z2labs/Bassberry/enclosure/README.md

# Enclosure

3D-printable enclosure (STEP + STL) - coming. Dimensions and chamber volumes: [../docs/acoustics.md](../docs/acoustics.md).
