z2labs/Bassberry/docs/img/pcb_bottom.png

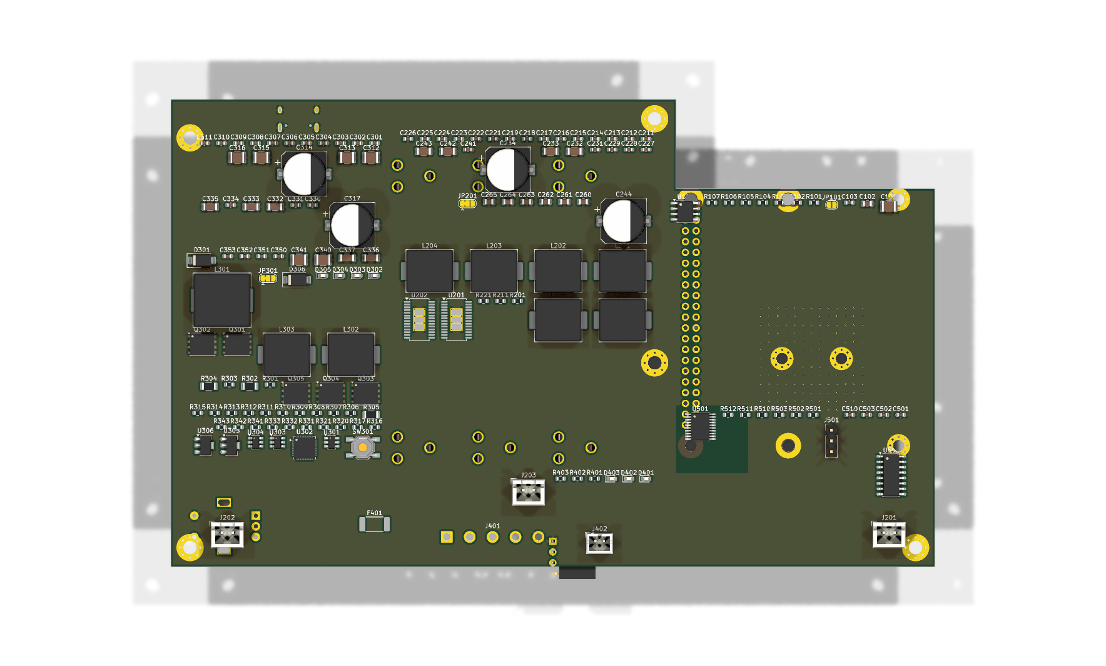
docs/img/pcb_bottom.png
