z2labs/Bassberry/docs/img/pcb_top.png

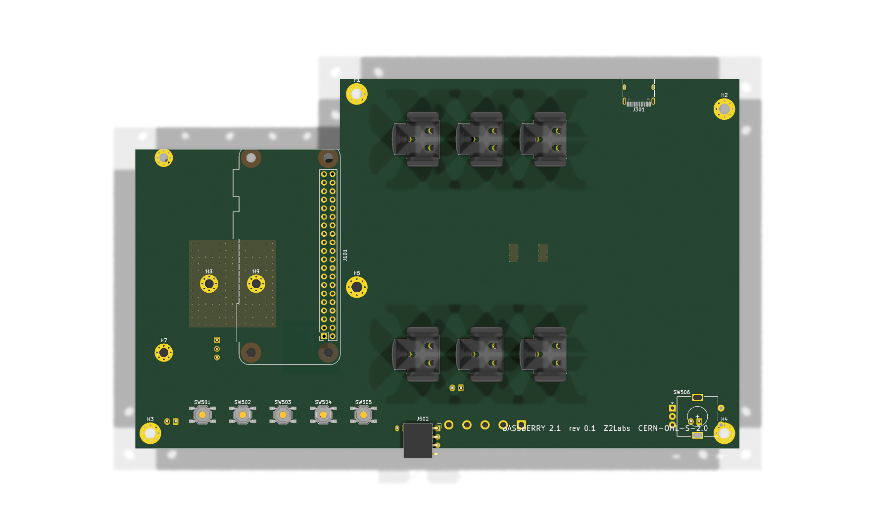
docs/img/pcb_top.png
