z2labs/Bassberry/hardware/bassberry/jlc/gerber_check.png

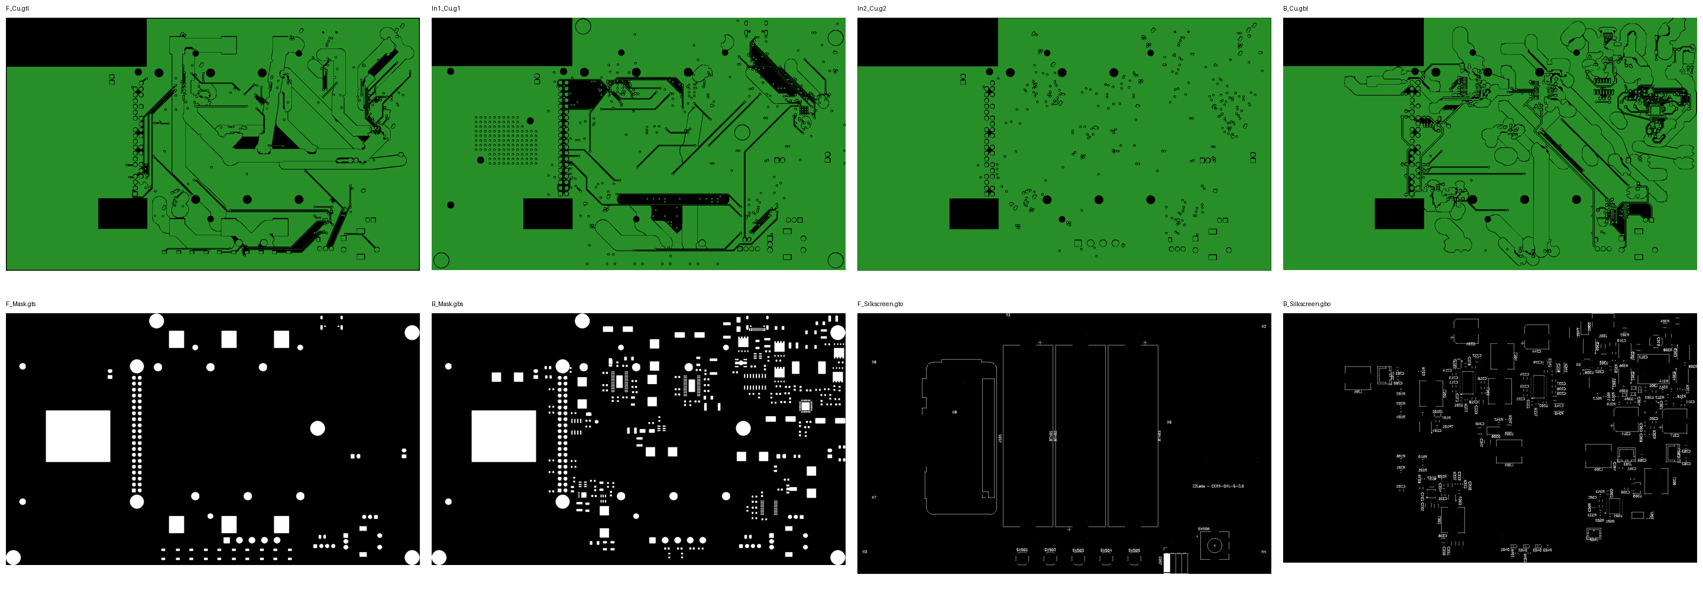
hardware/bassberry/jlc/gerber_check.png
