z2labs/Bassberry/docs/bom.md

# Bill of materials (draft)

Design rule: **cheap and easy to get**. Every electronic part should be stocked at LCSC / common distributors, and the mechanical parts should be printable or generic.
Prices are rough single-unit estimates (October 2026) and will change. *(tbc)* = to be confirmed in the schematic phase.

## Electronics

| Block | Part (proposal) | Qty | Why |
|---|---|---|---|
| Satellite amp | TI TAS5805M | 1 | I2S DAC + class-D + DSP in one chip, cheap, existing open Linux driver |
| Sub amp | TI TAS5805M (PBTL) | 1 | same part, so one footprint and one driver |
| PD sink + 3S charger | Injoinic IP2366 (QFN40) + 4× 30–40 V N-MOSFET (TDSON-8) + 22 µH | 1 | one chip for PD input and 2–6S buck-boost charging, mass-market part |
| Pack protection | off-the-shelf 3S BMS module (B-, B1, B2, B+, P-), 10 A fuse | 1 set | cheap, standard power-bank parts |
| 5.1 V / 5 A buck | TI TPS565208 (SOT-23-6) + 4.7 µH | 1 | enough for a Pi 5 |
| 17 V boost (optional) | MT3608 + SS34 | 1 | footprint present, can stay unfitted (PVDD_SUB jumper) |
| Supervisor MCU | WCH CH32V003 | 1 | costs a few cents, handles buttons, encoder and power latch |
| USB-UART | WCH CH340C + Torex XC6216B332PR (28 V LDO from VBUS) | 1 + 1 | serial console over the same USB-C port |
| Display | 1.3" I2C OLED module, 4-pin | 1 | everywhere, ≈ 2–3 |
| Encoder | EC11 with push switch | 1 | |
| Buttons | 6 × 6 mm tact switches | 5 | |
| 2×20 socket | standard 8.5 mm female header | 1 | |
| HAT ID EEPROM | onsemi CAT24C32 (SOIC-8) | 1 | the Pi detects the board as a HAT+ and loads its overlay |
| Back-power ideal diode | Diodes DMP3013SFV + DMMT5401 | 1 + 1 | HAT design guide safety diode, rated for the Pi 5's 5 A |
| Battery holders | Keystone 1042 (or any pin-compatible 18650 SMT holder) | 3 | snap-in, spring metal contacts, SMD |
| Thermal | aluminium block 24 × 24 × 6.7 mm + 1.5–2 mm gap pad | 1 | cut from bar stock, or a generic Pi heatsink |

## Acoustics

| Role | Reference (simulated) | Approx. price | Budget option |
|---|---|---|---|
| Satellites | 2× Dayton CE54N-4 | ≈ 12 each | generic 2" 4 Ω full-range, 52–54 mm frame |
| Sub | 1× Dayton ND91-4 | ≈ 28 | generic 3–3.5" long-throw BT-speaker woofer |
| Passive radiators | 2× Dayton DMA70-PR | ≈ 12 each | generic 2.5" rubber passive radiators (tune with added mass) |

The sub is where cheap parts hurt most. See the comparison in [acoustics.md](acoustics.md).
With generic drivers, measure their T/S parameters and re-run `acoustics/sim.py`.

## Mechanical

* Printed enclosure (PETG recommended), 2.5 mm walls, 100 % infill around the driver baffles, gasket on the acoustic divider
* Polyester fill in the satellite chambers
* 4 rubber feet, 18 mm (sub clearance)
* M2.5 hardware for the Pi, M3 for the enclosure
* Perforated metal or printed front grille
