z2labs/Bassberry/hardware/bassberry/jlc/lcsc_parts.csv

value | footprint | refs | lcsc | mpn | manufacturer | package | basic_or_extended | smt_or_tht | key_spec | verified_url | notes
10A fast 2512 | Fuse_2512_6332Metric | F401 | C44479 | 0451010.MRL | Littelfuse | 2410 (6.1x2.5mm) | Extended | SMT | 10A 125VDC very fast-acting NANO2, IR 35/50A | https://jlcpcb.com/partdetail/C44479 | Confirmed by Zoltan 2026-10-27 (in stock). No true 2512 (6332) 10A SMD fuse found at JLC/LCSC; nearest is 2410/6125 body - fits on 2512 pads in practice but better to change footprint to a 2410/NANO2 land pattern. LCSC stock ~28k. Note: 50A interrupt rating is low for a 3S 18650 pack short-circuit current
0R (V3=VCC for 3V3 op.) | R_0603_1608Metric | R512 | C21189 | 0603WAF0000T5E | UNI-ROYAL | 0603 | Basic | SMT | 0R jumper 100mW | https://jlcpcb.com/partdetail/C21189 | Confirmed by Zoltan 2026-10-27 (in stock).
10 | R_0603_1608Metric | R303 R306 | C22859 | 0603WAF100JT5E | UNI-ROYAL | 0603 | Basic | SMT | 10R 1% 100mW | https://jlcpcb.com/partdetail/C22859 | Confirmed by Zoltan 2026-10-27 (in stock).
100 | R_0603_1608Metric | R316 R317 | C22775 | 0603WAF1000T5E | UNI-ROYAL | 0603 | Basic | SMT | 100R 1% 100mW | https://jlcpcb.com/partdetail/C22775 | Confirmed by Zoltan 2026-10-27 (in stock).
100k | R_0603_1608Metric | R333 R343 | C25803 | 0603WAF1003T5E | UNI-ROYAL | 0603 | Basic | SMT | 100k 1% 100mW | https://jlcpcb.com/partdetail/C25803 | Confirmed by Zoltan 2026-10-27 (in stock).
100k 1% | R_0603_1608Metric | R502 | C25803 | 0603WAF1003T5E | UNI-ROYAL | 0603 | Basic | SMT | 100k 1% 100mW | https://jlcpcb.com/partdetail/C25803 | Confirmed by Zoltan 2026-10-27 (in stock).
10k | R_0603_1608Metric | R106 R201 R202 R315 R501 | C25804 | 0603WAF1002T5E | UNI-ROYAL | 0603 | Basic | SMT | 10k 1% 100mW | https://jlcpcb.com/partdetail/C25804 | Confirmed by Zoltan 2026-10-27 (in stock). LCSC page showed out of stock at check time; JLC basic stock is normally huge - check at order
10k 1% | R_0603_1608Metric | R108 R332 | C25804 | 0603WAF1002T5E | UNI-ROYAL | 0603 | Basic | SMT | 10k 1% 100mW | https://jlcpcb.com/partdetail/C25804 | Confirmed by Zoltan 2026-10-27 (in stock). see 10k row
15k | R_0603_1608Metric | R211 | C22809 | 0603WAF1502T5E | UNI-ROYAL | 0603 | Basic | SMT | 15k 1% 100mW | https://jlcpcb.com/partdetail/C22809 | Confirmed by Zoltan 2026-10-27 (in stock).
1k | R_0603_1608Metric | R107 R510 R511 | C21190 | 0603WAF1001T5E | UNI-ROYAL | 0603 | Basic | SMT | 1k 1% 100mW | https://jlcpcb.com/partdetail/C21190 | Confirmed by Zoltan 2026-10-27 (in stock).
2 | R_0603_1608Metric | R307 R308 R309 R320 R321 | C22977 | 0603WAF200KT5E | UNI-ROYAL | 0603 | Basic | SMT | 2R 1% 100mW | https://jlcpcb.com/partdetail/C22977 | Confirmed by Zoltan 2026-10-27 (in stock).
22k 1% | R_0603_1608Metric | R503 | C31850 | 0603WAF2202T5E | UNI-ROYAL | 0603 | Basic | SMT | 22k 1% 100mW | https://jlcpcb.com/partdetail/C31850 | Confirmed by Zoltan 2026-10-27 (in stock).
2k2 | R_0603_1608Metric | R401 R402 R403 | C4190 | 0603WAF2201T5E | UNI-ROYAL | 0603 | Basic | SMT | 2.2k 1% 100mW | https://jlcpcb.com/partdetail/C4190 | Confirmed by Zoltan 2026-10-27 (in stock).
2k2 1% | R_0603_1608Metric | R342 | C4190 | 0603WAF2201T5E | UNI-ROYAL | 0603 | Basic | SMT | 2.2k 1% 100mW | https://jlcpcb.com/partdetail/C4190 | Confirmed by Zoltan 2026-10-27 (in stock).
33 | R_0603_1608Metric | R101 R102 R103 | C23140 | 0603WAF330JT5E | UNI-ROYAL | 0603 | Basic | SMT | 33R 1% 100mW | https://jlcpcb.com/partdetail/C23140 | Confirmed by Zoltan 2026-10-27 (in stock).
3k6 1% | R_0603_1608Metric | R312 | C22980 | 0603WAF3601T5E | UNI-ROYAL | 0603 | Basic | SMT | 3.6k 1% 100mW | https://jlcpcb.com/partdetail/C22980 | Confirmed by Zoltan 2026-10-27 (in stock).
3k9 | R_0603_1608Metric | R104 R105 | C23018 | 0603WAF3901T5E | UNI-ROYAL | 0603 | Basic | SMT | 3.9k 1% 100mW | https://jlcpcb.com/partdetail/C23018 | Confirmed by Zoltan 2026-10-27 (in stock).
43k | R_0603_1608Metric | R314 | C23172 | 0603WAF4302T5E | UNI-ROYAL | 0603 | Extended | SMT | 43k 1% 100mW | https://jlcpcb.com/partdetail/C23172 | Confirmed by Zoltan 2026-10-27 (in stock). No Basic 43k; LCSC stock ~113k
47k | R_0603_1608Metric | R221 | C25819 | 0603WAF4702T5E | UNI-ROYAL | 0603 | Basic | SMT | 47k 1% 100mW | https://jlcpcb.com/partdetail/C25819 | Confirmed by Zoltan 2026-10-27 (in stock).
47k 1% | R_0603_1608Metric | R109 | C25819 | 0603WAF4702T5E | UNI-ROYAL | 0603 | Basic | SMT | 47k 1% 100mW | https://jlcpcb.com/partdetail/C25819 | Confirmed by Zoltan 2026-10-27 (in stock).
51 | R_0603_1608Metric | R301 | C23197 | 0603WAF510JT5E | UNI-ROYAL | 0603 | Basic | SMT | 51R 1% 100mW | https://jlcpcb.com/partdetail/C23197 | Confirmed by Zoltan 2026-10-27 (in stock).
57k6 1% | R_0603_1608Metric | R331 | C245983 | RC0603FR-0757K6L | YAGEO | 0603 | Extended | SMT | 57.6k 1% 100mW | https://jlcpcb.com/partdetail/C245983 | Confirmed by Zoltan 2026-10-27 (in stock). LCSC stock only ~400 at check time - OK for small runs; Uniroyal 0603WAF5762T5E not found at LCSC
60k4 1% | R_0603_1608Metric | R341 | C165742 | RC0603FR-0760K4L | YAGEO | 0603 | Extended | SMT | 60.4k 1% 100mW | https://jlcpcb.com/partdetail/C165742 | Confirmed by Zoltan 2026-10-27 (in stock). LCSC stock ~66k
6k2 1% | R_0603_1608Metric | R311 | C4260 | 0603WAF6201T5E | UNI-ROYAL | 0603 | Basic | SMT | 6.2k 1% 100mW | https://jlcpcb.com/partdetail/C4260 | Confirmed by Zoltan 2026-10-27 (in stock). Part/value verified (LCSC stock ~742k); fetched JLC page did not show the Basic label explicitly - Basic per JLC basic list
9k1 1% | R_0603_1608Metric | R313 | C286595 | RS-03K9101FT | FH (Fenghua) | 0603 | Extended | SMT | 9.1k 1% 100mW | https://jlcpcb.com/partdetail/C286595 | Confirmed by Zoltan 2026-10-27 (in stock). No Basic 9.1k found; LCSC stock ~162k
NC | R_0603_1608Metric | R310 | DNP |  |  |  |  | SMT |  |  | DNP
0R (bypass Q5) | R_1206_3216Metric | R305 | C346502 | HCJ1206ZT0R00 | Stackpole (SEI) | 1206 | Extended | SMT | 0R <=0.5mOhm, rated 38.7A (datasheet) | https://jlcpcb.com/partdetail/C346502 | Confirmed by Zoltan 2026-10-27 (in stock). Standard thick-film 1206 0R (e.g. C17888 1206W4F0000T5E) is typ. 2A only - not enough for 3A. LCSC stock ~3150
5m 1% 1206 | R_1206_3216Metric | R302 R304 | C601096 | HoLR1206-1W-5mR-1%-75ppm | Milliohm | 1206 | Extended | SMT | 5mOhm 1% 1W alloy, 75ppm/K | https://jlcpcb.com/partdetail/C601096 | Confirmed by Zoltan 2026-10-27 (in stock). LCSC stock ~10.6k. Alternatives: Yageo PA1206FRE470R005L C723548 (50ppm; out of stock) / Bourns CRF1206-FZ-R005ELF C4215834 (stock 47)
0R 2512 (PVDD_SUB = battery) | R_2512_6332Metric | R344 | C346503 | HCJ2512ZT0R00 | Stackpole (SEI) | 2512 | Extended | SMT | 0R <=0.5mOhm, 2W, rated 63.2A (datasheet) | https://jlcpcb.com/partdetail/C346503 | Confirmed by Zoltan 2026-10-27 (in stock). LCSC stock ~3980
DNP 0R 2512 (PVDD_SUB = boost) | R_2512_6332Metric | R345 | DNP |  |  |  |  | SMT |  |  | DNP (if fitted use C346503)
220u 35V polymer | CP_Elec_10x10.5 | C314 C317 | C278516 | EEHZK1V331P | Panasonic | SMD D10xL10.2mm | Extended | SMT | 330uF 35V hybrid polymer Al; ESR 20mOhm | https://jlcpcb.com/partdetail/C278516 | Confirmed by Zoltan 2026-10-27 (in stock). Nearest STOCKED fit: 330uF instead of 220uF (LCSC 4869 pcs on 2026-10-27). Exact 220uF/35V EEHZA1V221P C454349 (D10xL10.2, ESR 20mOhm, 2.5A@100kHz) exists but LCSC shows Out of Stock; alt Rubycon 35PJV330M10X10.5 C3274921 (330uF 35V hybrid, 1000 pcs)
470u 25V low-ESR | CP_Elec_10x10.5 | C234 C244 | C248607 | EEEFK1E471P | Panasonic | SMD D10xL10.2mm | Extended | SMT | 470uF 25V Al electrolytic FK low-impedance series; 105C 2000h | https://jlcpcb.com/partdetail/C248607 | Confirmed by Zoltan 2026-10-27 (in stock). LCSC stock 7217. ESR not listed on page (FK series is Panasonic's low-Z line, check datasheet if ripple critical). Hybrid-polymer alt: Rubycon 25PJV470MSPA10X10.5 C239327 (2315 pcs)
100n | C_0603_1608Metric | C103 C104 C212 C222 C307 C330 C501 C503 C510 | C14663 | CC0603KRX7R9BB104 | YAGEO | 0603 | Basic | SMT | 100nF 50V X7R 10% | https://jlcpcb.com/partdetail/C14663 | Confirmed by Zoltan 2026-10-27 (in stock).
100n 50V | C_0603_1608Metric | C219 C229 C231 C241 C308 C309 C334 | C14663 | CC0603KRX7R9BB104 | YAGEO | 0603 | Basic | SMT | 100nF 50V X7R 10% | https://jlcpcb.com/partdetail/C14663 | Confirmed by Zoltan 2026-10-27 (in stock). Same part as plain 100n line
1u | C_0603_1608Metric | C213 C214 C223 C224 C303 C351 C353 C502 | C15849 | CL10A105KB8NNNC | Samsung Electro-Mechanics | 0603 | Basic | SMT | 1uF 50V X5R 10% | https://jlcpcb.com/partdetail/C15849 | Confirmed by Zoltan 2026-10-27 (in stock).
1u 25V | C_0603_1608Metric | C350 | C15849 | CL10A105KB8NNNC | Samsung Electro-Mechanics | 0603 | Basic | SMT | 1uF 50V X5R 10% | https://jlcpcb.com/partdetail/C15849 | Confirmed by Zoltan 2026-10-27 (in stock). 50V rating covers 25V
1u 35V | C_0603_1608Metric | C352 | C15849 | CL10A105KB8NNNC | Samsung Electro-Mechanics | 0603 | Basic | SMT | 1uF 50V X5R 10% | https://jlcpcb.com/partdetail/C15849 | Confirmed by Zoltan 2026-10-27 (in stock). 50V rating covers 35V
220n | C_0603_1608Metric | C215 C216 C217 C218 C225 C226 C227 C228 | C21120 | CL10B224KA8NNNC | Samsung Electro-Mechanics | 0603 | Basic | SMT | 220nF 25V X7R 10% | https://jlcpcb.com/partdetail/C21120 | Confirmed by Zoltan 2026-10-27 (in stock).
2u2 | C_0603_1608Metric | C305 C306 | C23630 | CL10A225KO8NNNC | Samsung Electro-Mechanics | 0603 | Basic | SMT | 2.2uF 16V X5R 10% | https://jlcpcb.com/partdetail/C23630 | Confirmed by Zoltan 2026-10-27 (in stock).
2u2 35V | C_0603_1608Metric | C302 C304 | C307463 | CL10A225KL8NNNC | Samsung Electro-Mechanics | 0603 | Extended | SMT | 2.2uF 35V X5R 10% | https://jlcpcb.com/partdetail/C307463 | Confirmed by Zoltan 2026-10-27 (in stock). LCSC stock 8750; no Basic 0603 2.2uF >=35V
3n3 50V | C_0603_1608Metric | C310 C311 | C152910 | 0603N332J500CT | Walsin | 0603 | Extended | SMT | 3.3nF 50V NP0/C0G 5% | https://jlcpcb.com/partdetail/C152910 | Confirmed by Zoltan 2026-10-27 (in stock). LCSC stock 62000. Basic C1613 is X7R (not C0G); Samsung CL10C332JB8NNNC C55395 is C0G but LCSC out of stock
470n | C_0603_1608Metric | C301 | C1623 | CL10B474KA8NNNC | Samsung Electro-Mechanics | 0603 | Basic | SMT | 470nF 25V X7R 10% | https://jlcpcb.com/partdetail/C1623 | Confirmed by Zoltan 2026-10-27 (in stock).
47p | C_0603_1608Metric | C331 | C1671 | CL10C470JB8NNNC | Samsung Electro-Mechanics | 0603 | Basic | SMT | 47pF 50V C0G 5% | https://jlcpcb.com/partdetail/C1671 | Confirmed by Zoltan 2026-10-27 (in stock).
4u7 | C_0603_1608Metric | C211 C221 | C19666 | CL10A475KO8NNNC | Samsung Electro-Mechanics | 0603 | Basic | SMT | 4.7uF 16V X5R 10% | https://jlcpcb.com/partdetail/C19666 | Confirmed by Zoltan 2026-10-27 (in stock).
10u | C_0805_2012Metric | C102 | C15850 | CL21A106KAYNNNE | Samsung Electro-Mechanics | 0805 | Basic | SMT | 10uF 25V X5R 10% | https://jlcpcb.com/partdetail/C15850 | Confirmed by Zoltan 2026-10-27 (in stock).
680n 50V | C_0805_2012Metric | C260 C261 C262 C263 C264 C265 | C472832 | CL21B684KBFVPNE | Samsung Electro-Mechanics | 0805 | Extended | SMT | 680nF 50V X7R 10% | https://jlcpcb.com/partdetail/C472832 | Confirmed by Zoltan 2026-10-27 (in stock). LCSC stock 5075 (enough for 6/board but modest for volume runs)
10u 25V | C_1206_3216Metric | C332 C333 | C13585 | CL31A106KBHNNNE | Samsung Electro-Mechanics | 1206 | Basic | SMT | 10uF 50V X5R 10% | https://jlcpcb.com/partdetail/C13585 | Confirmed by Zoltan 2026-10-27 (in stock). 50V rating covers 25V
22u 10V | C_1206_3216Metric | C335 C336 C337 | C12891 | CL31A226KAHNNNE | Samsung Electro-Mechanics | 1206 | Basic | SMT | 22uF 25V X5R 10% | https://jlcpcb.com/partdetail/C12891 | Confirmed by Zoltan 2026-10-27 (in stock). 25V rating covers 10V
22u 25V | C_1206_3216Metric | C232 C233 C242 C243 | C12891 | CL31A226KAHNNNE | Samsung Electro-Mechanics | 1206 | Basic | SMT | 22uF 25V X5R 10% | https://jlcpcb.com/partdetail/C12891 | Confirmed by Zoltan 2026-10-27 (in stock). Rated exactly 25V; heavy DC-bias derating (1206 X5R, expect well under half of 22uF at 12-20V)
100u 6.3V | C_1210_3225Metric | C101 | C49066 | CL32A107MQVNNNE | Samsung Electro-Mechanics | 1210 | Extended | SMT | 100uF 6.3V X5R 20% | https://jlcpcb.com/partdetail/C49066 | Confirmed by Zoltan 2026-10-27 (in stock). LCSC stock 126002. Basic C15008 is 1206 (does not match 1210 footprint)
22u 25V | C_1210_3225Metric | C340 C341 | C52306 | CL32A226KAJNNNE | Samsung Electro-Mechanics | 1210 | Extended | SMT | 22uF 25V X5R 10% | https://jlcpcb.com/partdetail/C52306 | Confirmed by Zoltan 2026-10-27 (in stock). LCSC stock 153148; no Basic 1210 22uF
22u 35V | C_1210_3225Metric | C312 C313 C315 C316 | C778721 | GMK325BJ226MM-P | Taiyo Yuden | 1210 | Extended | SMT | 22uF 35V X5R 20% | https://jlcpcb.com/partdetail/C778721 | Confirmed by Zoltan 2026-10-27 (in stock). LCSC stock 163870
18650 cell 1 (BH-18650-B1BA002) | BatteryHolder_MYOUNG_BH-18650-B1BA002 | BT401 | C2988620 | BH-18650-B1BA002 | MYOUNG | SMD tabs (18650 holder), BATTERY-SMD_18650-1S-L77.1-W20.7 | Extended | SMT holder (JLC lists it as an assembly part) | 1x18650 holder, gold-plated phosphor bronze, -25..85 C | https://jlcpcb.com/partdetail/C2988620 | Confirmed by Zoltan 2026-10-27 (in stock, replaces Keystone 1042 C5249310). Own footprint from drawing WD-CP-0088: contacts 79.26 mm apart, D2.40 peg hole; pad 1 = '-', pad 2 = '+' as JLC's model.
18650 cell 2 (BH-18650-B1BA002) | BatteryHolder_MYOUNG_BH-18650-B1BA002 | BT402 | C2988620 | BH-18650-B1BA002 | MYOUNG | SMD tabs (18650 holder), BATTERY-SMD_18650-1S-L77.1-W20.7 | Extended | SMT holder (JLC lists it as an assembly part) | 1x18650 holder, gold-plated phosphor bronze, -25..85 C | https://jlcpcb.com/partdetail/C2988620 | Confirmed by Zoltan 2026-10-27 (in stock, replaces Keystone 1042 C5249310). Own footprint from drawing WD-CP-0088: contacts 79.26 mm apart, D2.40 peg hole; pad 1 = '-', pad 2 = '+' as JLC's model.
18650 cell 3 (BH-18650-B1BA002) | BatteryHolder_MYOUNG_BH-18650-B1BA002 | BT403 | C2988620 | BH-18650-B1BA002 | MYOUNG | SMD tabs (18650 holder), BATTERY-SMD_18650-1S-L77.1-W20.7 | Extended | SMT holder (JLC lists it as an assembly part) | 1x18650 holder, gold-plated phosphor bronze, -25..85 C | https://jlcpcb.com/partdetail/C2988620 | Confirmed by Zoltan 2026-10-27 (in stock, replaces Keystone 1042 C5249310). Own footprint from drawing WD-CP-0088: contacts 79.26 mm apart, D2.40 peg hole; pad 1 = '-', pad 2 = '+' as JLC's model.
SMAJ24A | D_SMA | D301 | C113962 | SMAJ24A | MDD (Microdiode) | DO-214AC (SMA) | Extended | SMT | TVS uni, Vrwm 24V | https://jlcpcb.com/partdetail/C113962 | Confirmed by Zoltan 2026-10-27 (in stock). No Basic SMAJ24A found. Alternates (verified, Extended): C10769 RUILON, C3001960 UMW. Cathode band = pad 1 on D_SMA.
SS34 | D_SMA | D306 | C8678 | SS34 | MDD (Microdiode) | DO-214AC (SMA) | Basic | SMT | Schottky 40V 3A | https://jlcpcb.com/partdetail/C8678 | Confirmed by Zoltan 2026-10-27 (in stock).
DMP3013SFV | Diodes_PowerDI3333-8 | Q101 | C264098 | DMP3013SFV-7 | Diodes Inc | PowerDI3333-8 | Extended | SMT | P-MOS -30V, 17mR@4.5V (JLC), Id 12A | https://jlcpcb.com/partdetail/C461071 | Same part as DMP3013SFV-13 (C461071, JLC shortfall), other reel; land pattern fit checked (jlc_rotfix).
TAS5805M | HTSSOP-28-1EP_4.4x9.7mm_P0.65mm_EP2.85x5.4mm_ThermalVias | U201 U202 | C478472 | TAS5805MPWPR | Texas Instruments | HTSSOP-28-EP (PWP) | Extended | SMT | 23W stereo class-D, I2S/I2C | https://jlcpcb.com/partdetail/C478472 | Confirmed by Zoltan 2026-10-27 (in stock). Exact part. Cross-check footprint EP size (2.85x5.4) against TI PWP land pattern in datasheet.
NTC 10k B3380 on cell | JST_PH_B2B-PH-K_1x02_P2.00mm_Vertical | J402 | C131337 | B2B-PH-K-S(LF)(SN) | JST | PH 2.0mm 1x2 vertical | Extended | THT | 2P 2.0mm vertical header | https://jlcpcb.com/partdetail/C131337 | Confirmed by Zoltan 2026-10-27 (in stock). Genuine JST; THT -> JLC THT/hand-solder service.
SAT LEFT | JST_XH_B2B-XH-A_1x02_P2.50mm_Vertical | J201 | C158012 | B2B-XH-A(LF)(SN) | JST | XH 2.5mm 1x2 vertical | Extended | THT | 2P 2.5mm vertical header, 3A | https://jlcpcb.com/partdetail/C158012 | Confirmed by Zoltan 2026-10-27 (in stock). Genuine JST. Alt verified: C2683608 (B2B-XH-A-MB2P-VH, JST).
SAT RIGHT | JST_XH_B2B-XH-A_1x02_P2.50mm_Vertical | J202 | C158012 | B2B-XH-A(LF)(SN) | JST | XH 2.5mm 1x2 vertical | Extended | THT | 2P 2.5mm vertical header | https://jlcpcb.com/partdetail/C158012 | Confirmed by Zoltan 2026-10-27 (in stock).
SUB | JST_XH_B2B-XH-A_1x02_P2.50mm_Vertical | J203 | C158012 | B2B-XH-A(LF)(SN) | JST | XH 2.5mm 1x2 vertical | Extended | THT | 2P 2.5mm vertical header | https://jlcpcb.com/partdetail/C158012 | Confirmed by Zoltan 2026-10-27 (in stock).
LED red 0603 (reverse cell) | LED_0603_1608Metric | D401 D402 D403 | C2286 | KT-0603R | Hubei KENTO | 0603 | Basic | SMT | Red, water-clear lens | https://jlcpcb.com/partdetail/C2286 | Confirmed by Zoltan 2026-10-27 (in stock). Check polarity mark vs footprint pad 1 (cathode).
LED white 0603 | LED_0603_1608Metric | D302 D303 D304 D305 | C2290 | KT-0603W | Hubei KENTO | 0603 | Basic | SMT | White | https://jlcpcb.com/partdetail/C2290 | Confirmed by Zoltan 2026-10-27 (in stock).
10u 3A shielded | L_Changjiang_FXL1040 | L201 L202 L203 L204 | C475915 | FXL1040-100-M | Changjiang (cjiang) | SMD 11.5x10x3.8 (FXL1040) | Extended | SMT | 10uH, DCR 30mR max, Isat 6.8A min/8.5A typ, Irms 6.9/7.8A | https://jlcpcb.com/partdetail/C475915 | Confirmed by Zoltan 2026-10-27 (in stock). Exact series/footprint. Molded alloy (shielded). Meets 3A with margin.
10u 4A | L_Changjiang_FXL1040 | L303 | C475915 | FXL1040-100-M | Changjiang (cjiang) | SMD 11.5x10x3.8 (FXL1040) | Extended | SMT | 10uH, DCR 30mR, Isat 6.8A min, Irms 6.9A | https://jlcpcb.com/partdetail/C475915 | Confirmed by Zoltan 2026-10-27 (in stock). Meets 4A.
4u7 7A | L_Changjiang_FXL1040 | L302 | C167230 | FXL1040-4R7-M | Changjiang (cjiang) | SMD 11.5x10x3.8 (FXL1040) | Extended | SMT | 4.7uH, DCR 20mR max, Isat 10.4A min/15A typ, Irms 7.5A (20C rise)/9A (40C rise) | https://jlcpcb.com/partdetail/C167230 | Confirmed by Zoltan 2026-10-27 (in stock). Meets 7A.
10u 5A shielded | L_Changjiang_FXL1050 | L205 L206 | C5359264 | FXL1050-100-M | Changjiang (cjiang) | SMD 11.5x10x4.8 (FXL1050) | Extended | SMT | 10uH, DCR 28mR max, Isat 8.8A min/10A typ, Irms 7/8A | https://jlcpcb.com/partdetail/C5359264 | Confirmed by Zoltan 2026-10-27 (in stock). Meets 5A.
22u >=10A Rdc<10m | L_Sunlord_MWSA1265S | L301 | C526028 | FXL1360-220-M | Changjiang (cjiang) | SMD 13.5x12.6x6.0 | Extended | SMT | 22uH, DCR 39.5mR max, Isat 7.5A, Irms 5A | https://jlcpcb.com/partdetail/C526028 | 22 uH, Isat 7.5 A, 39.5 mOhm: below the original >=10 A wish but above the 3-4 A of the 30 W charger; terminals at +-6.0 mm land on the MWSA1265S pads (+-5.6 mm, 3.25 mm wide) - fit checked.
SWIO (WCH-LinkE) | PinHeader_1x03_P2.54mm_Vertical | J501 | C49257 | 2.54-1*3PPin | BOOMELE | 1x3P 2.54mm THT | Extended | THT | 1x3 male pin header | https://jlcpcb.com/partdetail/C49257 | Confirmed by Zoltan 2026-10-27 (in stock). Page does not state straight explicitly (standard BOOMELE straight header). Alt PZ254V-11-03P C2937625 (not checked).
OLED 1.3in I2C (GND VCC SCL SDA) | PinSocket_1x04_P2.54mm_Horizontal | J502 | C2897386 | PM254-1-04-W-8.5 | HCTL |  | Extended | THT | 1x4 female, 2.54 mm, right-angle | https://jlcpcb.com/partdetail/C2897386 | Right-angle 1x4 female (LCSC stock ~9250); pins fit the PinSocket_1x04 Horizontal pads (jlc_rotfix). Fallback C88278 BOOMELE.
IP2366 | QFN-40-1EP_5x5mm_P0.4mm_EP3.6x3.6mm_ThermalVias | U302 | C20415848 | IP2366 (I2C version) | Injoinic | QFN-40 (5x5) | Extended | SMT | Bidirectional 2-6S buck-boost charger, USB-C PD3.1 140W | https://jlcpcb.com/partdetail/C20415848 | Confirmed by Zoltan 2026-10-27 (in stock). Only the I2C version found at LCSC; confirm schematic is for I2C variant (pin functions may differ from standard IP2366). JLC global-sourcing listing C9900211520 shows EP 3.4 mm - check footprint EP 3.6 vs datasheet.
RPi 40-pin (face-down socket) | Raspberry_Pi_Zero_Socketed_THT_FaceDown_MountingHoles | J101 | C2977589 | 2.54-2*20 | ZHOURI | 2x20P 2.54mm female, 8.5mm insulator | Extended | THT | 2x20 female, 8.5 mm high | https://jlcpcb.com/partdetail/C2977589 | Confirmed by Zoltan 2026-10-27 (in stock). Matches 8.5mm stacking height spec.
EC11 encoder + push | RotaryEncoder_Alps_EC11E-Switch_Vertical_H20mm | SW506 | C470754 | EC11E15244B2 | Alps Alpine | EC11E vertical THT | Extended | THT | 15 ppr / 30 detents, push switch, 20 mm shaft (RS) | https://jlcpcb.com/partdetail/C370970 | Sister of EC11E15244G1 (C370970, JLC shortfall): 20 mm D-flat shaft, 30 detents/15 pulses, push switch; land pattern fit checked. JLC offered C361165 EC11E1834403 has no detents - not used.
CH340C | SOIC-16_3.9x9.9mm_P1.27mm | U502 | C84681 | CH340C | WCH | SOP-16 | Extended | SMT | USB-UART, internal osc | https://jlcpcb.com/partdetail/C84681 | WCH CH340C SOP-16 (C7464026 was out of stock); land pattern fit checked.
CAT24C32WI-GT3 | SOIC-8_3.9x4.9mm_P1.27mm | U101 | C81193 | CAT24C32WI-GT3 | onsemi | SOIC-8 | Extended | SMT | 32kbit I2C EEPROM | https://jlcpcb.com/partdetail/C81193 | Confirmed by Zoltan 2026-10-27 (in stock). Exact part.
DMMT5401 | SOT-23-6 | Q102 | C154733 | DMMT5401-7-F | Diodes Inc | SOT-26 (SC-74R) | Extended | SMT | Dual matched PNP, Vceo 150V | https://jlcpcb.com/partdetail/C154733 | Confirmed by Zoltan 2026-10-27 (in stock). Exact part. SOT-26 fits SOT-23-6 footprint; verify symbol pin map vs DMMT5401 datasheet pinout.
MT3608 | SOT-23-6 | U304 | C84817 | MT3608 | XI'AN Aerosemi | SOT-23-6 | Extended | SMT | Boost, Vin 2-24V, 4A switch | https://jlcpcb.com/partdetail/C84817 | Confirmed by Zoltan 2026-10-27 (in stock). No longer Basic. Vin max 24V.
TPS565208 | SOT-23-6 | U303 | C2650336 | TPS565208DDCR | Texas Instruments | TSOT-23-6 (DDC) | Extended | SMT | Sync buck 4.5-17V in, 5A | https://jlcpcb.com/partdetail/C2650336 | Confirmed by Zoltan 2026-10-27 (in stock). Exact part. Note Vin max 17V (abs 19V).
USBLC6-2SC6 | SOT-23-6 | U301 | C7519 | USBLC6-2SC6 | STMicroelectronics | SOT-23-6L | Extended | SMT | USB ESD, 2 lines | https://jlcpcb.com/partdetail/C7519 | Confirmed by Zoltan 2026-10-27 (in stock). Exact ST part.
HT7533-1 | SOT-89-3 | U305 | C14289 | HT7533-1 | Holtek | SOT-89-3 | Basic | SMT | LDO 3.3V 100mA, Vin max 30V | https://jlcpcb.com/partdetail/C14289 | Confirmed by Zoltan 2026-10-27 (in stock). SOT-89 pinout 1=GND 2=VIN 3=VOUT: check symbol.
XC6216B332PR | SOT-89-5 | U306 | NOPART | XC6216B332PR-G | Torex | SOT-89-5 |  | SMT | LDO 3.3V 150mA, Vin 28V |  | NOT AT LCSC: no 3.3 V XC6216 in SOT-89-5 (only XC6216B802PR-G 8 V, C725707). Order XC6216B332PR-G through JLC Global Sourcing (Mouser/Digikey) or consign. Alternative needs a footprint change: HT7533-1 C14289 (Basic, SOT-89-3: 1 GND 2 VIN 3 VOUT, 30 V) - at a 20 V PD contract it dissipates ~0.25 W, its whole SOT-89 rating.
BT | SW_SPST_TL3342 | SW502 | C2886898 | TL3342F160QG | E-Switch | SMD-4P 5.2x5.2x1.54 | Extended | SMT | Tact 1.6N | https://jlcpcb.com/partdetail/C2886898 | Confirmed by Zoltan 2026-10-27 (in stock). Exact E-Switch part; body is 5.2x5.2 mm (not 4.2x3.2) = native TL3342 footprint.
PLAY/PAUSE | SW_SPST_TL3342 | SW503 | C2886898 | TL3342F160QG | E-Switch | SMD-4P 5.2x5.2 | Extended | SMT | Tact 1.6N | https://jlcpcb.com/partdetail/C2886898 | Confirmed by Zoltan 2026-10-27 (in stock).
POWER | SW_SPST_TL3342 | SW501 | C2886898 | TL3342F160QG | E-Switch | SMD-4P 5.2x5.2 | Extended | SMT | Tact 1.6N | https://jlcpcb.com/partdetail/C2886898 | Confirmed by Zoltan 2026-10-27 (in stock).
PWRBANK (optional) | SW_SPST_TL3342 | SW301 | NOPART |  |  |  |  |  |  |  | DNP
VOL+ | SW_SPST_TL3342 | SW505 | C2886898 | TL3342F160QG | E-Switch | SMD-4P 5.2x5.2 | Extended | SMT | Tact 1.6N | https://jlcpcb.com/partdetail/C2886898 | Confirmed by Zoltan 2026-10-27 (in stock).
VOL- | SW_SPST_TL3342 | SW504 | C2886898 | TL3342F160QG | E-Switch | SMD-4P 5.2x5.2 | Extended | SMT | Tact 1.6N | https://jlcpcb.com/partdetail/C2886898 | Confirmed by Zoltan 2026-10-27 (in stock).
EEPROM write enable | SolderJumper-2_P1.3mm_Open_RoundedPad1.0x1.5mm | JP101 | NOPART |  |  |  |  |  |  |  | Solder jumper
U2 SDIN: Pi / U1 SDOUT | SolderJumper-3_P1.3mm_Bridged12_RoundedPad1.0x1.5mm | JP201 | NOPART |  |  |  |  |  |  |  | Solder jumper
3S BMS module (B-,B1,B2,B+,P-) | SolderWire-1sqmm_1x05_P5.4mm_D1.4mm_OD2.7mm | J401 | NOPART |  |  |  |  |  |  |  | Wire pads
30V N-MOS (RU3030M2) opt. | TDSON-8-1 | Q305 | NOPART |  |  |  |  |  |  |  | DNP
40V N-MOS 5mR (AER4061BE equiv) | TDSON-8-1 | Q301 Q302 Q303 Q304 | C151526 | BSC059N04LS G | Infineon | TDSON-8 (5x6) | Extended | SMT | N-MOS 40V 85A, 5.0mR@10V (MPN rating; Rds not shown on JLC page), Vth 2V, Qg 47nC@10V | https://jlcpcb.com/partdetail/C534347 | 40 V, 5.9 mOhm @10 V, same TDSON-8 family as BSC050N04LS G (C534347, JLC shortfall); land pattern fit checked. 30 V alternative with more stock: AON6354 C404363 (5.2 mOhm @4.5 V).
CH32V003F4P6 | TSSOP-20_4.4x6.5mm_P0.65mm | U501 | C5187096 | CH32V003F4P6 | WCH | TSSOP-20 | Extended | SMT | RISC-V MCU 16K flash | https://jlcpcb.com/partdetail/C5187096 | Confirmed by Zoltan 2026-10-27 (in stock). Note: C5299908 is the QFN-20 CH32V003F4U6 - do not use.
ID_WP | TestPoint_Pad_D1.5mm | TP101 | NOPART |  |  |  |  |  |  |  | Test point
USB-C (charge + console) | USB_C_Receptacle_HRO_TYPE-C-31-M-12 | J301 | C165948 | TYPE-C-31-M-12 | Korean Hroparts (HRO) | SMD 16P USB-C, with THT shell pegs | Extended | SMT (shell legs THT, JLC handles as SMT part) | USB-C receptacle 16-pin | https://jlcpcb.com/partdetail/C165948 | Confirmed by Zoltan 2026-10-27 (in stock). Exact part.
