z2labs/Bassberry/hardware/bassberry/bassberry_sch.pdf

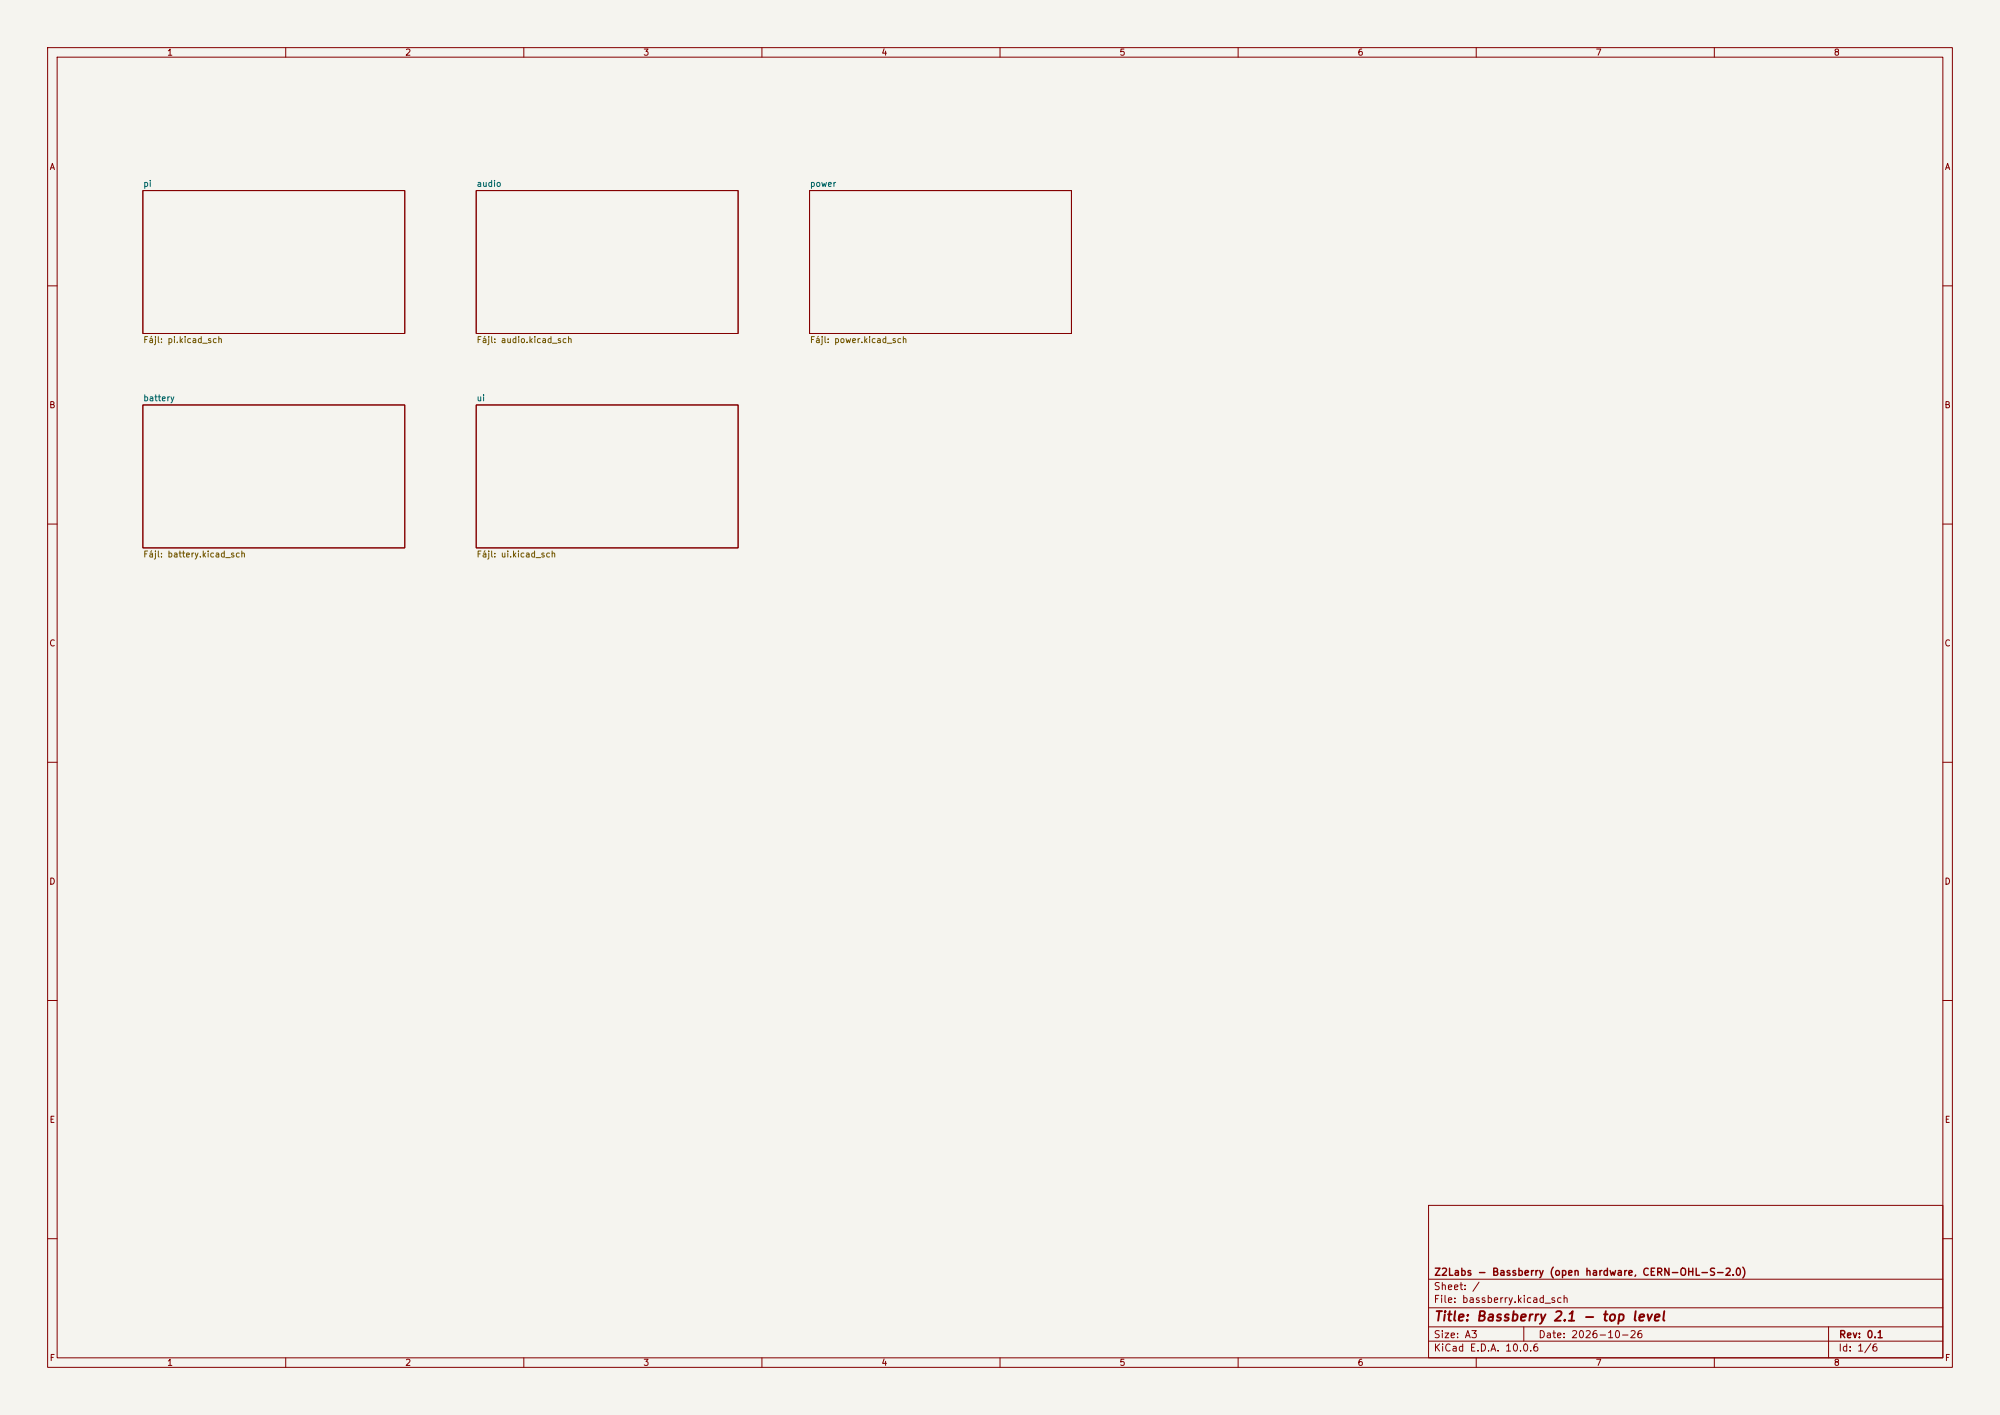
[picture p19: page 1]

Z2Labs - Bassberry (open hardware, CERN-OHL-S-2.0)
Sheet: /
File: bassberry.kicad_sch
Title: Bassberry 2.1 - top level

Size: A3 | Rev: 0.1 | F Date: 2026-10-26
KiCad E.D.A. 10.0.6 | Id: 1/6

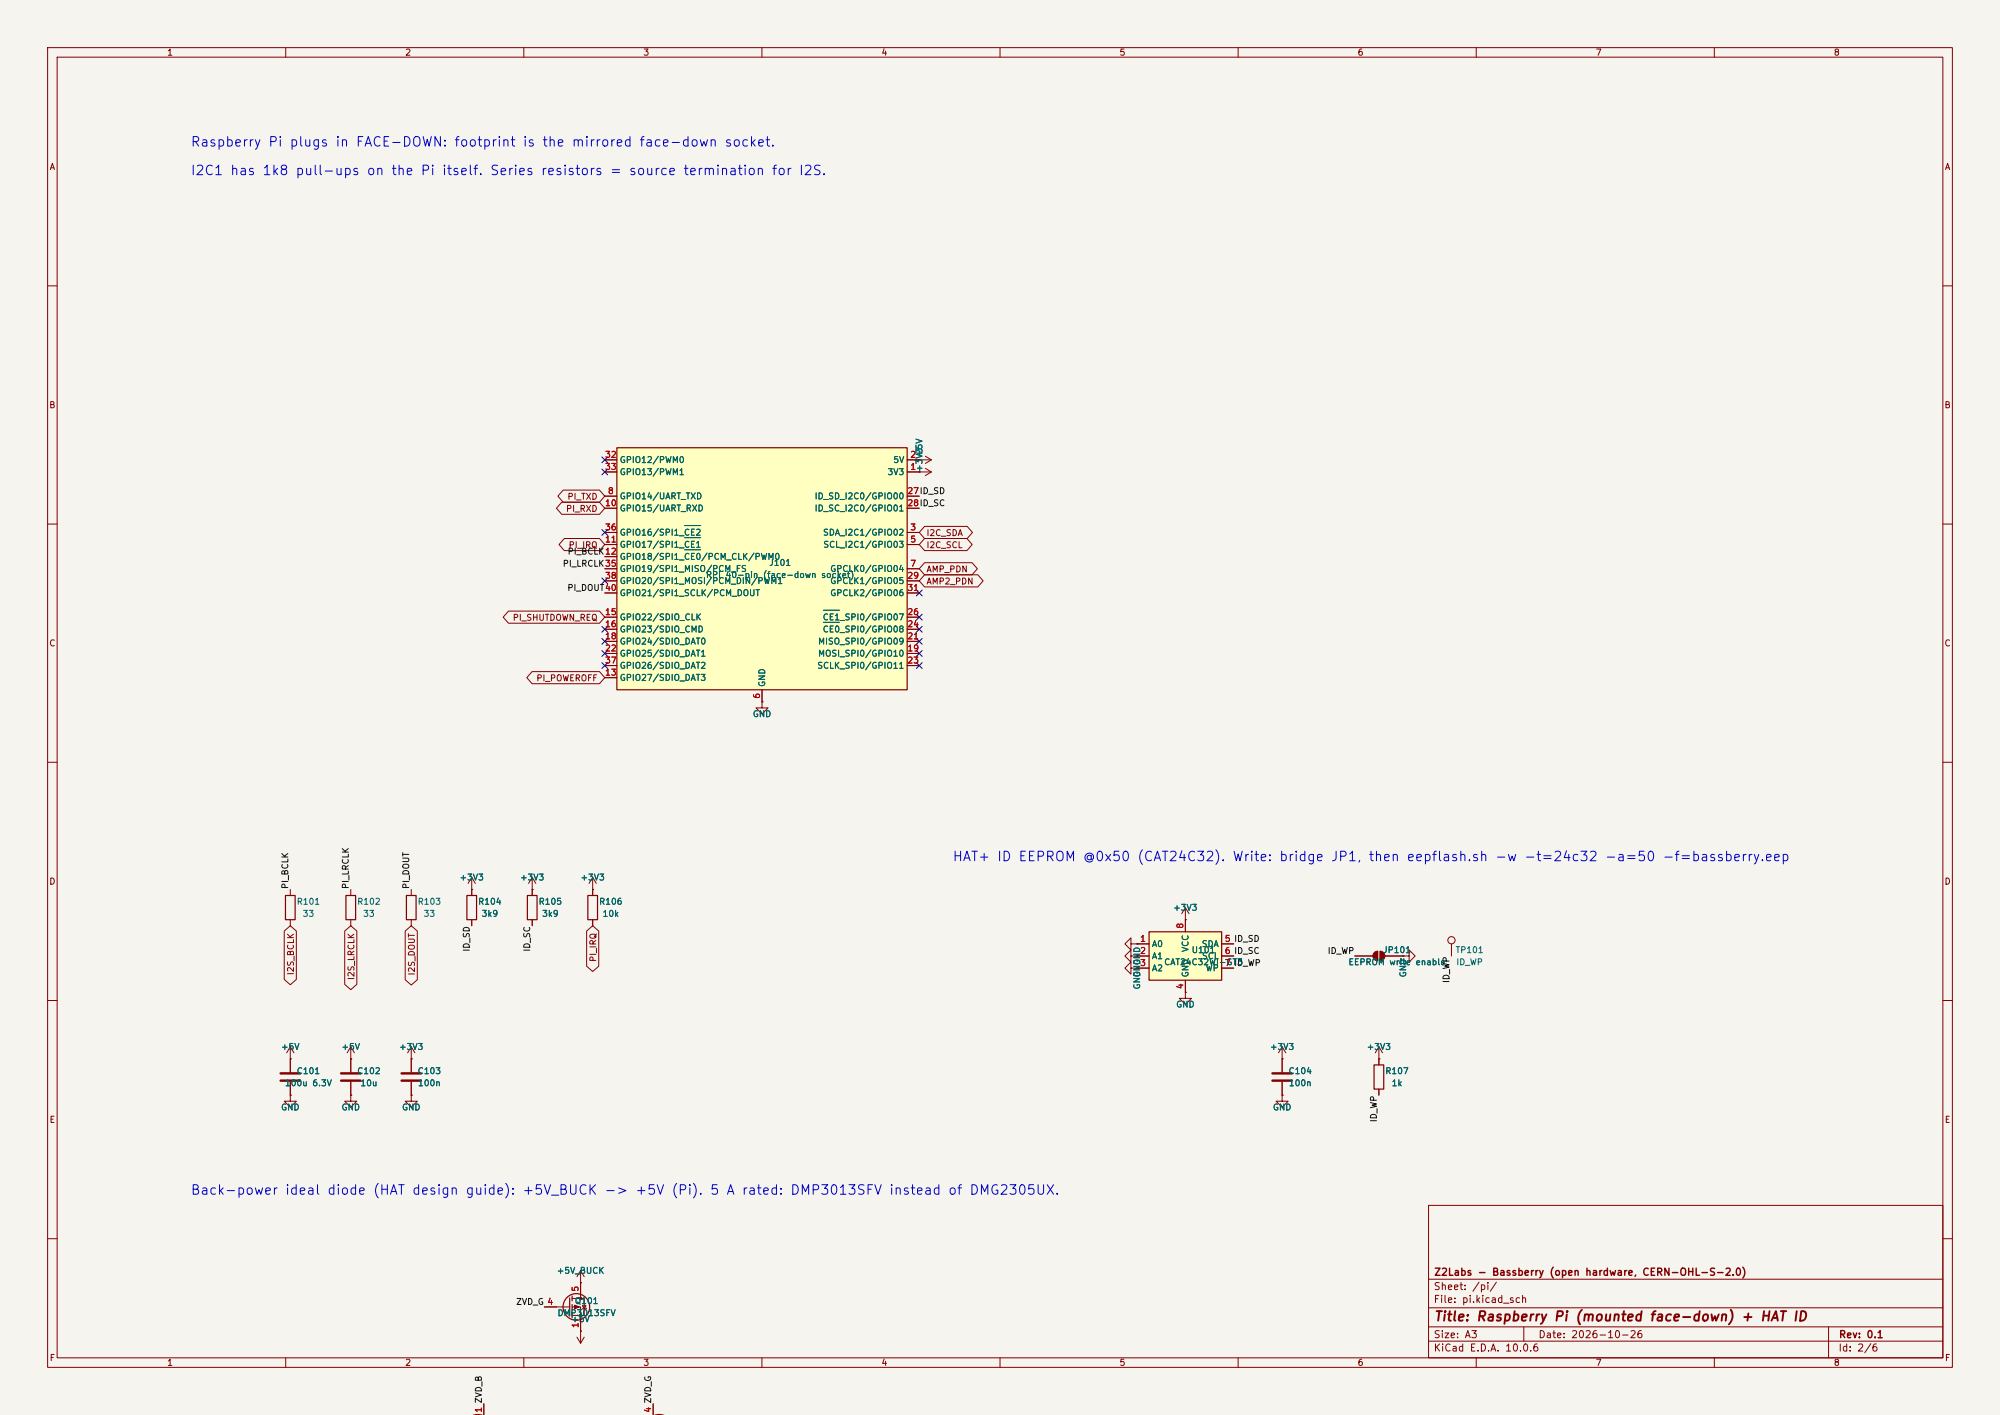
[picture p20: page 2]

Raspberry Pi plugs in FACE-DOWN: footprint is the mirrored face-down socket.

Z2Labs - Bassberry (open hardware, CERN-OHL-S-2.0) +3V3

HAT+ ID EEPROM @0x50 (CAT24C32). Write: bridge JP1, then eepflash.sh -w -t=24c32 -a=50 -f=bassberry.eep

EEPROM write enable GND

Back-power ideal diode (HAT design guide): +5V_BUCK -> +5V (Pi). 5 A rated: DMP3013SFV instead of DMG2305UX.

Sheet: /pi/
File: pi.kicad_sch
Title: Raspberry Pi (mounted face-down) + HAT ID

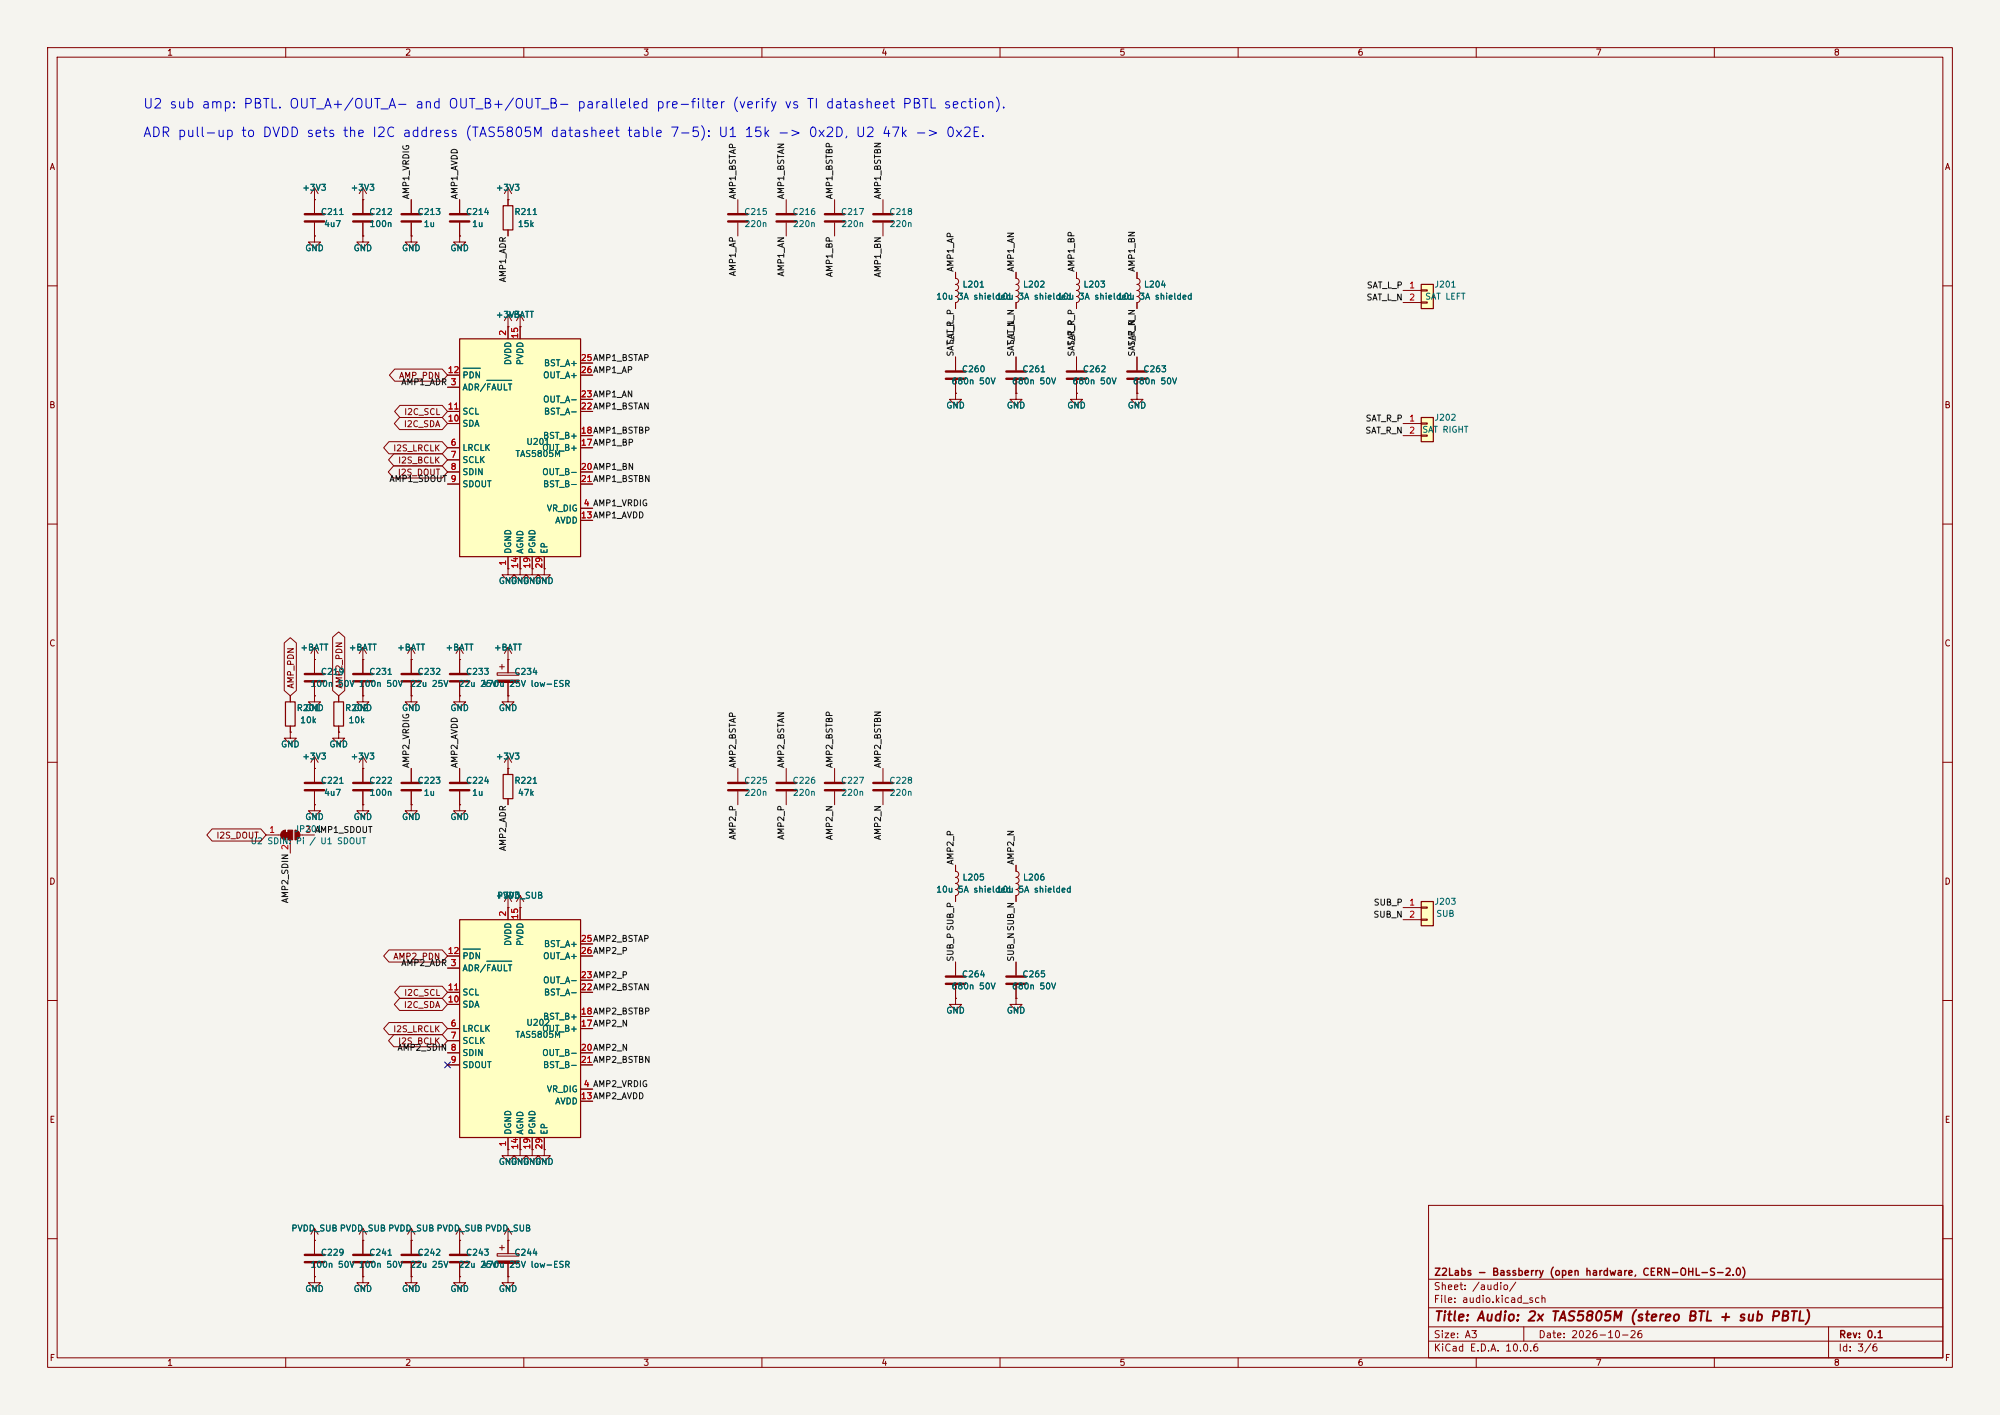
[picture p21: page 3]

U2 sub amp: PBTL. OUT_A+/OUT_A- and OUT_B+/OUT_B- paralleled pre-filter (verify vs TI datasheet PBTL section).

2 JP201 3 U2 SDIN: Pi / U1 SDOUT +3V3 GNDGND

Z2Labs - Bassberry (open hardware, CERN-OHL-S-2.0)
Sheet: /audio/
File: audio.kicad_sch
Title: Audio: 2x TAS5805M (stereo BTL + sub PBTL)

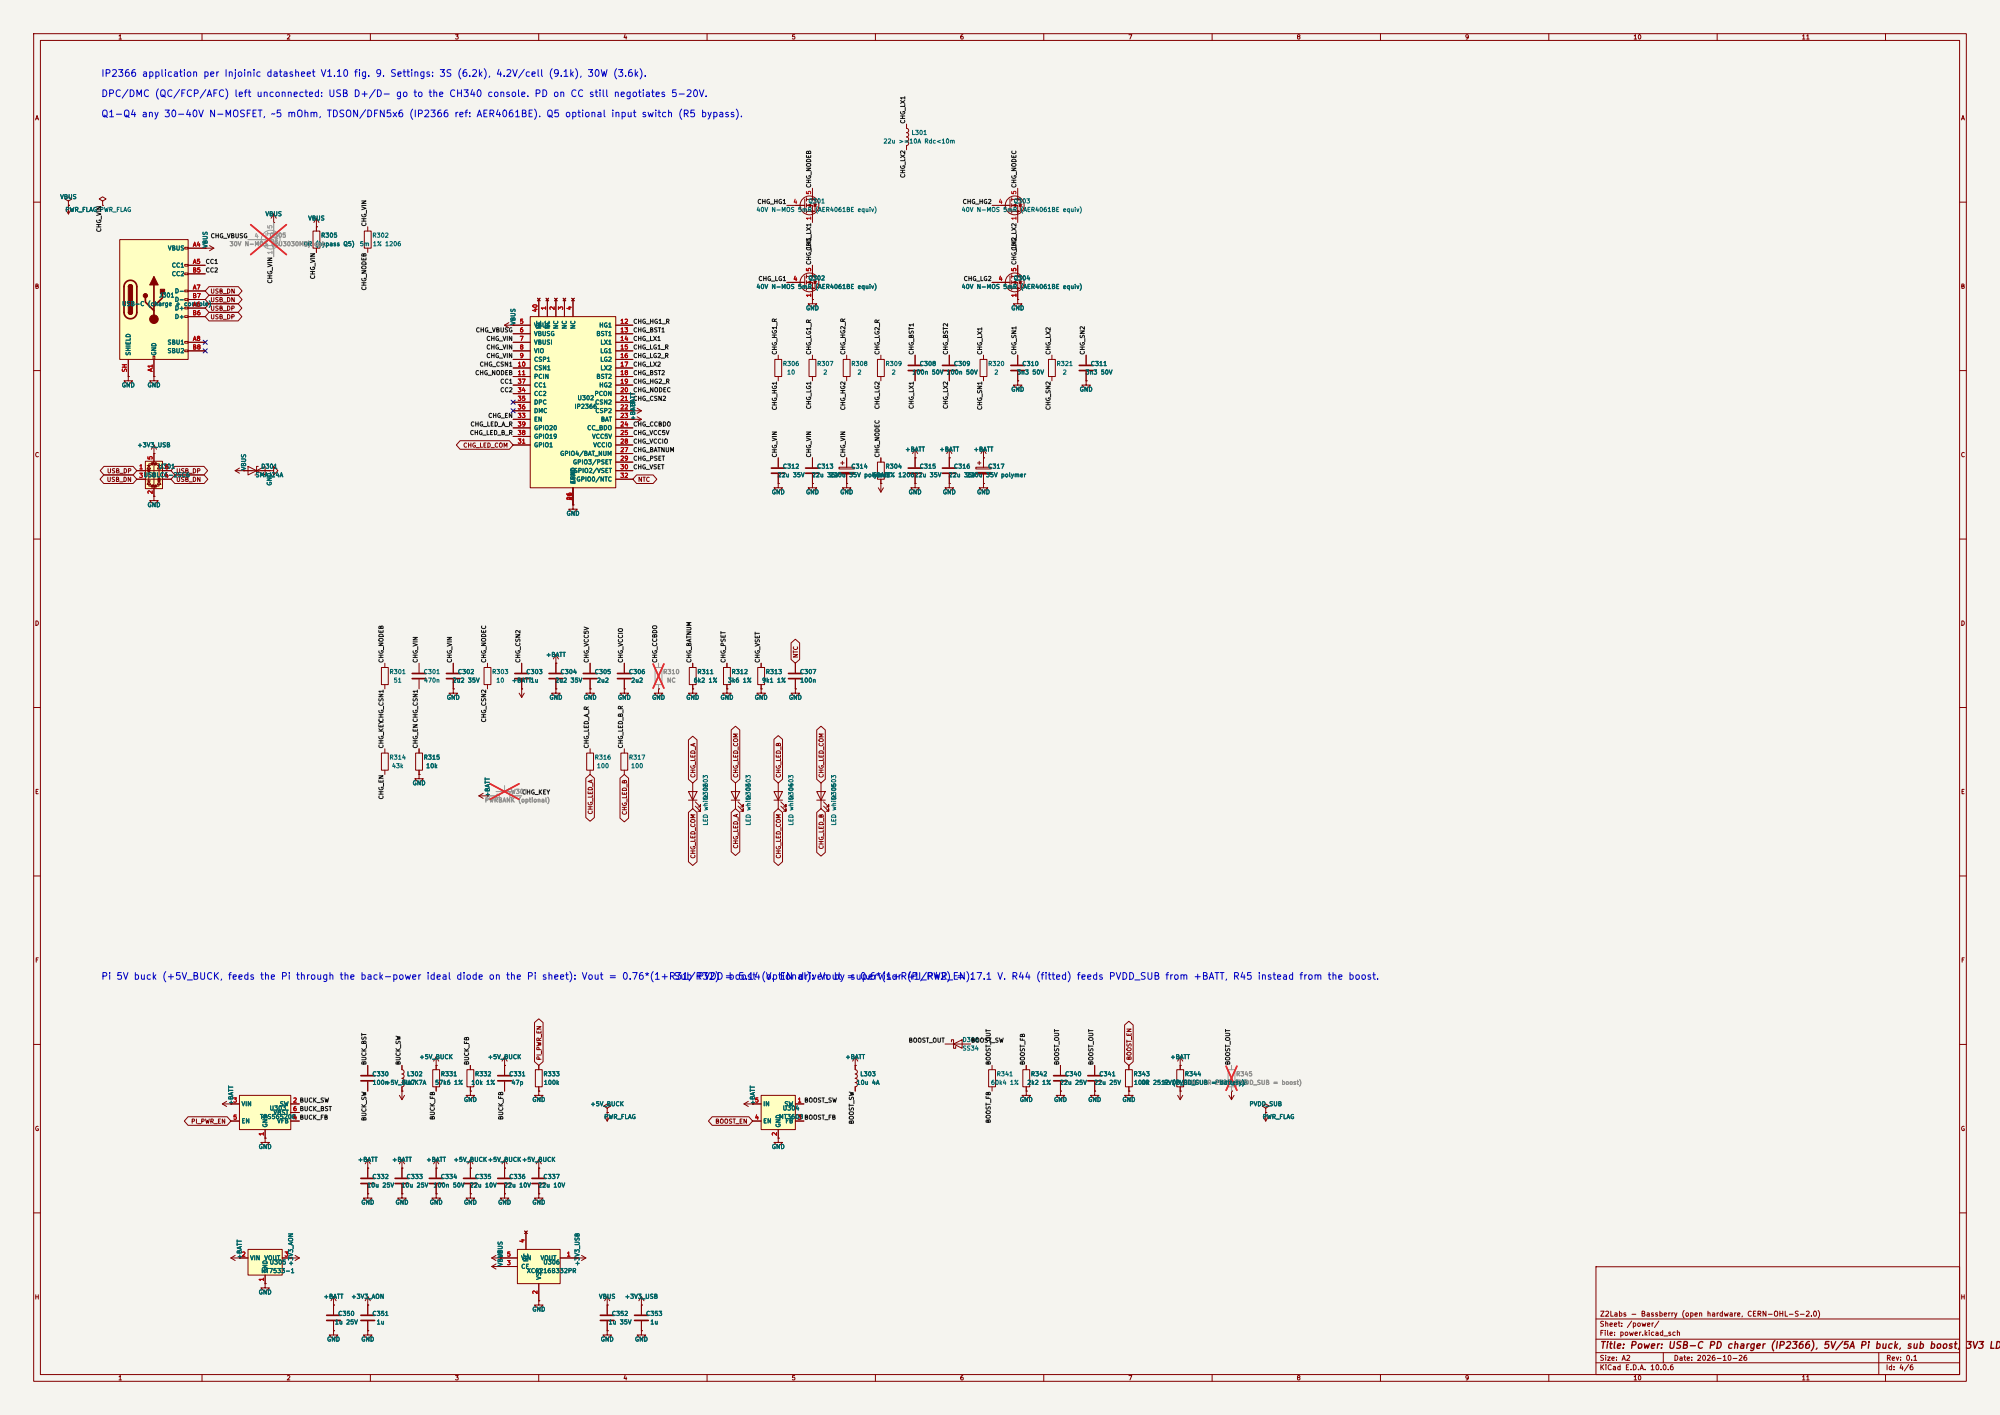
[picture p22: page 4]

IP2366 application per Injoinic datasheet V1.10 fig. 9. Settings: 3S (6.2k), 4.2V/cell (9.1k), 30W (3.6k). PWR_FLAG

DPC/DMC (QC/FCP/AFC) left unconnected: USB D+/D- go to the CH340 console. PD on CC still negotiates 5-20V.

Q1-Q4 any 30-40V N-MOSFET, ~5 mOhm, TDSON/DFN5x6 (IP2366 ref: AER4061BE). Q5 optional input switch (R5 bypass).

J301 USB-C (charge + console) GND A1

5 U301 6 USBLC6-2SC6 GND D303 LED white 0603 D304 LED white 0603 D305 LED white 0603 PVDD_SUB PVDD_SUB

Pi 5V buck (+5V_BUCK, feeds the Pi through the back-power ideal diode on the Pi sheet): Vout = 0.76*(1+R31/R32) Sub PVDD = boost 5.14 (optional): V. EN driven Vout by = supervisor 0.6*(1+R41/R42) (PI_PWR_EN). = 17.1 V. R44 (fitted) feeds PVDD_SUB from +BATT, R45 instead from the boost.

Z2Labs - Bassberry (open hardware, CERN-OHL-S-2.0)
Sheet: /power/
File: power.kicad_sch
Title: Power: USB-C PD charger (IP2366), 5V/5A Pi buck, sub boost, 3V3 LDOs

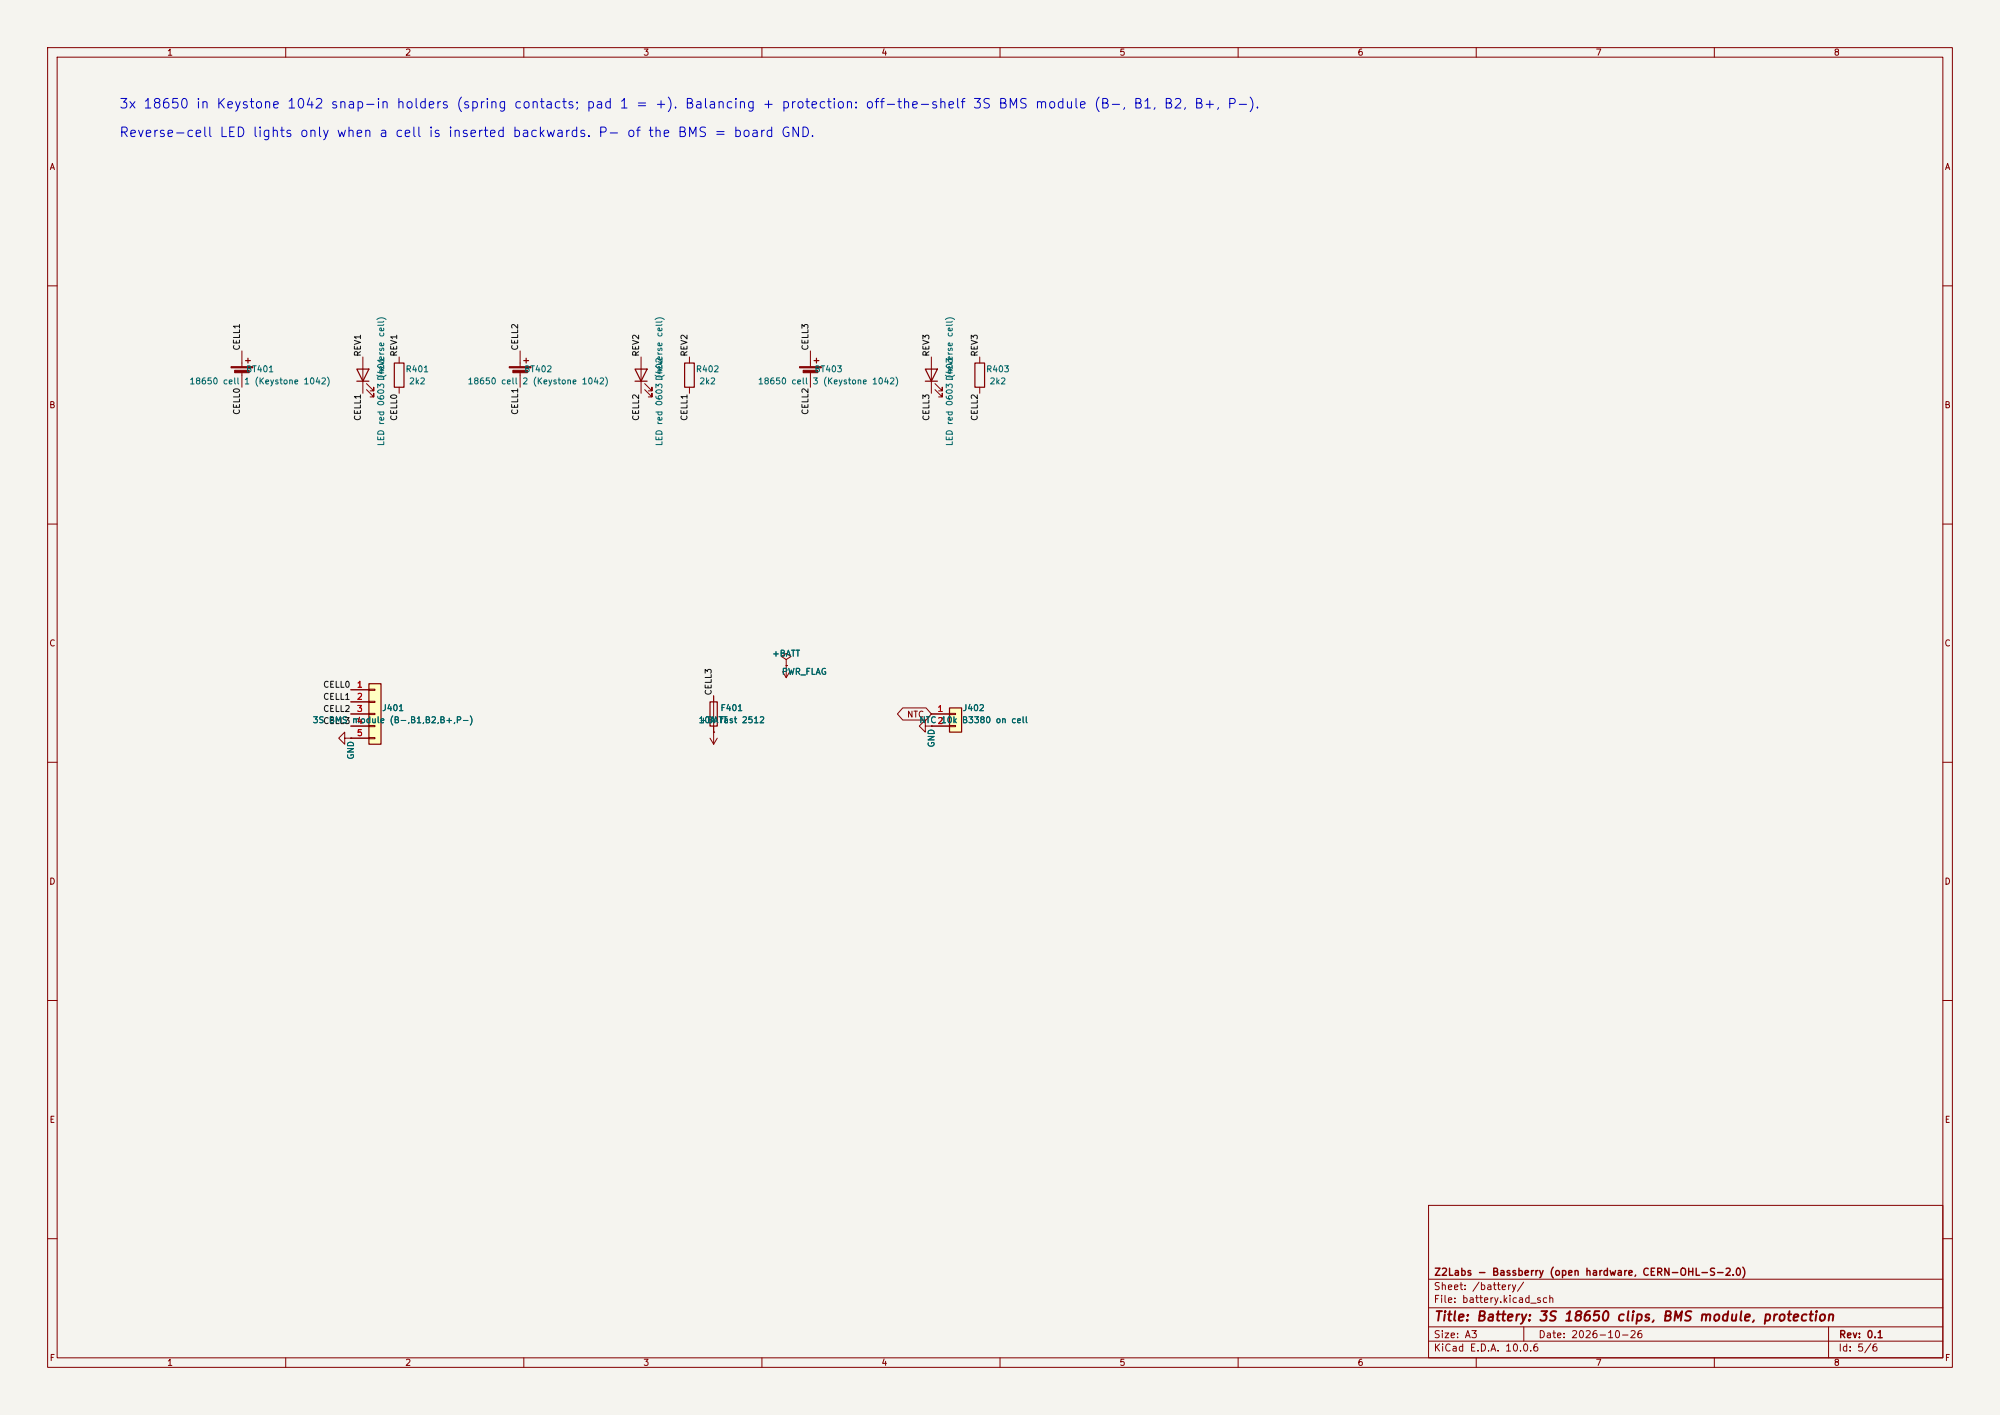
[picture p23: page 5]

2k2 D401 LED red 0603 (reverse cell) BT401

Z2Labs - Bassberry (open hardware, CERN-OHL-S-2.0)
Sheet: /battery/
File: battery.kicad_sch
Title: Battery: 3S 18650 clips, BMS module, protection

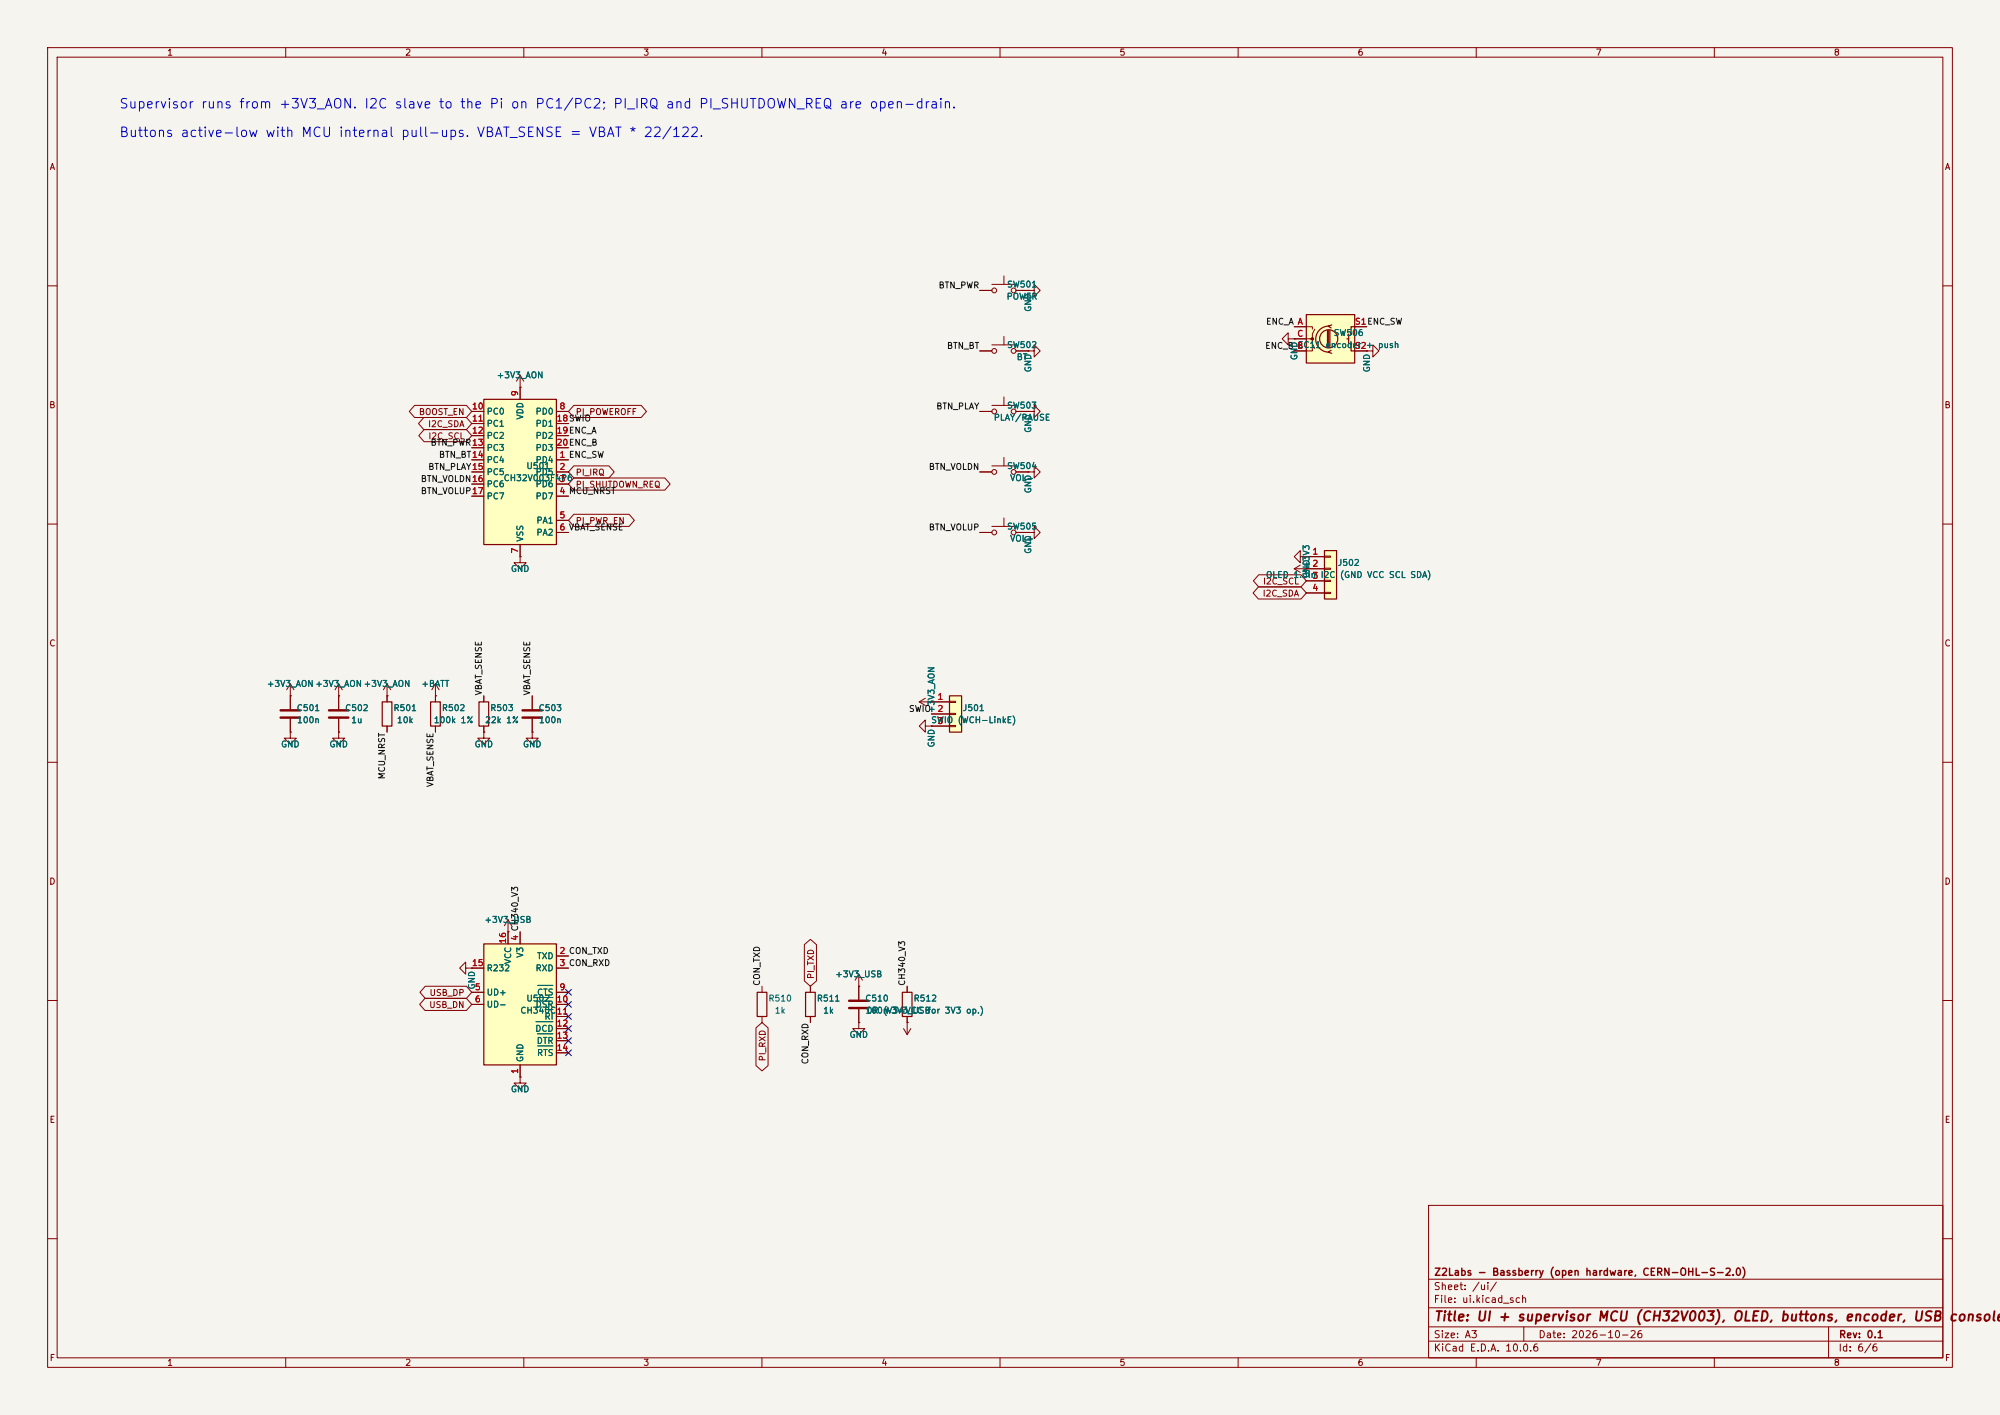
[picture p24: page 6]

VBAT_SENSE Supervisor runs from +3V3_AON. I2C slave to the Pi on PC1/PC2; PI_IRQ and PI_SHUTDOWN_REQ are open-drain.

SW502 BT SW503 PLAY/PAUSE GND GND

4 UD+ 5 UD- 6 CTS 9 DSR 10 RI 11 DCD 12 DTR 13 RTS 14 R232 15 VCC 16 GND

4 UD+ 5 UD- 6 CTS 9 DSR 10 RI 11 DCD 12 DTR 13 RTS 14 R232 15 VCC 16 U502 CH340C

Z2Labs - Bassberry (open hardware, CERN-OHL-S-2.0)
Sheet: /ui/
File: ui.kicad_sch
Title: UI + supervisor MCU (CH32V003), OLED, buttons, encoder, USB console
