z2labs/Bassberry/hardware/bassberry/bassberry.kicad_pcb

## KiCad design hardware/bassberry/bassberry.kicad_pcb (2026-10-27)

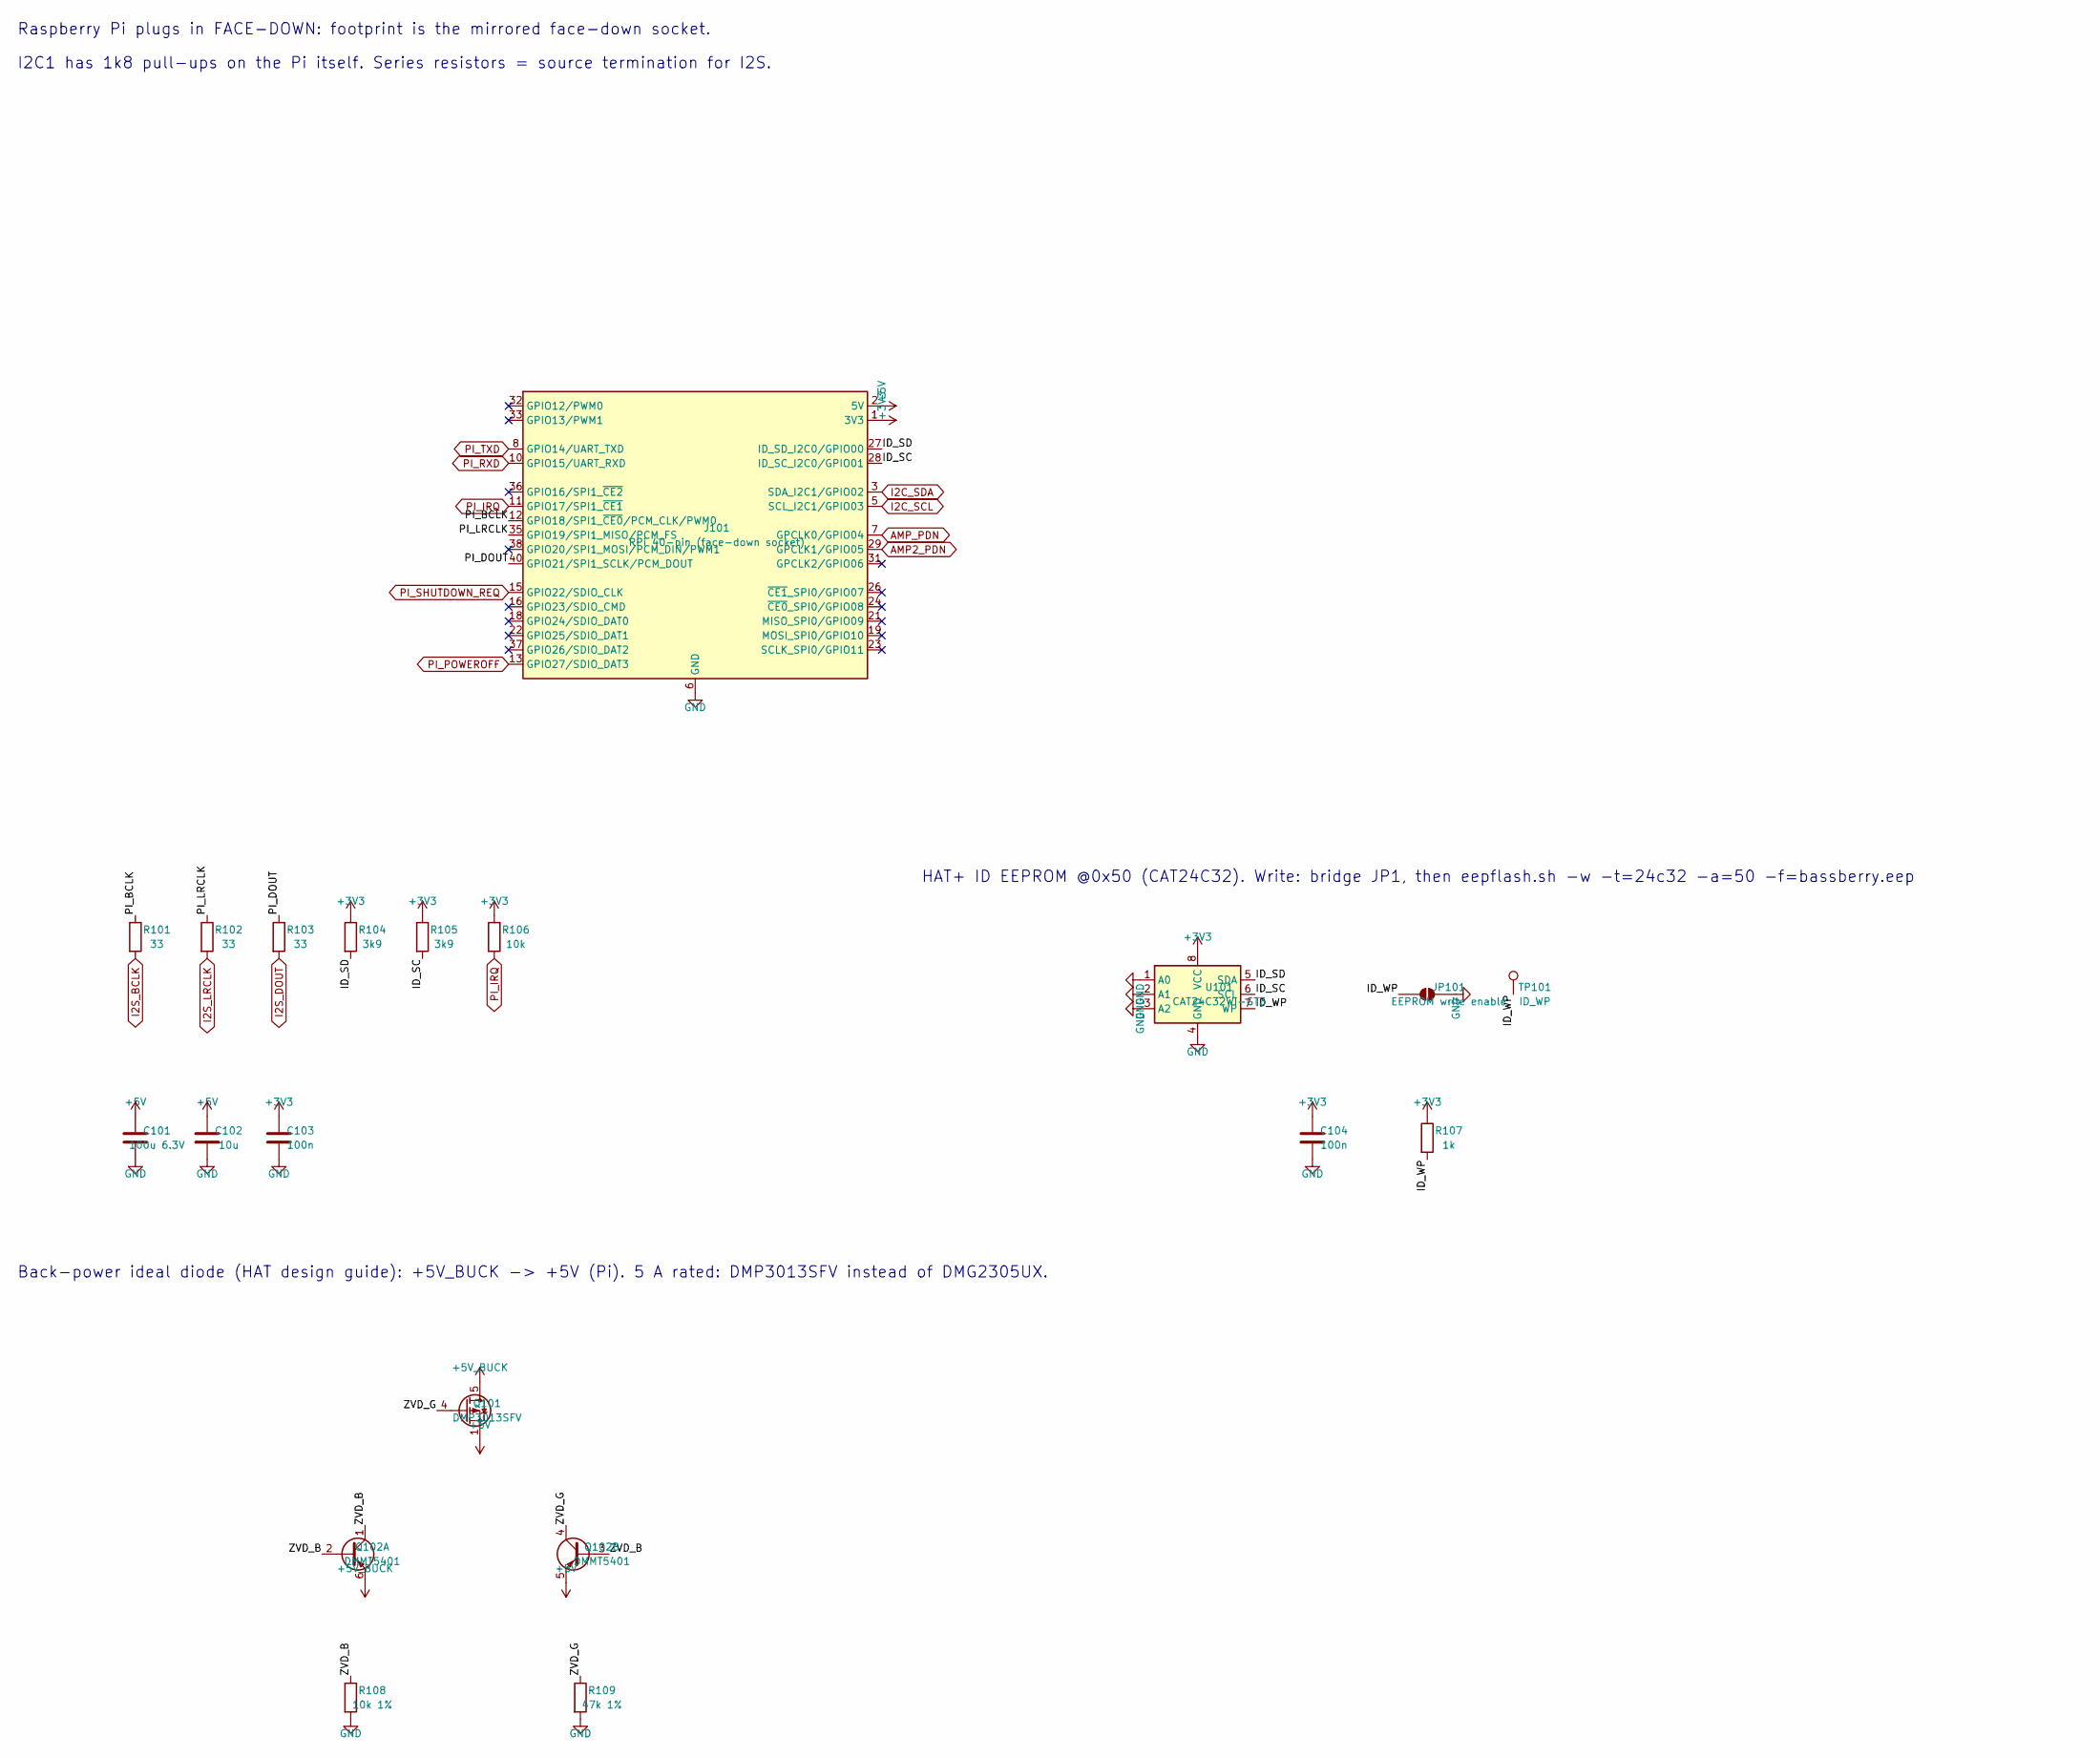
[picture p25: schematic pi.kicad_sch, Raspberry Pi (mounted face-down) + HAT ID]

Parts:
C101: 100u 6.3V; C_1210_3225Metric
C102: 10u; C_0805_2012Metric
C103, C104: 100n; C_0603_1608Metric
J101: RPi 40-pin (face-down socket); Raspberry_Pi_Zero_Socketed_THT_FaceDown_MountingHoles
JP101: EEPROM write enable; SolderJumper-2_P1.3mm_Open_RoundedPad1.0x1.5mm
Q101: DMP3013SFV; Diodes_PowerDI3333-8
Q102: DMMT5401; SOT-23-6
R101, R102, R103: 33; R_0603_1608Metric
R104, R105: 3k9; R_0603_1608Metric
R106: 10k; R_0603_1608Metric
R107: 1k; R_0603_1608Metric
R108: 10k 1%; R_0603_1608Metric
R109: 47k 1%; R_0603_1608Metric
TP101: ID_WP; TestPoint_Pad_D1.5mm
U101: CAT24C32WI-GT3; SOIC-8_3.9x4.9mm_P1.27mm

Connections:
+3V3: C103.1, C104.1, J101.1 (3V3), J101.17 (3V3), R104.1, R105.1, R106.1, R107.1, U101.8 (VCC); also elsewhere on the board
+5V: C101.1, C102.1, J101.2 (5V), J101.4 (5V), Q101.1 (S), Q101.2 (S), Q101.3 (S), Q102.5 (E2)
+5V_BUCK: Q101.5 (D), Q102.6 (E1); also elsewhere on the board
/pi/ID_SC: J101.28 (ID_SC_I2C0/GPIO01), R105.2, U101.6 (SCL)
/pi/ID_SD: J101.27 (ID_SD_I2C0/GPIO00), R104.2, U101.5 (SDA)
/pi/ID_WP: JP101.1 (A), R107.2, TP101.1, U101.7 (WP)
/pi/PI_BCLK: J101.12 (GPIO18/SPI1_~CE0/PCM_CLK/PWM0), R101.1
/pi/PI_DOUT: J101.40 (GPIO21/SPI1_SCLK/PCM_DOUT), R103.1
/pi/PI_LRCLK: J101.35 (GPIO19/SPI1_MISO/PCM_FS), R102.1
/pi/ZVD_B: Q102.1 (C1), Q102.2 (B1), Q102.3 (B2), R108.1
/pi/ZVD_G: Q101.4 (G), Q102.4 (C2), R109.1
AMP2_PDN: J101.29 (GPCLK1/GPIO05); also elsewhere on the board
AMP_PDN: J101.7 (GPCLK0/GPIO04); also elsewhere on the board
GND: C101.2, C102.2, C103.2, C104.2, J101.6 (GND), J101.9 (GND), J101.14 (GND), J101.20 (GND), J101.25 (GND), J101.30 (GND), J101.34 (GND), J101.39 (GND), JP101.2 (B), R108.2, R109.2, U101.1 (A0), U101.2 (A1), U101.3 (A2), U101.4 (GND); also elsewhere on the board
I2C_SCL: J101.5 (SCL_I2C1/GPIO03); also elsewhere on the board
I2C_SDA: J101.3 (SDA_I2C1/GPIO02); also elsewhere on the board
I2S_BCLK: R101.2; also elsewhere on the board
I2S_DOUT: R103.2; also elsewhere on the board
I2S_LRCLK: R102.2; also elsewhere on the board
PI_IRQ: J101.11 (GPIO17/SPI1_~CE1), R106.2; also elsewhere on the board
PI_POWEROFF: J101.13 (GPIO27/SDIO_DAT3); also elsewhere on the board
PI_RXD: J101.10 (GPIO15/UART_RXD); also elsewhere on the board
PI_SHUTDOWN_REQ: J101.15 (GPIO22/SDIO_CLK); also elsewhere on the board
PI_TXD: J101.8 (GPIO14/UART_TXD); also elsewhere on the board

Notes on the sheet:
Raspberry Pi plugs in FACE-DOWN: footprint is the mirrored face-down socket.
I2C1 has 1k8 pull-ups on the Pi itself. Series resistors = source termination for I2S.
HAT+ ID EEPROM @0x50 (CAT24C32). Write: bridge JP1, then eepflash.sh -w -t=24c32 -a=50 -f=bassberry.eep
Back-power ideal diode (HAT design guide): +5V_BUCK -> +5V (Pi). 5 A rated: DMP3013SFV instead of DMG2305UX.

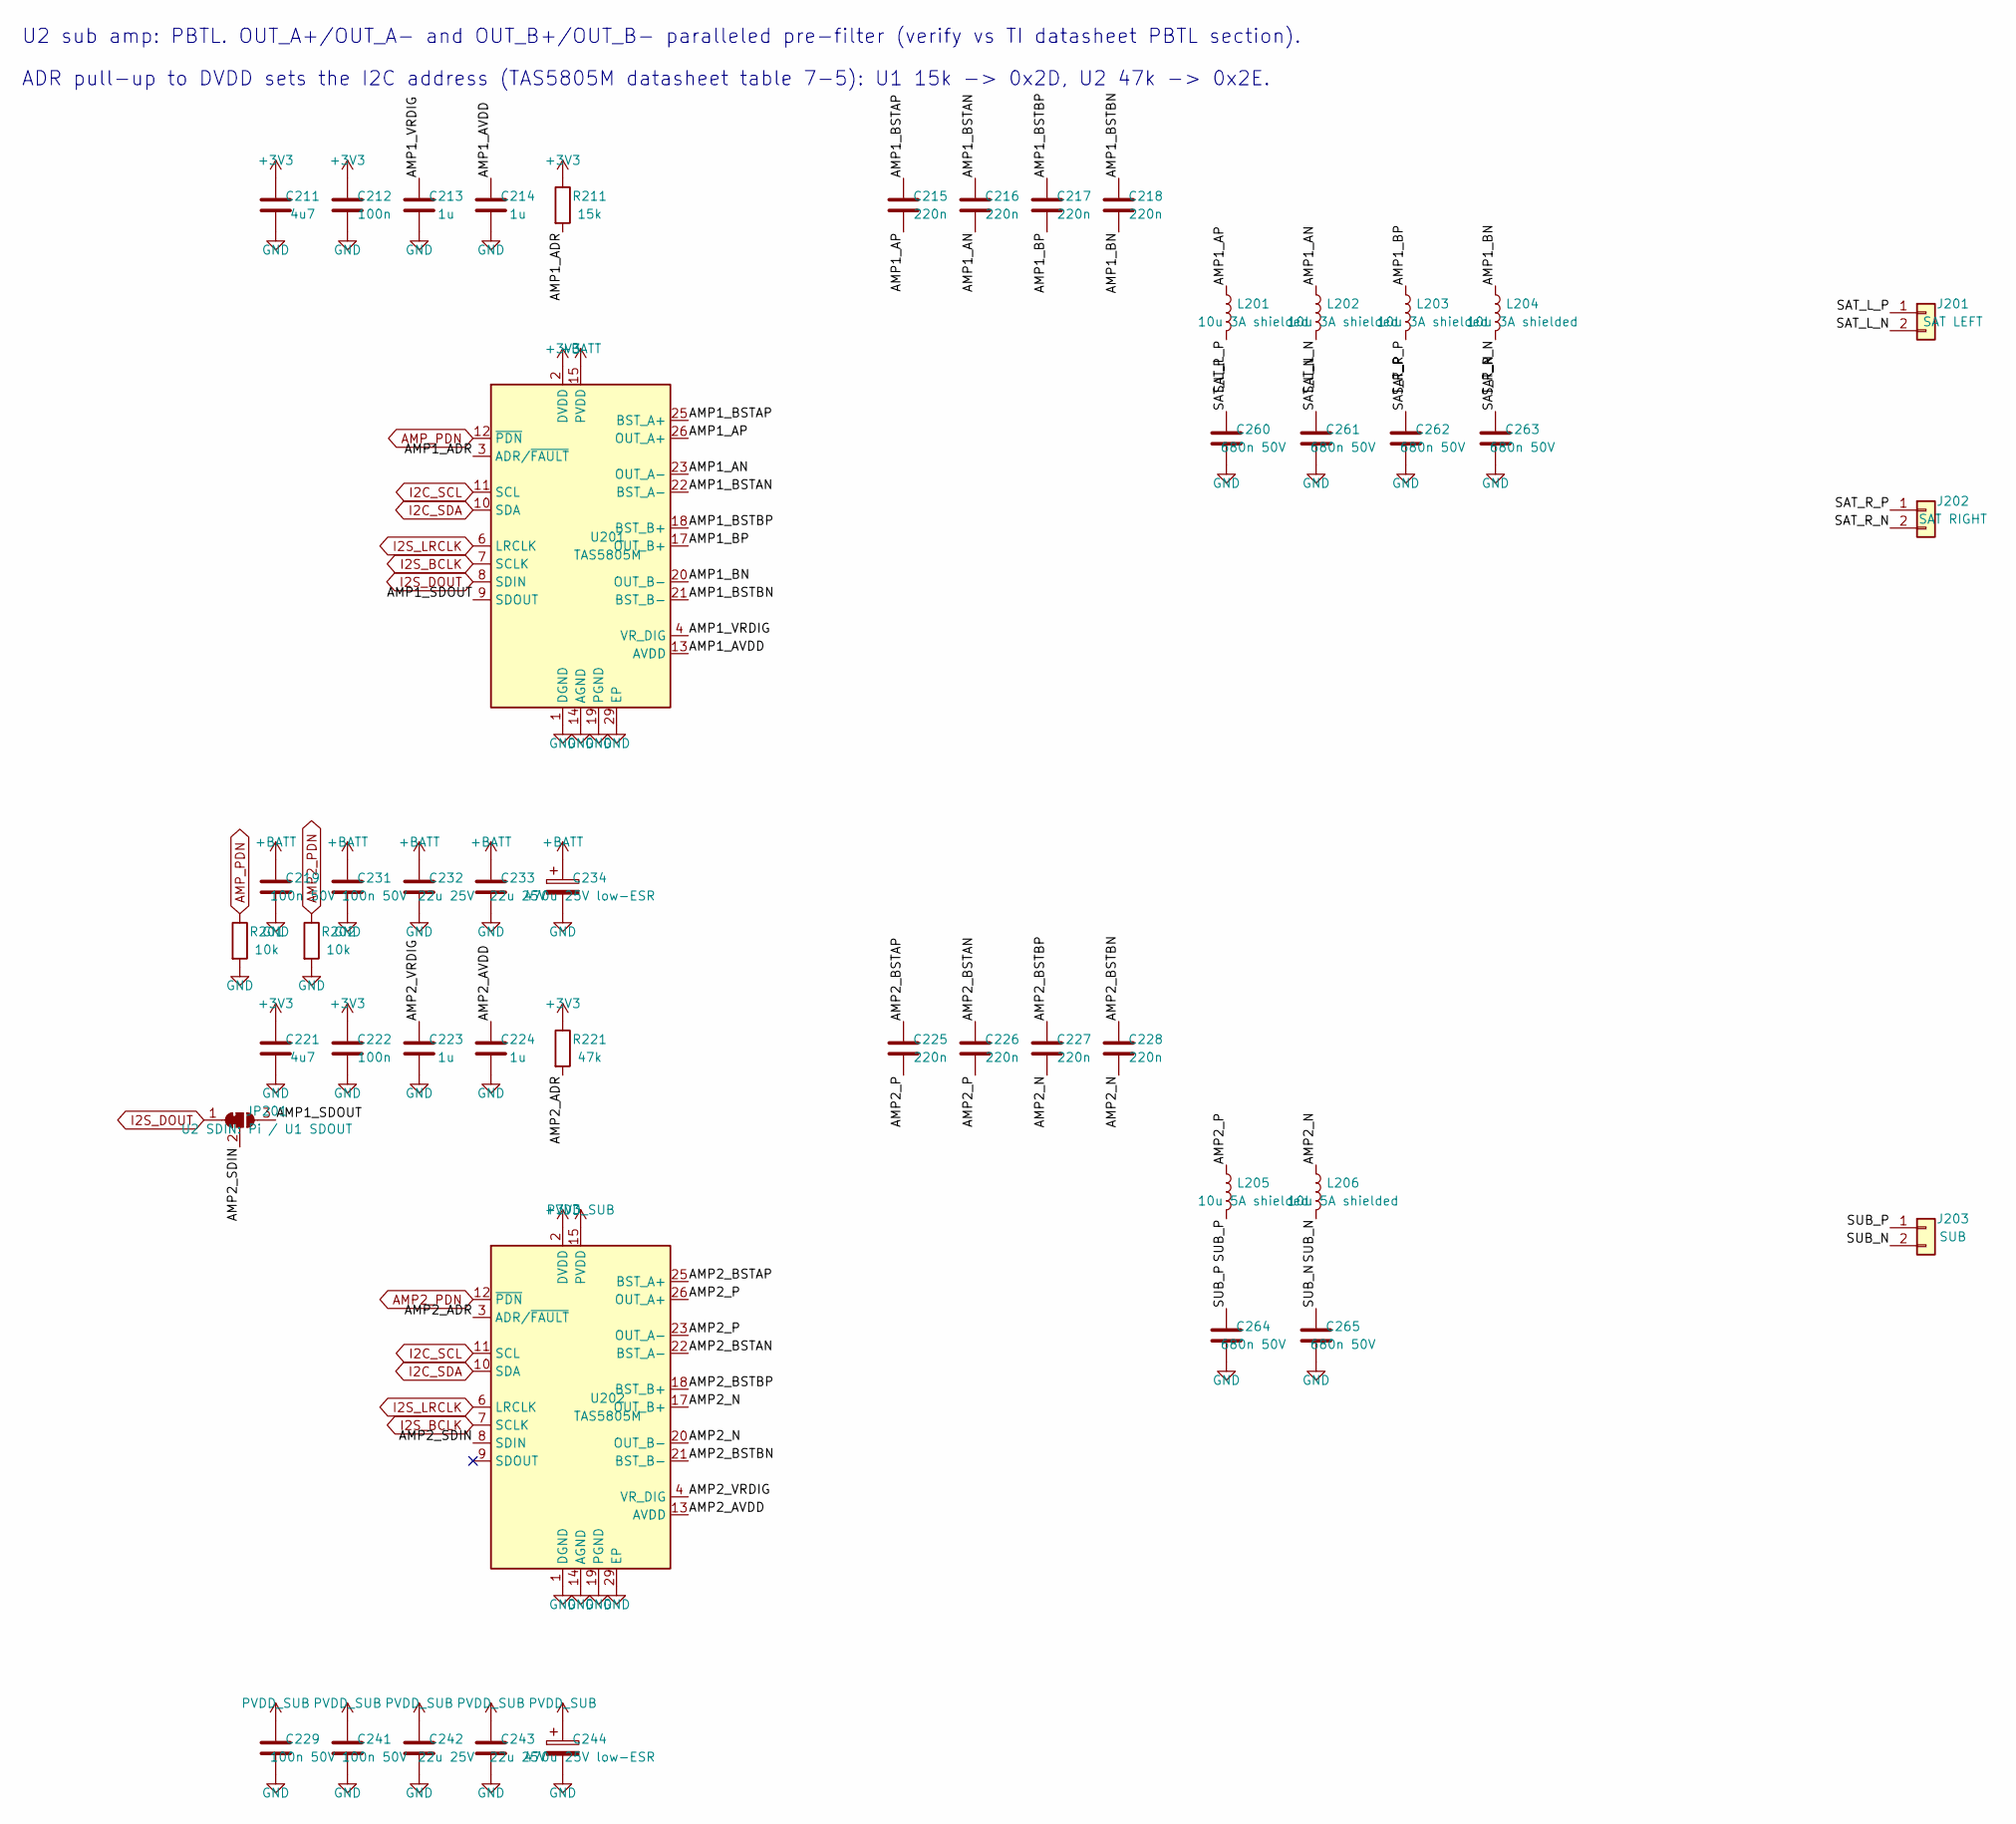
[picture p26: schematic audio.kicad_sch, Audio: 2x TAS5805M (stereo BTL + sub PBTL)]

Parts:
C211, C221: 4u7; C_0603_1608Metric
C212, C222: 100n; C_0603_1608Metric
C213, C214, C223, C224: 1u; C_0603_1608Metric
C215, C216, C217, C218, C225, C226, C227, C228: 220n; C_0603_1608Metric
C219, C229, C231, C241: 100n 50V; C_0603_1608Metric
C232, C233, C242, C243: 22u 25V; C_1206_3216Metric
C234, C244: 470u 25V low-ESR; CP_Elec_10x10.5
C260, C261, C262, C263, C264, C265: 680n 50V; C_0805_2012Metric
J201: SAT LEFT; JST_XH_B2B-XH-A_1x02_P2.50mm_Vertical
J202: SAT RIGHT; JST_XH_B2B-XH-A_1x02_P2.50mm_Vertical
J203: SUB; JST_XH_B2B-XH-A_1x02_P2.50mm_Vertical
JP201: U2 SDIN: Pi / U1 SDOUT; SolderJumper-3_P1.3mm_Bridged12_RoundedPad1.0x1.5mm
L201, L202, L203, L204: 10u 3A shielded; L_Changjiang_FXL1040
L205, L206: 10u 5A shielded; L_Changjiang_FXL1050
R201, R202: 10k; R_0603_1608Metric
R211: 15k; R_0603_1608Metric
R221: 47k; R_0603_1608Metric
U201, U202: TAS5805M; HTSSOP-28-1EP_4.4x9.7mm_P0.65mm_EP2.85x5.4mm_ThermalVias

Connections:
+3V3: C211.1, C212.1, C221.1, C222.1, R211.1, R221.1, U201.2 (DVDD), U202.2 (DVDD); also elsewhere on the board
+BATT: C219.1, C231.1, C232.1, C233.1, C234.1, U201.15 (PVDD), U201.16 (PVDD), U201.27 (PVDD), U201.28 (PVDD); also elsewhere on the board
/audio/AMP1_ADR: R211.2, U201.3 (ADR/~FAULT)
/audio/AMP1_AN: C216.2, L202.1, U201.23 (OUT_A-)
/audio/AMP1_AP: C215.2, L201.1, U201.26 (OUT_A+)
/audio/AMP1_AVDD: C214.1, U201.13 (AVDD)
/audio/AMP1_BN: C218.2, L204.1, U201.20 (OUT_B-)
/audio/AMP1_BP: C217.2, L203.1, U201.17 (OUT_B+)
/audio/AMP1_BSTAN: C216.1, U201.22 (BST_A-)
/audio/AMP1_BSTAP: C215.1, U201.25 (BST_A+)
/audio/AMP1_BSTBN: C218.1, U201.21 (BST_B-)
/audio/AMP1_BSTBP: C217.1, U201.18 (BST_B+)
/audio/AMP1_SDOUT: JP201.3 (B), U201.9 (SDOUT)
/audio/AMP1_VRDIG: C213.1, U201.4 (VR_DIG)
/audio/AMP2_ADR: R221.2, U202.3 (ADR/~FAULT)
/audio/AMP2_AVDD: C224.1, U202.13 (AVDD)
/audio/AMP2_BSTAN: C226.1, U202.22 (BST_A-)
/audio/AMP2_BSTAP: C225.1, U202.25 (BST_A+)
/audio/AMP2_BSTBN: C228.1, U202.21 (BST_B-)
/audio/AMP2_BSTBP: C227.1, U202.18 (BST_B+)
/audio/AMP2_N: C227.2, C228.2, L206.1, U202.17 (OUT_B+), U202.20 (OUT_B-)
/audio/AMP2_P: C225.2, C226.2, L205.1, U202.23 (OUT_A-), U202.26 (OUT_A+)
/audio/AMP2_SDIN: JP201.2 (C), U202.8 (SDIN)
/audio/AMP2_VRDIG: C223.1, U202.4 (VR_DIG)
/audio/SAT_L_N: C261.1, J201.2, L202.2
/audio/SAT_L_P: C260.1, J201.1, L201.2
/audio/SAT_R_N: C263.1, J202.2, L204.2
/audio/SAT_R_P: C262.1, J202.1, L203.2
/audio/SUB_N: C265.1, J203.2, L206.2
/audio/SUB_P: C264.1, J203.1, L205.2
AMP2_PDN: R202.1, U202.12 (~PDN); also elsewhere on the board
AMP_PDN: R201.1, U201.12 (~PDN); also elsewhere on the board
GND: C211.2, C212.2, C213.2, C214.2, C219.2, C221.2, C222.2, C223.2, C224.2, C229.2, C231.2, C232.2, C233.2, C234.2, C241.2, C242.2, C243.2, C244.2, C260.2, C261.2, C262.2, C263.2, C264.2, C265.2, R201.2, R202.2, U201.1 (DGND), U201.5 (DGND), U201.14 (AGND), U201.19 (PGND), U201.24 (PGND), U201.29 (EP), U202.1 (DGND), U202.5 (DGND), U202.14 (AGND), U202.19 (PGND), U202.24 (PGND), U202.29 (EP); also elsewhere on the board
I2C_SCL: U201.11 (SCL), U202.11 (SCL); also elsewhere on the board
I2C_SDA: U201.10 (SDA), U202.10 (SDA); also elsewhere on the board
I2S_BCLK: U201.7 (SCLK), U202.7 (SCLK); also elsewhere on the board
I2S_DOUT: JP201.1 (A), U201.8 (SDIN); also elsewhere on the board
I2S_LRCLK: U201.6 (LRCLK), U202.6 (LRCLK); also elsewhere on the board
PVDD_SUB: C229.1, C241.1, C242.1, C243.1, C244.1, U202.15 (PVDD), U202.16 (PVDD), U202.27 (PVDD), U202.28 (PVDD); also elsewhere on the board

Notes on the sheet:
U2 sub amp: PBTL. OUT_A+/OUT_A- and OUT_B+/OUT_B- paralleled pre-filter (verify vs TI datasheet PBTL section).
ADR pull-up to DVDD sets the I2C address (TAS5805M datasheet table 7-5): U1 15k -> 0x2D, U2 47k -> 0x2E.

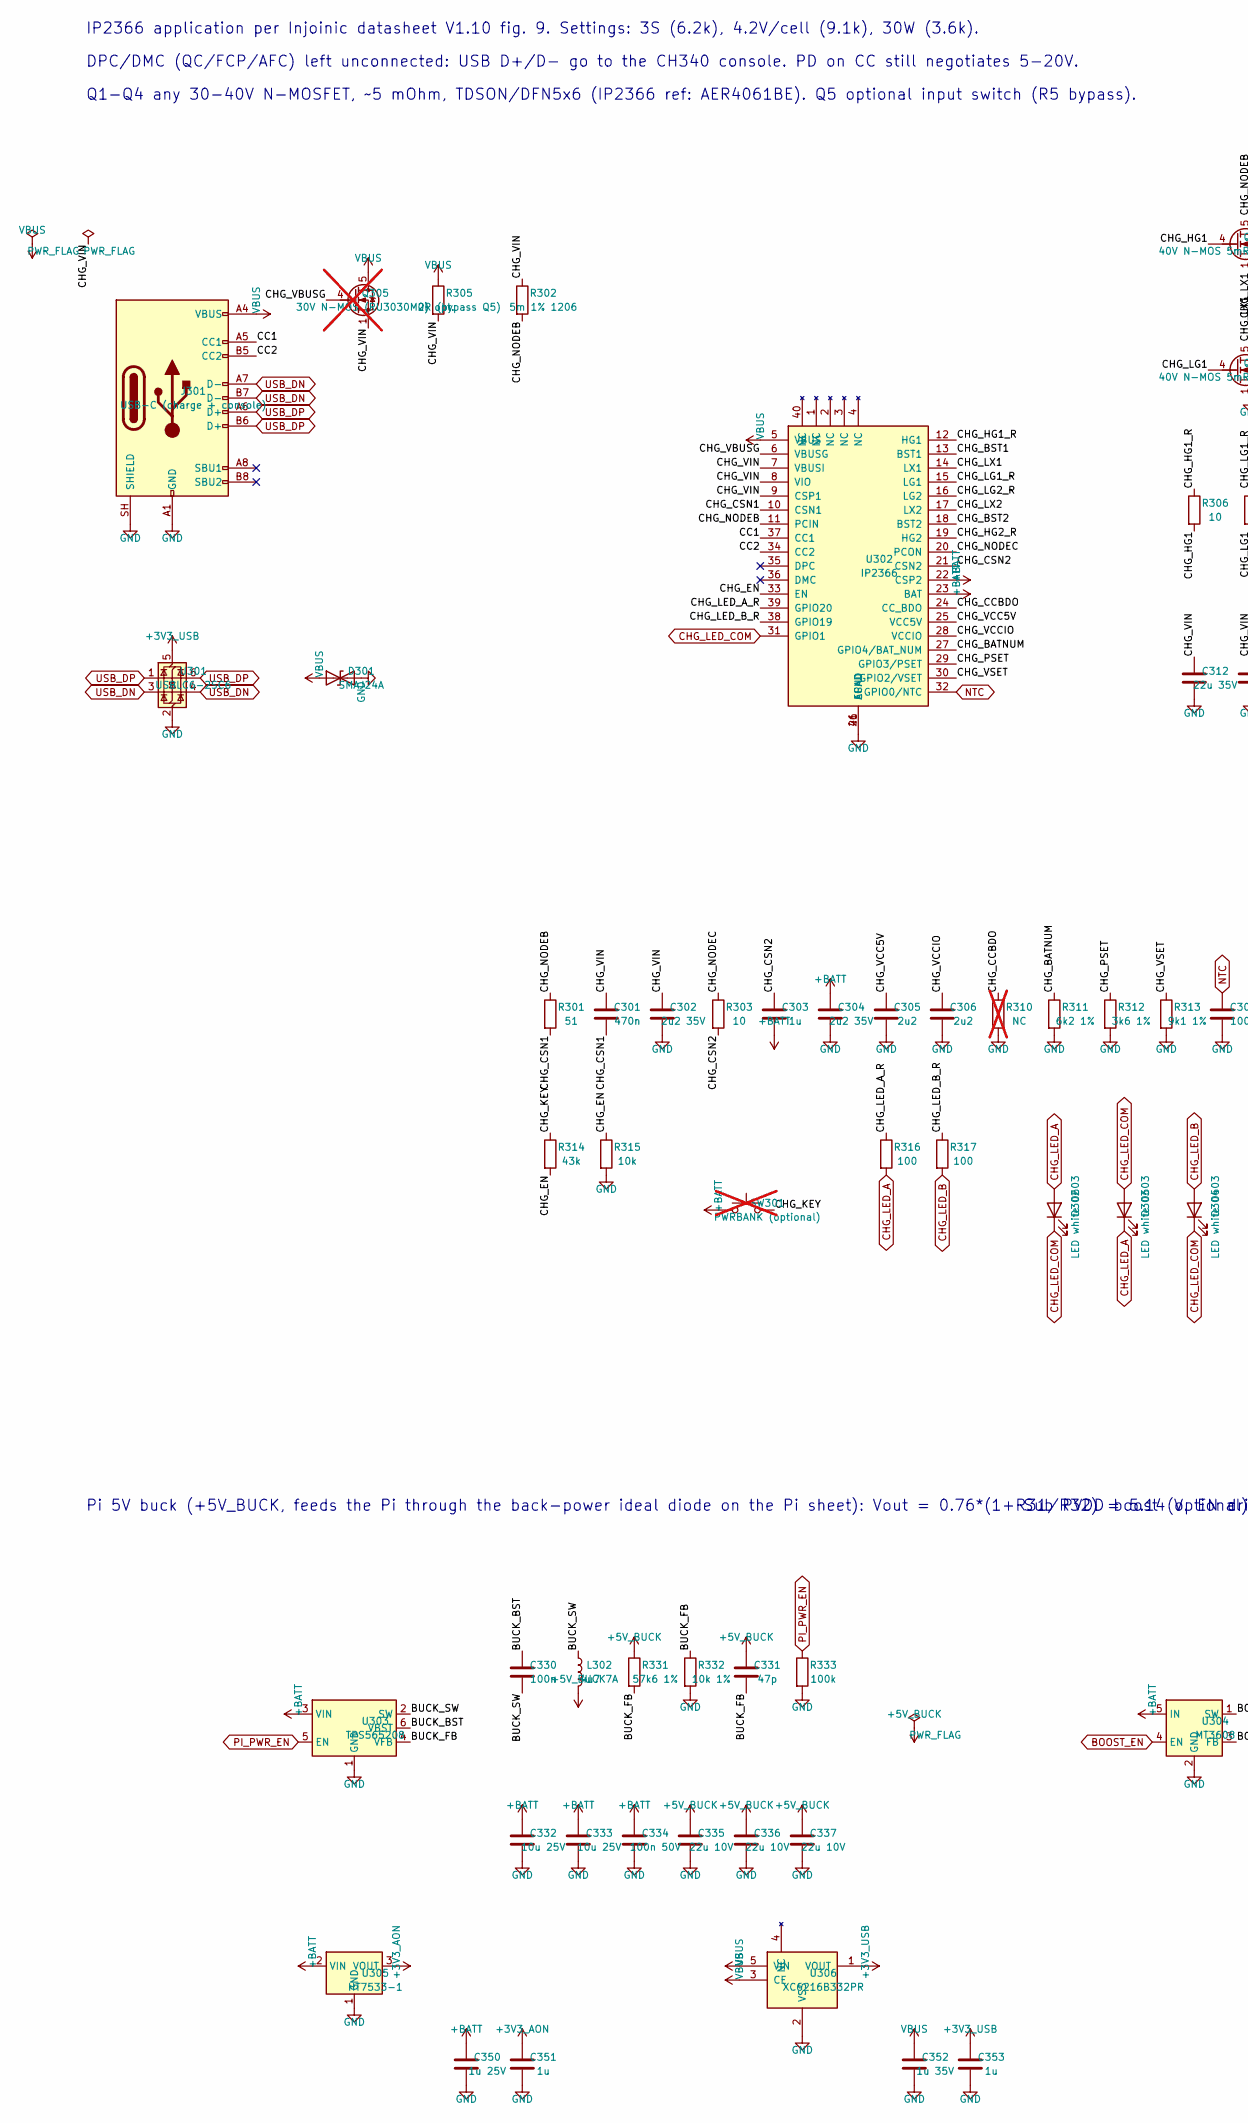
[picture p27: schematic power.kicad_sch, Power: USB-C PD charger (IP2366), 5V/5A Pi buck, sub boost,…, part in row 1, column 1]

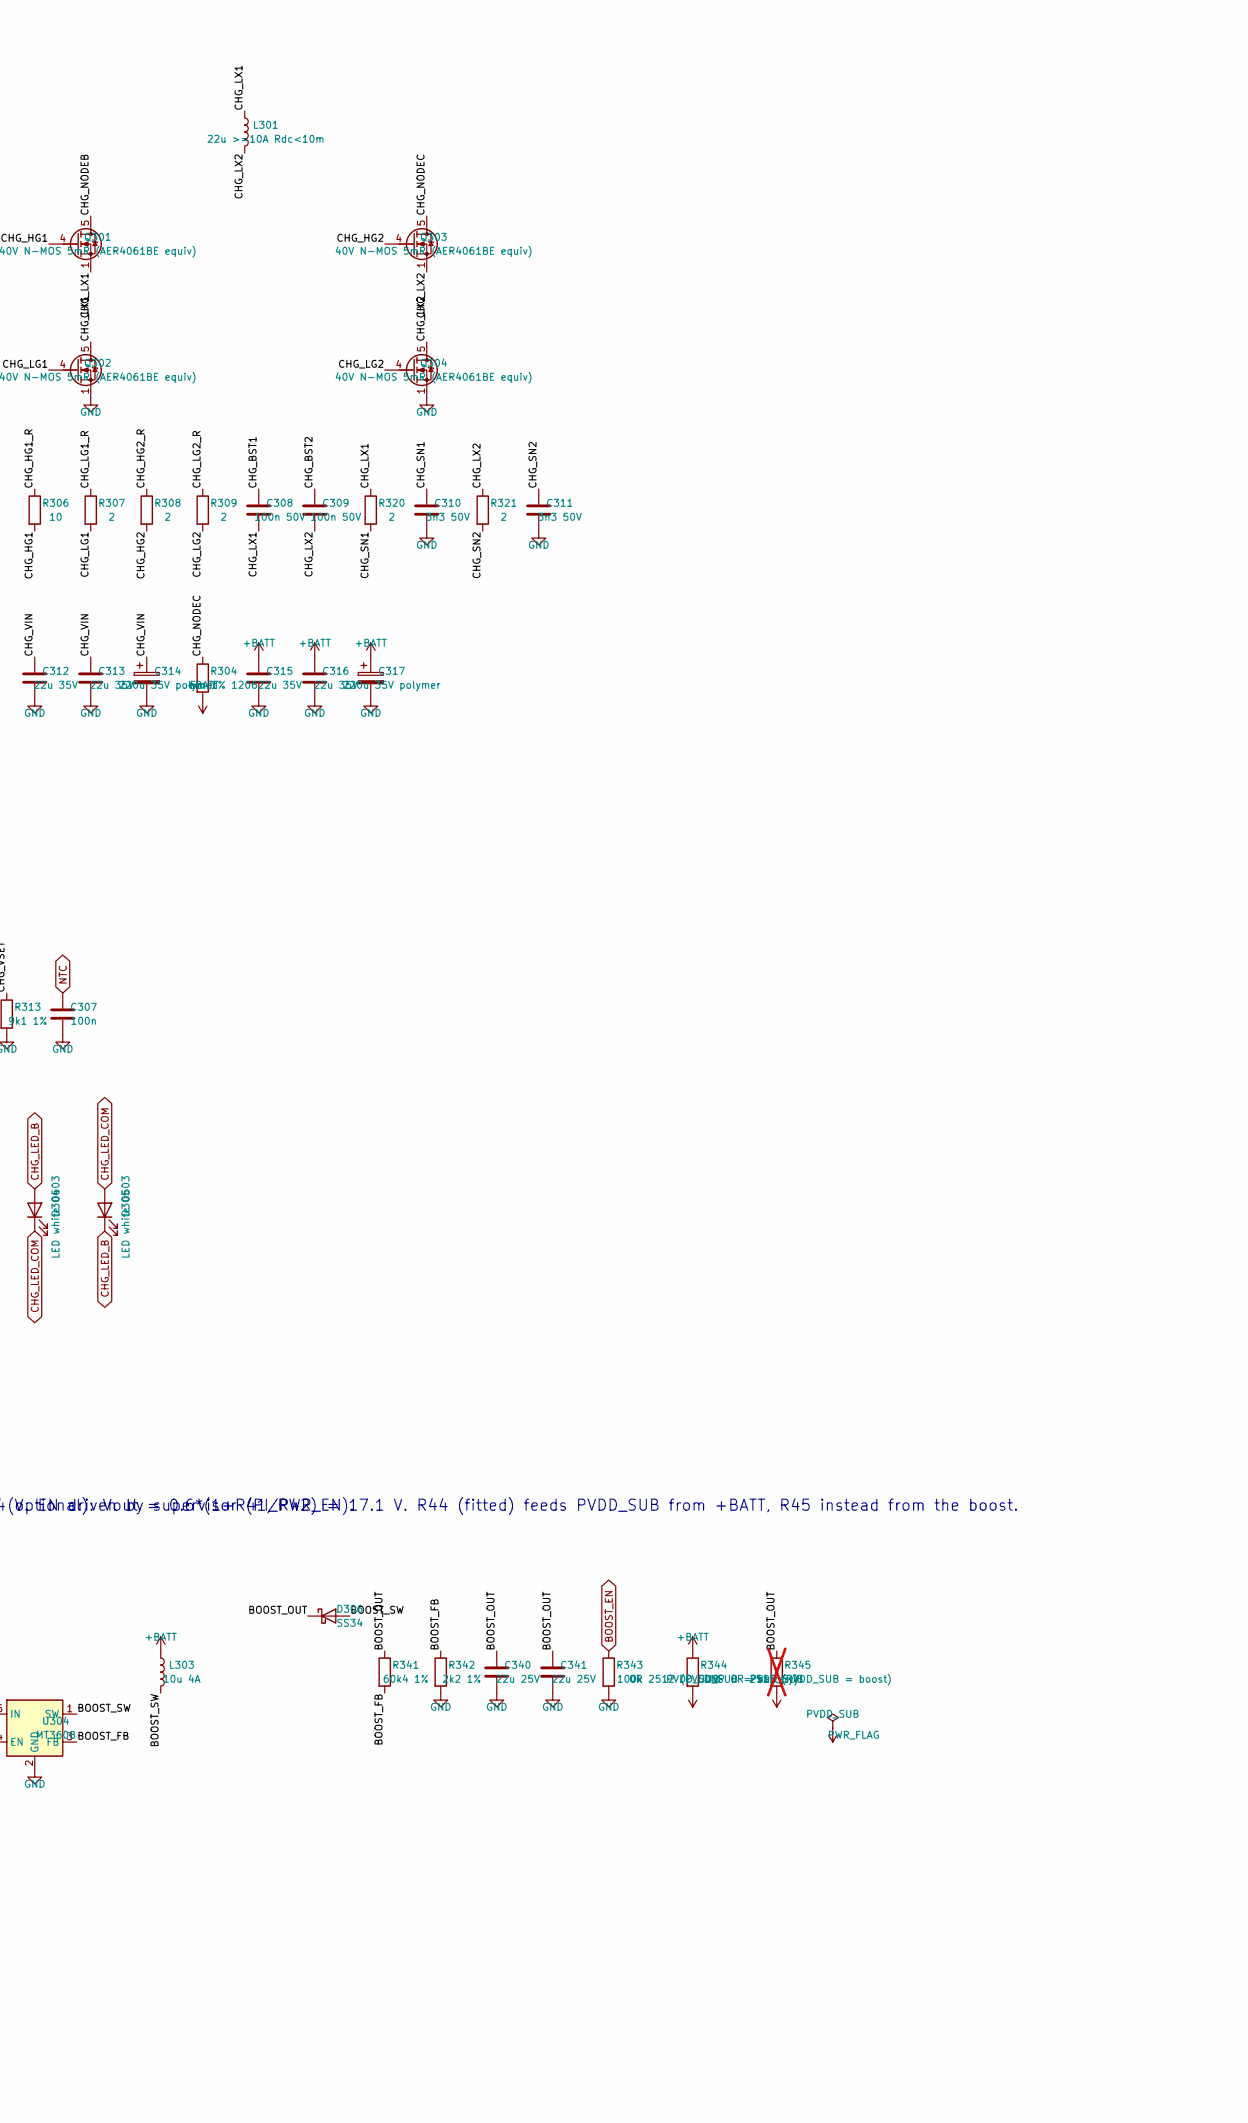
[picture p28: schematic power.kicad_sch, Power: USB-C PD charger (IP2366), 5V/5A Pi buck, sub boost,…, part in row 1, column 2]

Parts:
C301: 470n; C_0603_1608Metric
C302, C304: 2u2 35V; C_0603_1608Metric
C303, C351, C353: 1u; C_0603_1608Metric
C305, C306: 2u2; C_0603_1608Metric
C307, C330: 100n; C_0603_1608Metric
C308, C309, C334: 100n 50V; C_0603_1608Metric
C310, C311: 3n3 50V; C_0603_1608Metric
C312, C313, C315, C316: 22u 35V; C_1210_3225Metric
C314, C317: 220u 35V polymer; CP_Elec_10x10.5
C331: 47p; C_0603_1608Metric
C332, C333: 10u 25V; C_1206_3216Metric
C335, C336, C337: 22u 10V; C_1206_3216Metric
C340, C341: 22u 25V; C_1210_3225Metric
C350: 1u 25V; C_0603_1608Metric
C352: 1u 35V; C_0603_1608Metric
D301: SMAJ24A; D_SMA
D302, D303, D304, D305: LED white 0603; LED_0603_1608Metric
D306: SS34; D_SMA
J301: USB-C (charge + console); USB_C_Receptacle_HRO_TYPE-C-31-M-12
L301: 22u >=10A Rdc<10m; L_Sunlord_MWSA1265S
L302: 4u7 7A; L_Changjiang_FXL1040
L303: 10u 4A; L_Changjiang_FXL1040
Q301, Q302, Q303, Q304: 40V N-MOS 5mR (AER4061BE equiv); TDSON-8-1
Q305: 30V N-MOS (RU3030M2) opt.; TDSON-8-1; not fitted
R301: 51; R_0603_1608Metric
R302, R304: 5m 1% 1206; R_1206_3216Metric
R303, R306: 10; R_0603_1608Metric
R305: 0R (bypass Q5); R_1206_3216Metric
R307, R308, R309, R320, R321: 2; R_0603_1608Metric
R310: NC; R_0603_1608Metric; not fitted
R311: 6k2 1%; R_0603_1608Metric
R312: 3k6 1%; R_0603_1608Metric
R313: 9k1 1%; R_0603_1608Metric
R314: 43k; R_0603_1608Metric
R315: 10k; R_0603_1608Metric
R316, R317: 100; R_0603_1608Metric
R331: 57k6 1%; R_0603_1608Metric
R332: 10k 1%; R_0603_1608Metric
R333, R343: 100k; R_0603_1608Metric
R341: 60k4 1%; R_0603_1608Metric
R342: 2k2 1%; R_0603_1608Metric
R344: 0R 2512 (PVDD_SUB = battery); R_2512_6332Metric
R345: DNP 0R 2512 (PVDD_SUB = boost); R_2512_6332Metric; not fitted
SW301: PWRBANK (optional); SW_SPST_TL3342; not fitted
U301: USBLC6-2SC6; SOT-23-6
U302: IP2366; QFN-40-1EP_5x5mm_P0.4mm_EP3.6x3.6mm_ThermalVias
U303: TPS565208; SOT-23-6
U304: MT3608; SOT-23-6
U305: HT7533-1; SOT-89-3
U306: XC6216B332PR; SOT-89-5

Connections:
+3V3_AON: C351.1, U305.3 (VOUT); also elsewhere on the board
+3V3_USB: C353.1, U301.5 (VBUS), U306.1 (VOUT); also elsewhere on the board
+5V_BUCK: C331.1, C335.1, C336.1, C337.1, L302.2, R331.1; also elsewhere on the board
+BATT: C303.2, C304.1, C315.1, C316.1, C317.1, C332.1, C333.1, C334.1, C350.1, L303.1, R304.2, R344.1, SW301.1, U302.22 (CSP2), U302.23 (BAT), U303.3 (VIN), U304.5 (IN), U305.2 (VIN); also elsewhere on the board
/power/BOOST_FB: R341.2, R342.1, U304.3 (FB)
/power/BOOST_OUT: C340.1, C341.1, D306.1 (K), R341.1, R345.1
/power/BOOST_SW: D306.2 (A), L303.2, U304.1 (SW)
/power/BUCK_BST: C330.1, U303.6 (VBST)
/power/BUCK_FB: C331.2, R331.2, R332.1, U303.4 (VFB)
/power/BUCK_SW: C330.2, L302.1, U303.2 (SW)
/power/CC1: J301.A5 (CC1), U302.37 (CC1)
/power/CC2: J301.B5 (CC2), U302.34 (CC2)
/power/CHG_BATNUM: R311.1, U302.27 (GPIO4/BAT_NUM)
/power/CHG_BST1: C308.1, U302.13 (BST1)
/power/CHG_BST2: C309.1, U302.18 (BST2)
/power/CHG_CCBDO: R310.1, U302.24 (CC_BDO)
/power/CHG_CSN1: C301.2, R301.2, U302.10 (CSN1)
/power/CHG_CSN2: C303.1, R303.2, U302.21 (CSN2)
/power/CHG_EN: R314.2, R315.1, U302.33 (EN)
/power/CHG_HG1: Q301.4 (G), R306.2
/power/CHG_HG1_R: R306.1, U302.12 (HG1)
/power/CHG_HG2: Q303.4 (G), R308.2
/power/CHG_HG2_R: R308.1, U302.19 (HG2)
/power/CHG_KEY: R314.1, SW301.2
/power/CHG_LED_A_R: R316.1, U302.39 (GPIO20)
/power/CHG_LED_B_R: R317.1, U302.38 (GPIO19)
/power/CHG_LG1: Q302.4 (G), R307.2
/power/CHG_LG1_R: R307.1, U302.15 (LG1)
/power/CHG_LG2: Q304.4 (G), R309.2
/power/CHG_LG2_R: R309.1, U302.16 (LG2)
/power/CHG_LX1: C308.2, L301.1, Q301.1 (S), Q301.2 (S), Q301.3 (S), Q302.5 (D), R320.1, U302.14 (LX1)
/power/CHG_LX2: C309.2, L301.2, Q303.1 (S), Q303.2 (S), Q303.3 (S), Q304.5 (D), R321.1, U302.17 (LX2)
/power/CHG_NODEB: Q301.5 (D), R301.1, R302.2, U302.11 (PCIN)
/power/CHG_NODEC: Q303.5 (D), R303.1, R304.1, U302.20 (PCON)
/power/CHG_PSET: R312.1, U302.29 (GPIO3/PSET)
/power/CHG_SN1: C310.1, R320.2
/power/CHG_SN2: C311.1, R321.2
/power/CHG_VBUSG: Q305.4 (G), U302.6 (VBUSG)
/power/CHG_VCC5V: C305.1, U302.25 (VCC5V)
/power/CHG_VCCIO: C306.1, U302.28 (VCCIO)
/power/CHG_VIN: C301.1, C302.1, C312.1, C313.1, C314.1, Q305.1 (S), Q305.2 (S), Q305.3 (S), R302.1, R305.2, U302.7 (VBUSI), U302.8 (VIO), U302.9 (CSP1)
/power/CHG_VSET: R313.1, U302.30 (GPIO2/VSET)
BOOST_EN: R343.1, U304.4 (EN); also elsewhere on the board
CHG_LED_A: D302.2 (A), D303.1 (K), R316.2
CHG_LED_B: D304.2 (A), D305.1 (K), R317.2
CHG_LED_COM: D302.1 (K), D303.2 (A), D304.1 (K), D305.2 (A), U302.31 (GPIO1)
GND: C302.2, C304.2, C305.2, C306.2, C307.2, C310.2, C311.2, C312.2, C313.2, C314.2, C315.2, C316.2, C317.2, C332.2, C333.2, C334.2, C335.2, C336.2, C337.2, C340.2, C341.2, C350.2, C351.2, C352.2, C353.2, D301.2 (A2), J301.A1 (GND), J301.A12 (GND), J301.B1 (GND), J301.B12 (GND), J301.SH (SHIELD), Q302.1 (S), Q302.2 (S), Q302.3 (S), Q304.1 (S), Q304.2 (S), Q304.3 (S), R310.2, R311.2, R312.2, R313.2, R315.2, R332.2, R333.2, R342.2, R343.2, U301.2 (GND), U302.26 (AGND), U302.41 (EPAD), U303.1 (GND), U304.2 (GND), U305.1 (GND), U306.2 (VSS); also elsewhere on the board
NTC: C307.1, U302.32 (GPIO0/NTC); also elsewhere on the board
PI_PWR_EN: R333.1, U303.5 (EN); also elsewhere on the board
PVDD_SUB: R344.2, R345.2; also elsewhere on the board
USB_DN: J301.A7 (D-), J301.B7 (D-), U301.3 (I/O2), U301.4 (I/O2); also elsewhere on the board
USB_DP: J301.A6 (D+), J301.B6 (D+), U301.1 (I/O1), U301.6 (I/O1); also elsewhere on the board
VBUS: C352.1, D301.1 (A1), J301.A4 (VBUS), J301.A9 (VBUS), J301.B4 (VBUS), J301.B9 (VBUS), Q305.5 (D), R305.1, U302.5 (VBUS), U306.3 (CE), U306.5 (VIN)

Notes on the sheet:
IP2366 application per Injoinic datasheet V1.10 fig. 9. Settings: 3S (6.2k), 4.2V/cell (9.1k), 30W (3.6k).
DPC/DMC (QC/FCP/AFC) left unconnected: USB D+/D- go to the CH340 console. PD on CC still negotiates 5-20V.
Q1-Q4 any 30-40V N-MOSFET, ~5 mOhm, TDSON/DFN5x6 (IP2366 ref: AER4061BE). Q5 optional input switch (R5 bypass).
Pi 5V buck (+5V_BUCK, feeds the Pi through the back-power ideal diode on the Pi sheet): Vout = 0.76*(1+R31/R32) = 5.14 V. EN driven by supervisor (PI_PWR_EN).
Sub PVDD boost (optional): Vout = 0.6*(1+R41/R42) = 17.1 V. R44 (fitted) feeds PVDD_SUB from +BATT, R45 instead from the boost.
