z2labs/Bassberry/hardware/bassberry/bassberry.kicad_pcb

## KiCad design hardware/bassberry/bassberry.kicad_pcb (continued)

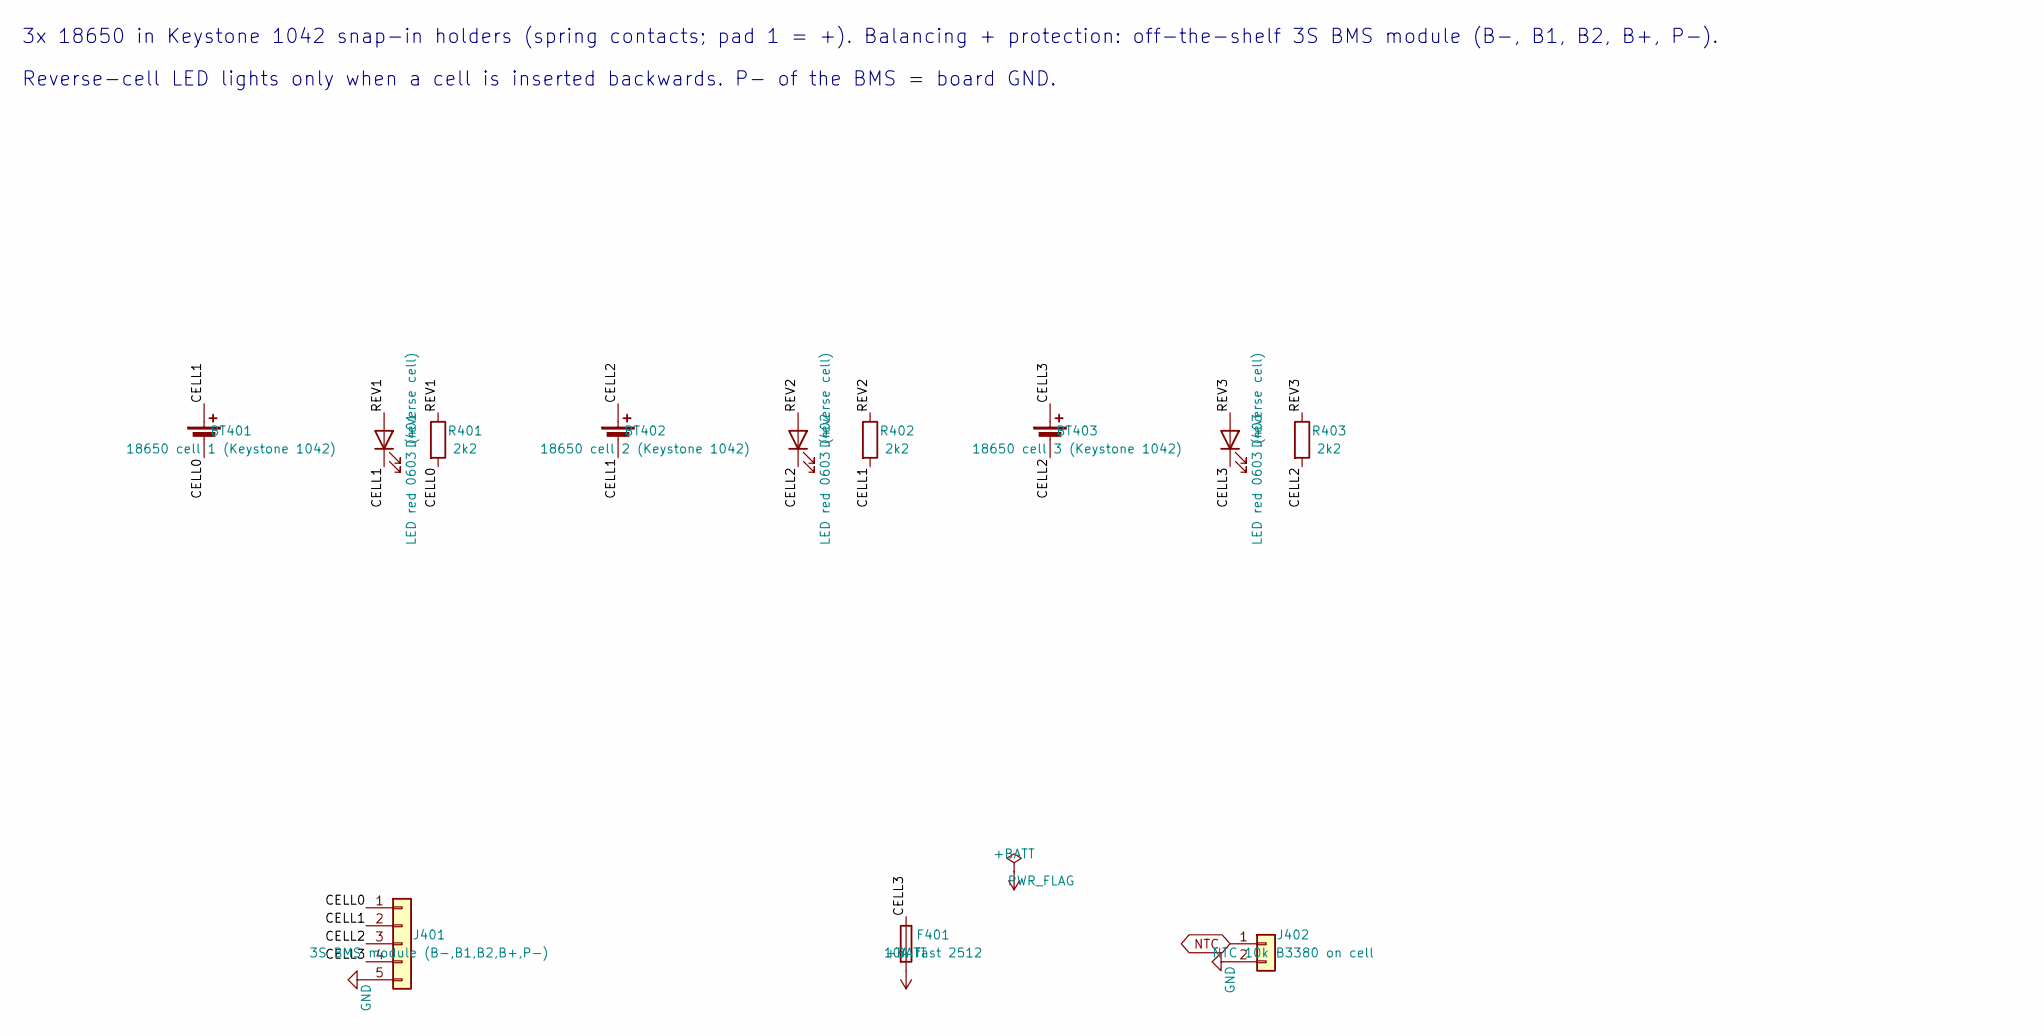
[picture p29: schematic battery.kicad_sch, Battery: 3S 18650 clips, BMS module, protection]

Parts:
BT401: 18650 cell 1 (Keystone 1042); BatteryHolder_Keystone_1042_1x18650
BT402: 18650 cell 2 (Keystone 1042); BatteryHolder_Keystone_1042_1x18650
BT403: 18650 cell 3 (Keystone 1042); BatteryHolder_Keystone_1042_1x18650
D401, D402, D403: LED red 0603 (reverse cell); LED_0603_1608Metric
F401: 10A fast 2512; Fuse_2512_6332Metric
J401: 3S BMS module (B-,B1,B2,B+,P-); SolderWire-1sqmm_1x05_P5.4mm_D1.4mm_OD2.7mm
J402: NTC 10k B3380 on cell; JST_PH_B2B-PH-K_1x02_P2.00mm_Vertical
R401, R402, R403: 2k2; R_0603_1608Metric

Connections:
+BATT: F401.2; also elsewhere on the board
/battery/CELL0: BT401.2 (-), J401.1, R401.2
/battery/CELL1: BT401.1 (+), BT402.2 (-), D401.1 (K), J401.2, R402.2
/battery/CELL2: BT402.1 (+), BT403.2 (-), D402.1 (K), J401.3, R403.2
/battery/CELL3: BT403.1 (+), D403.1 (K), F401.1, J401.4
/battery/REV1: D401.2 (A), R401.1
/battery/REV2: D402.2 (A), R402.1
/battery/REV3: D403.2 (A), R403.1
GND: J401.5, J402.2; also elsewhere on the board
NTC: J402.1; also elsewhere on the board

Notes on the sheet:
3x 18650 in Keystone 1042 snap-in holders (spring contacts; pad 1 = +). Balancing + protection: off-the-shelf 3S BMS module (B-, B1, B2, B+, P-).
Reverse-cell LED lights only when a cell is inserted backwards. P- of the BMS = board GND.

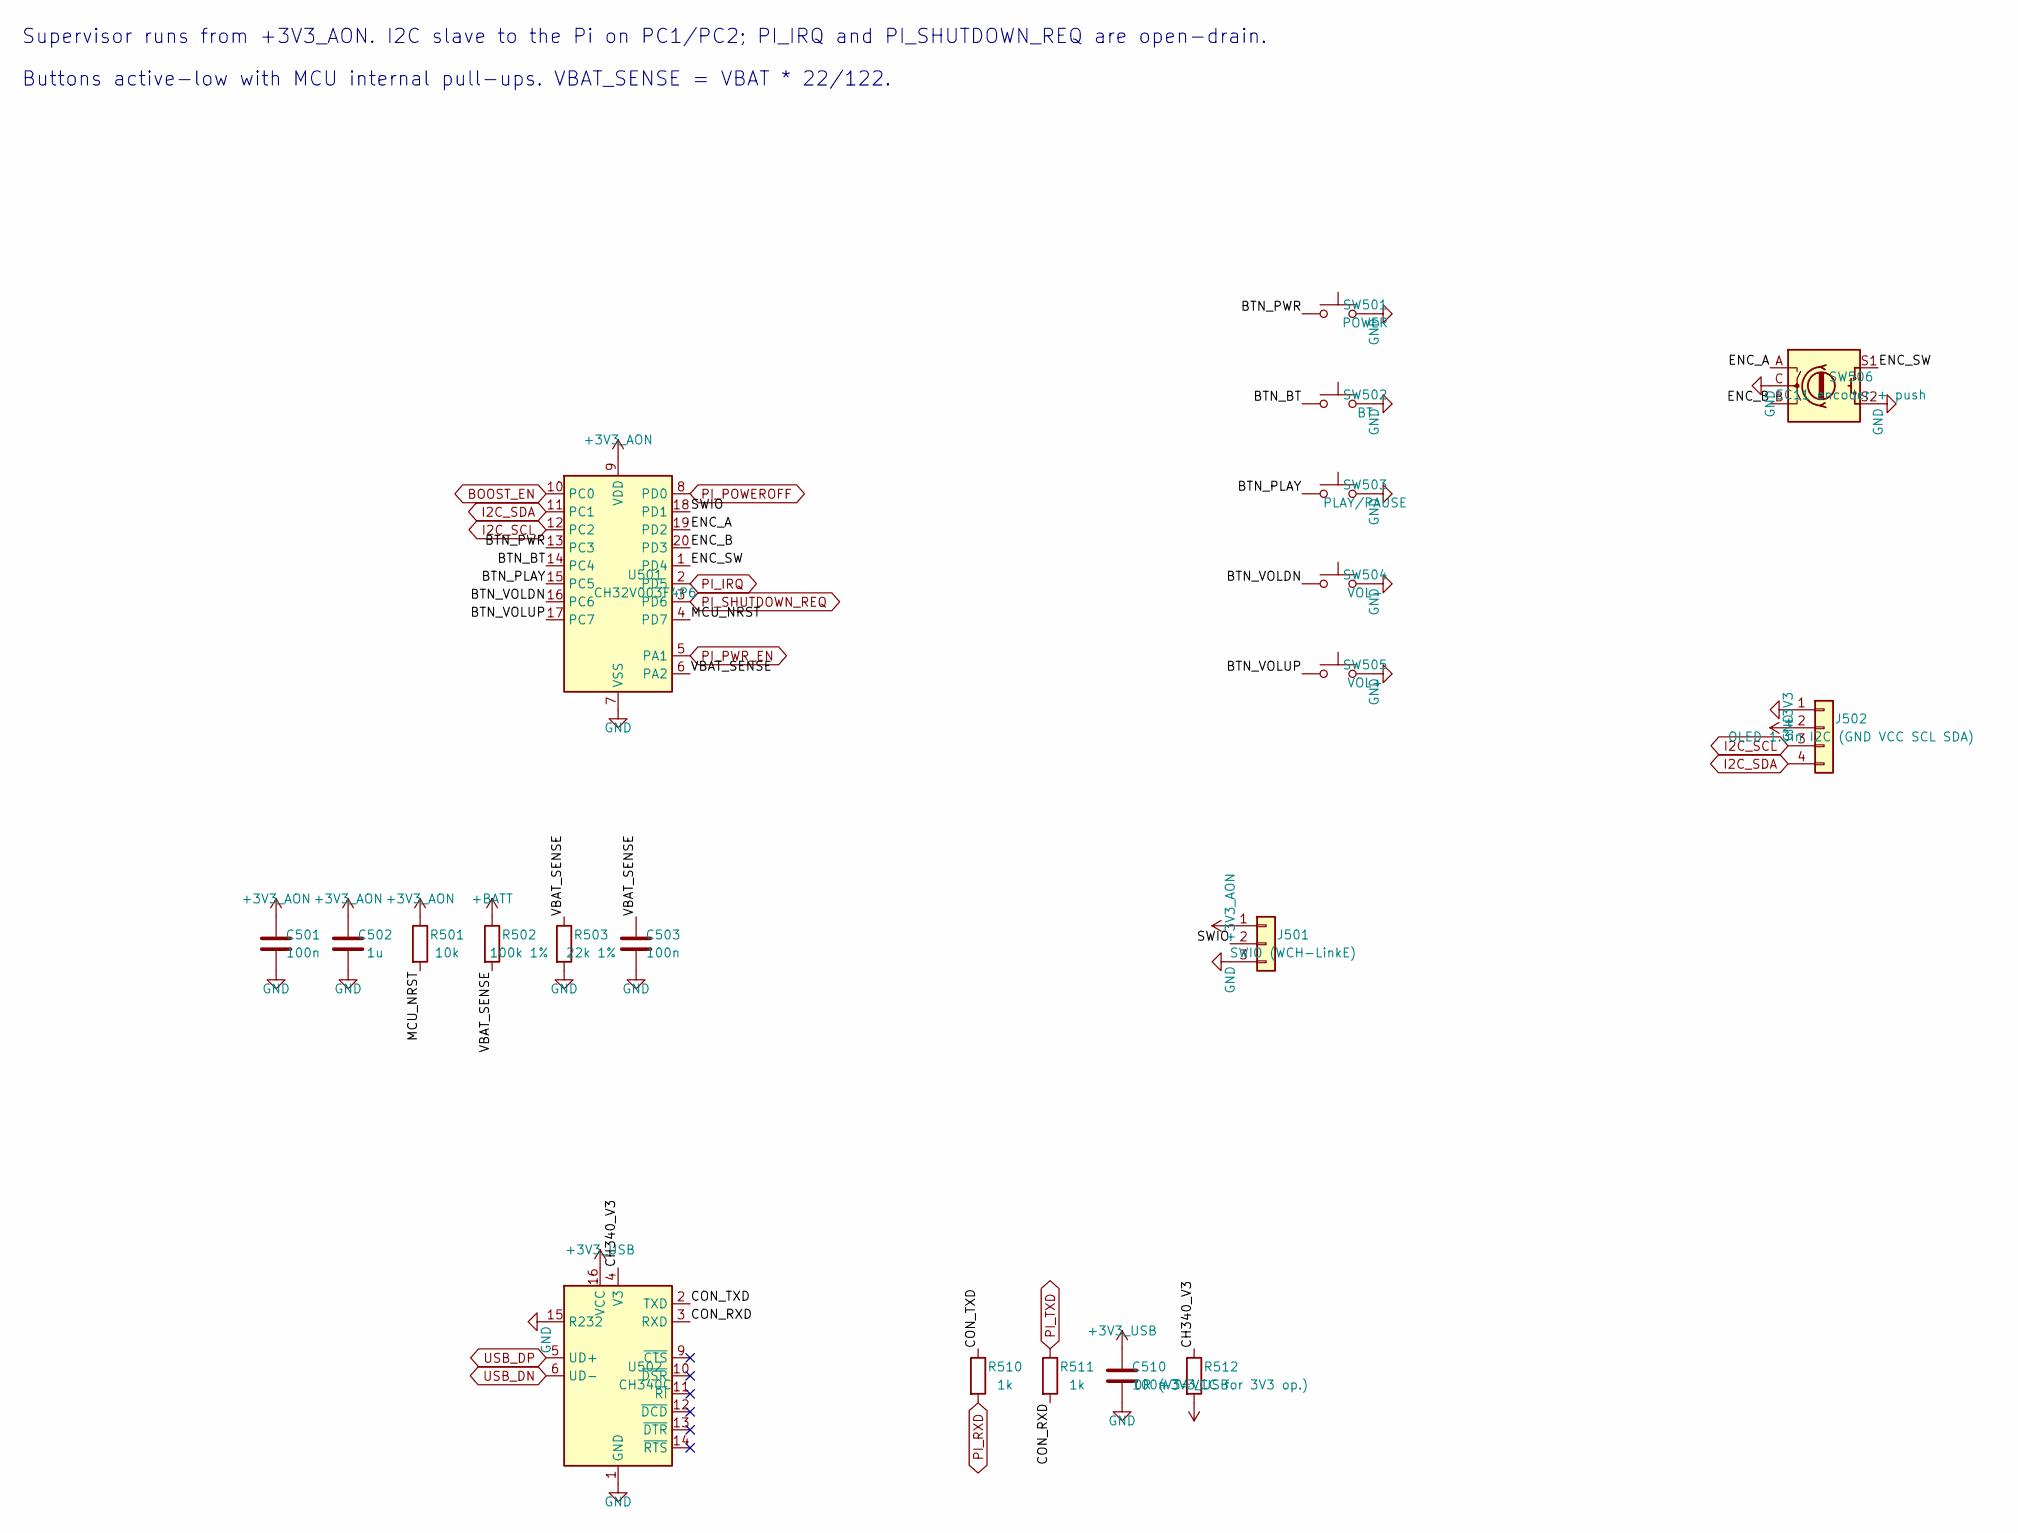
[picture p30: schematic ui.kicad_sch, UI + supervisor MCU (CH32V003), OLED, buttons, encoder, USB…]

Parts:
C501, C503, C510: 100n; C_0603_1608Metric
C502: 1u; C_0603_1608Metric
J501: SWIO (WCH-LinkE); PinHeader_1x03_P2.54mm_Vertical
J502: OLED 1.3in I2C (GND VCC SCL SDA); PinSocket_1x04_P2.54mm_Horizontal
R501: 10k; R_0603_1608Metric
R502: 100k 1%; R_0603_1608Metric
R503: 22k 1%; R_0603_1608Metric
R510, R511: 1k; R_0603_1608Metric
R512: 0R (V3=VCC for 3V3 op.); R_0603_1608Metric
SW501: POWER; SW_SPST_TL3342
SW502: BT; SW_SPST_TL3342
SW503: PLAY/PAUSE; SW_SPST_TL3342
SW504: VOL-; SW_SPST_TL3342
SW505: VOL+; SW_SPST_TL3342
SW506: EC11 encoder + push; RotaryEncoder_Alps_EC11E-Switch_Vertical_H20mm
U501: CH32V003F4P6; TSSOP-20_4.4x6.5mm_P0.65mm
U502: CH340C; SOIC-16_3.9x9.9mm_P1.27mm

Connections:
+3V3: J502.2; also elsewhere on the board
+3V3_AON: C501.1, C502.1, J501.1, R501.1, U501.9 (VDD); also elsewhere on the board
+3V3_USB: C510.1, R512.2, U502.16 (VCC); also elsewhere on the board
+BATT: R502.1; also elsewhere on the board
/ui/BTN_BT: SW502.1, U501.14 (PC4)
/ui/BTN_PLAY: SW503.1, U501.15 (PC5)
/ui/BTN_PWR: SW501.1, U501.13 (PC3)
/ui/BTN_VOLDN: SW504.1, U501.16 (PC6)
/ui/BTN_VOLUP: SW505.1, U501.17 (PC7)
/ui/CH340_V3: R512.1, U502.4 (V3)
/ui/CON_RXD: R511.2, U502.3 (RXD)
/ui/CON_TXD: R510.1, U502.2 (TXD)
/ui/ENC_A: SW506.A, U501.19 (PD2)
/ui/ENC_B: SW506.B, U501.20 (PD3)
/ui/ENC_SW: SW506.S1, U501.1 (PD4)
/ui/MCU_NRST: R501.2, U501.4 (PD7)
/ui/SWIO: J501.2, U501.18 (PD1)
/ui/VBAT_SENSE: C503.1, R502.2, R503.1, U501.6 (PA2)
BOOST_EN: U501.10 (PC0); also elsewhere on the board
GND: C501.2, C502.2, C503.2, C510.2, J501.3, J502.1, R503.2, SW501.2, SW502.2, SW503.2, SW504.2, SW505.2, SW506.C, SW506.S2, U501.7 (VSS), U502.1 (GND), U502.15 (R232); also elsewhere on the board
I2C_SCL: J502.3, U501.12 (PC2); also elsewhere on the board
I2C_SDA: J502.4, U501.11 (PC1); also elsewhere on the board
PI_IRQ: U501.2 (PD5); also elsewhere on the board
PI_POWEROFF: U501.8 (PD0); also elsewhere on the board
PI_PWR_EN: U501.5 (PA1); also elsewhere on the board
PI_RXD: R510.2; also elsewhere on the board
PI_SHUTDOWN_REQ: U501.3 (PD6); also elsewhere on the board
PI_TXD: R511.1; also elsewhere on the board
USB_DN: U502.6 (UD-); also elsewhere on the board
USB_DP: U502.5 (UD+); also elsewhere on the board

Notes on the sheet:
Supervisor runs from +3V3_AON. I2C slave to the Pi on PC1/PC2; PI_IRQ and PI_SHUTDOWN_REQ are open-drain.
Buttons active-low with MCU internal pull-ups. VBAT_SENSE = VBAT * 22/122.

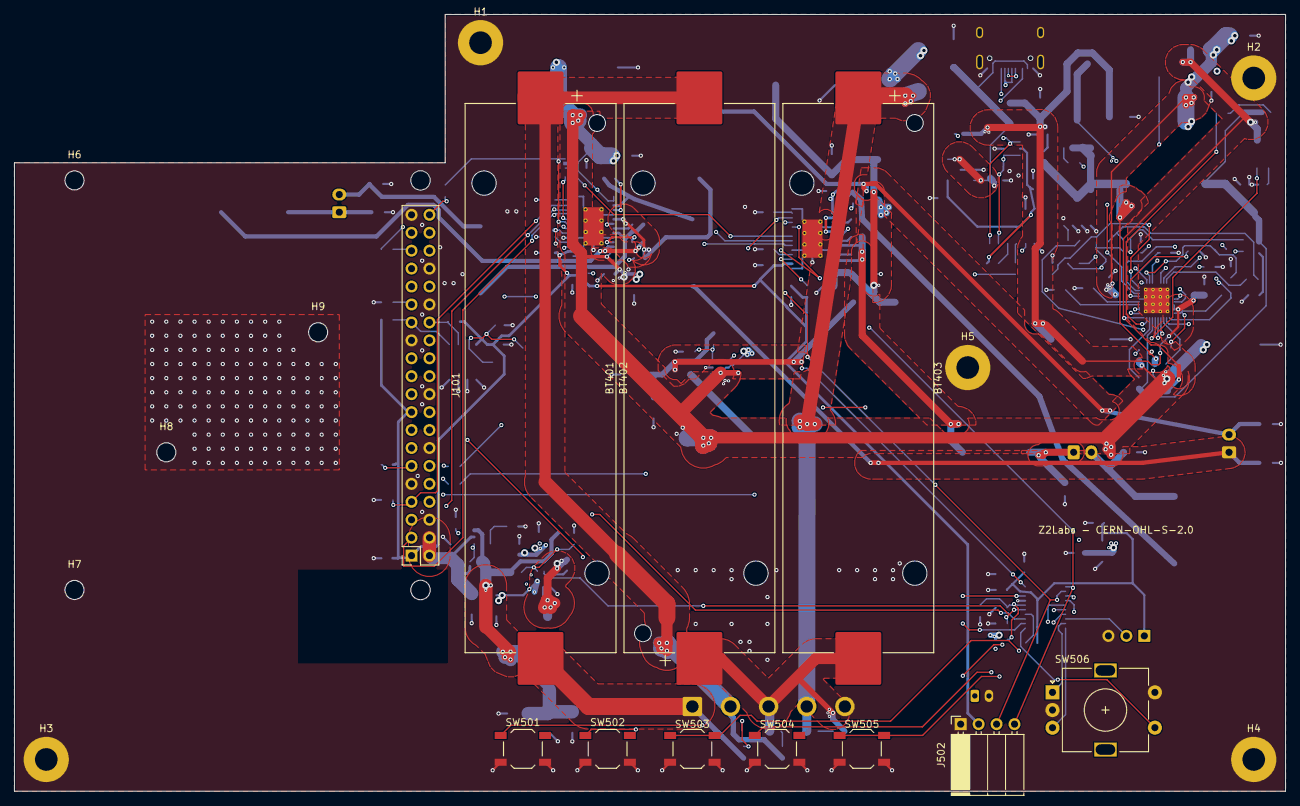
[picture p31: board bassberry.kicad_pcb from above]

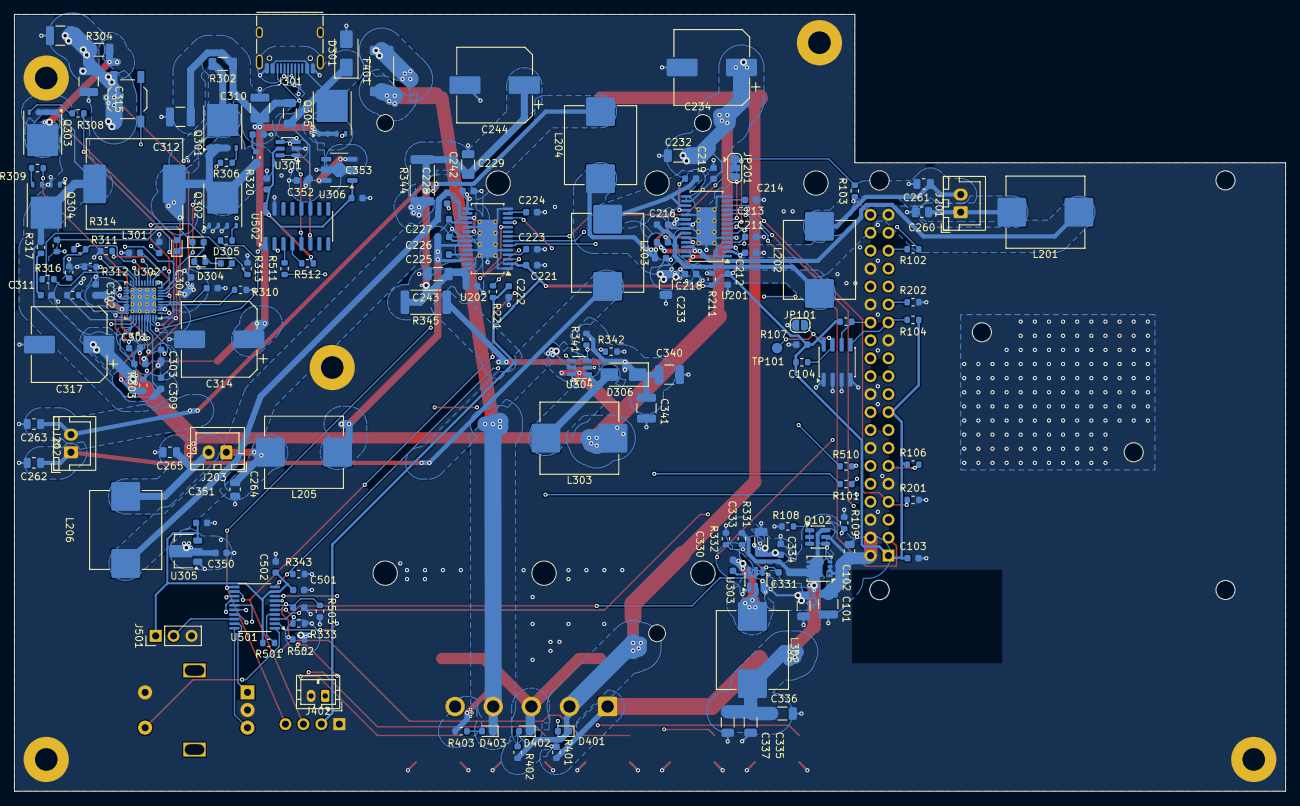
[picture p32: board bassberry.kicad_pcb from below]

Board: 4 copper layers, 180.0 x 110.0 mm, 188 parts (168 on the bottom side), 124 nets.

Other parts of the board:
H1, H2, H3, H4, H5: MountingHole_3.2mm_M3_Pad
H6, H7, H8, H9: MountingHole_2.7mm_M2.5

Their connections:
GND: H1.1, H2.1, H3.1, H4.1, H5.1; also elsewhere on the board
