z2labs/Bassberry/hardware/tools/sexpr.py

"""Tiny s-expression reader/writer for KiCad files (no dependencies)."""
import re

_TOK = re.compile(r'\s*(?:(\()|(\))|("(?:[^"\\]|\\.)*")|([^\s()"]+))')


class Sym(str):
    """Bare atom (unquoted)."""


def parse(text):
    stack, cur = [], []
    pos = 0
    n = len(text)
    while pos < n:
        m = _TOK.match(text, pos)
        if not m:
            if text[pos:].strip() == "":
                break
            raise ValueError(f"parse error at {pos}: {text[pos:pos+40]!r}")
        pos = m.end()
        o, c, s, a = m.groups()
        if o:
            stack.append(cur); cur = []
        elif c:
            done = cur; cur = stack.pop(); cur.append(done)
        elif s is not None:
            cur.append(s[1:-1].replace('\\"', '"').replace("\\\\", "\\"))
        elif a is not None:
            cur.append(Sym(a))
    return cur[0] if len(cur) == 1 else cur


def q(s):
    return '"' + str(s).replace("\\", "\\\\").replace('"', '\\"') + '"'


def dump(node, indent=0):
    if isinstance(node, list):
        if not node:
            return "()"
        simple = all(not isinstance(x, list) for x in node)
        if simple:
            return "(" + " ".join(dump(x) for x in node) + ")"
        out = "(" + dump(node[0])
        for x in node[1:]:
            if isinstance(x, list):
                out += "\n" + "\t" * (indent + 1) + dump(x, indent + 1)
            else:
                out += " " + dump(x)
        return out + "\n" + "\t" * indent + ")"
    if isinstance(node, Sym):
        return str(node)
    if isinstance(node, bool):
        return "yes" if node else "no"
    if isinstance(node, (int, float)):
        s = f"{node:.4f}".rstrip("0").rstrip(".")
        return s if s not in ("-0", "") else "0"
    return q(node)


def find(node, key):
    return [x for x in node if isinstance(x, list) and x and x[0] == key]


def find1(node, key):
    r = find(node, key)
    return r[0] if r else None
