z2labs/Bassberry/(commit log)

2026-10-26 Bassberry: concept, acoustic simulation, docs, banner, render script
    Open-source hi-fi 2.1 Raspberry Pi speaker: architecture, lumped-element
    acoustic model (sats + PR-loaded down-firing sub), driver comparison,
    BOM draft, battery guide for recycled 18650 cells, animated README banner
    and Blender Cycles render script.
    Claude-Session: https://claude.ai/code/session_01And32TPe5c6qaHngZgqamN
    [response.csv]
2026-10-26 Add Blender Cycles renders: exterior, rear, top, interior, exploded, board
    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
2026-10-26 hardware/tools: s-expr reader and KiCad symbol pin helpers
    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
2026-10-26 hardware: label-based schematic generator + Pi and audio sheets (WIP)
    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
2026-10-26 hardware/tools: footprint pad dump helper
    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
2026-10-26 hardware: power (IP2366, buck, boost, LDOs), battery and UI sheets
    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
2026-10-26 hardware: ERC fixes (flags, CH340 V3, inductor footprints, DVDD 4u7)
    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
    [bassberry_sch.py, projlib.py]
2026-10-26 hardware: unique refs per sheet, PCB skeleton builder
    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
2026-10-26 hardware: annotate battery clips BT401-BT406
    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
2026-10-26 hardware: fix duplicate audio cap references
    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
    [bassberry_sch.py]
2026-10-26 hardware: PCB placement regions, Pi auto-orientation, B+ hole pattern
    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
2026-10-26 hardware: fix Pi socket placement offset
    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
    [pcb_build.py]
2026-10-26 hardware: open Pi-port corner, hole fix, gitignore for KiCad outputs
    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
    [pcb_build.py]
2026-10-26 hardware: generated KiCad 10 project (schematic 6 sheets, PCB skeleton)
    Generated by hardware/tools/bassberry_sch.py and pcb_build.py.
    ERC: 2 expected errors (TAS5805M PBTL pre-filter output pairing per TI fig. 8-2).
    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
    [audio.kicad_sch, bassberry.kicad_pcb, bassberry.kicad_sch, battery.kicad_sch, pi.kicad_sch, power.kicad_sch, ui.kicad_sch]
2026-10-26 docs: KiCad 3D renders of the rev 0.1 board, schematic PDF
    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
2026-10-26 hardware: HAT+ ID EEPROM per RPi design guide (CAT24C32, 1k WP + TP), back-power ideal diode, rails as power symbols
2026-10-26 hardware: rev 0.2 functional placement (pcb_build.py)
2026-10-26 hardware: placement fixes, plot helper
    [pcb_build.py]
2026-10-26 hardware: Pi mapping from mechanical drawings (thermal pad covers Pi 4 + Pi 5 SoC, antenna keepout), cell polarity
2026-10-26 schematic: short sheet names (pi/audio/power/battery/ui) so net names are /power/CHG_LX1
    [pcb_build.py, schgen.py]
2026-10-26 hardware: board_geom shared module, route.py (srouter 3-pass), DRC rule file
2026-10-26 twin: layer 2 (face-down Pi: hole fit, pin-by-pin geometric join, ports/SoC/antenna/shadow)
2026-10-26 twin_plug: KiCad 10 outline API
2026-10-26 twin: layer 3 (ampacity, vias per layer change, Pi 5 V IR drop, set-points, LDO dissipation)
2026-10-26 docs: BOM/battery for rev 0.2 (Keystone 1042, IP2366, HAT EEPROM, ZVD)
2026-10-26 twin: layer 4 mechanics (cell holders, edges, lid controls, holes)
2026-10-26 placement: cells 1.5 mm forward, H1/R304/encoder moved clear of screw heads (twin layer 4)
2026-10-26 placement: J401/J502/encoder clearances; twin_plug samples inside the Pi width
    [pcb_build.py, twin_plug.py]
2026-10-26 placement: encoder origin is pad A, body extends +16 mm
2026-10-26 postroute.ps1: USAGE.md order + DRC with schematic parity + all twin layers
2026-10-26 routing: widths clipped to the smallest pad (srouter check), fatten.py widens power copper + parallel vias after pass 1, clearance 0.15
    [fatten.py, pcb_build.py, route.py]
2026-10-26 twin layer 3: max-flow ampacity between real current terminals
2026-10-26 routing: charger/amp local nets in pass 1; fatten keeps a 0.5 mm escape lane around foreign pads
2026-10-26 route.py: 0.2 mm on nets that touch 0.4 mm-pitch pins
2026-10-26 placement: charger QFN faces its power stage, gate resistors/snubbers at the FETs
2026-10-26 placement: 0.6 mm courtyard gap so every pad keeps an escape lane
2026-10-26 placement: every drilled hole (incl. holder NPTH pegs) blocks the other side
2026-10-26 route.py: escape-probe gate before routing
2026-10-26 hardware README: rev 0.2 flow, layer roles, twin
2026-10-26 routing: dog-bone fan-out for the IP2366 QFN; USB-C moved to the bottom with its circuitry
2026-10-26 placement: anchors are collision-checked (spiral from the anchor); hard set only for mechanics
    [pcb_build.py]
2026-10-26 placement: USB-C mouth faces the rear edge (was turned 180 deg, pads off the board)
2026-10-26 twin layer 4: USB-C pads must sit on the board behind the mouth (+ injected fault)
2026-10-26 route.py: all IP2366 pin nets (global LED/NTC too) in pass 1
2026-10-26 placement: 2 mm fan-out ring around the IP2366 QFN
2026-10-26 silk: board title on two lines inside the outline
2026-10-26 USB-side LDO: XC6216B332PR (28 V, 500 mW) instead of HT7533 (fails at a 20 V PD contract); power_pour.py; twin layer 3 rasterised max-flow incl. pours
    [bassberry_sch.py, power_pour.py, projlib.py, spec_bassberry.py]
2026-10-26 postroute: power pours after track_tidy; U306 decoupling partners
2026-10-26 full_flow.ps1 (unattended schematic->placement->gates->route->post->DRC->twin); utf8 logs
2026-10-26 routing: pass 1a high-current nets on the outer layers only (vias avoided), 1b local; twin raster keeps thin diagonal runs connected
    [route.py]
2026-10-26 mounting holes are board-only footprints (schematic parity)
2026-10-26 GND reachability: pours keep a 1.6 mm moat around GND pads, QFN with thermal vias, IC GND pins tied to their exposed pad
2026-10-26 power_pour: keep the moat holes in the zone outline
2026-10-26 postroute: walled-in GND pads rescued (gnd_pad_rescue) before gnd_stitch
2026-10-26 pcb_build: fix usb_crossover def; full_flow stops when placement fails
    [pcb_build.py]
2026-10-26 routing: 1a only for high-current nets clear of fine-pitch pins; QFN/TAS power nets negotiate in 1b (inner layer + vias expensive); fatten after 1b
2026-10-26 GND dog-bone vias for every SMD GND pad before routing (no orphan GND pads after the pours); no gnd_pad_rescue
2026-10-26 dog-bones placed after holes and the SoC via field
2026-10-26 dog-bones: second, relaxed pass for tight GND pins
    [pcb_build.py]
2026-10-26 Placement: library IDs and DNP from the netlist, Pi socket courtyard = header, solid GND pad connection, axis-only GND ties with clearance, plain M2.5 holes, JLC annular/edge rules, refill before DRC
    [board_geom.py, pcb_build.py]
2026-10-26 twin layer 3: report where the min cut (neck) of a failing current path is
2026-10-26 power_pour: In1 pours, GND moat only for pads without their own via, parallel vias per layer change (ceil(I/1.5 A))
2026-10-26 power_pour: read the tracks before the old pours are removed
2026-10-26 route: pass 0 power trunks - high-current nets routed wide between their big pads (net split), taps joined later at pad width
2026-10-26 Flow: rip-up/reroute repair for stuck nets, tidy_guard re-joins pads track_tidy pulled tracks off, L-shaped GND ties for row-end pins, BOM/DNP attributes follow the schematic, duplicate via removal
    [pcb_build.py, power_pour.py, route.py, tidy_guard.py]
2026-10-26 Power copper: pours split the gap between high-current nets (priority by current), vias grow to 1.0/0.5 mm or get parallel vias by current (twin: via capacity scales with drill), passives go on the o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
2026-10-26 fatten: via capacity by drill, grow the via to 1.0/0.5 mm first, denser search for parallel vias
2026-10-26 tidy_guard: also re-join track pieces the tidy separated
2026-10-26 GND ties: stub slightly narrower than the pin (QFN 0.25 mm pins hit the clearance exactly)
    [pcb_build.py]
2026-10-26 power_pour: drop pour pieces that touch nothing of their own net
2026-10-26 Power: In1 +BATT plane with taps from every +BATT pad; buck inductor straight off the SW pin (inductors placed before caps), Q101 moved left
2026-10-26 power_pour: dead-piece test samples the whole track
2026-10-26 Placement: buck IC turned so its SW pin faces the inductor, inductor pad 1 faces the IC
2026-10-26 twin layer 3: max-flow in a growing window around the pads (conservative, fast enough for a board-wide plane)
2026-10-26 route repair: reload the board after ripping up
2026-10-26 route repair: each rip-up / reroute step in its own pcbnew process
2026-10-26 Routing congestion: no 1.0/0.5 mm vias between router passes (post-route only), placement order back to plain
2026-10-26 GND links for pins with no room for a via, near-duplicate via merge, tidy_guard removes dangling stubs
2026-10-26 GND links: reach 6 mm
2026-10-26 GND links keep the 0.5 mm escape lane (one walled in U201.2-4: caught by the escape gate); full_flow stops when routing fails
    [pcb_build.py]
2026-10-26 power_pour: parallel via joined by stubs where the pour does not reach it
2026-10-26 Placement: ZVD PFET source pins face the Pi 5V pins
2026-10-26 GND dog-bones third pass with 0.45/0.2 vias (between the pin rows); near-duplicate via merge bridges instead of moving tracks (moved ends broke clearance and connectivity)
    [pcb_build.py, power_pour.py]
2026-10-26 route: speaker paths in their own one-layer pass (no vias in 2-3 A audio paths), battery-link trunks at their 2.4 mm target
2026-10-27 route: drop the one-layer amp pass (it walled the amp pin rows in); post-route parallel vias at netclass clearance incl. 0.45/0.2
    [power_pour.py, route.py]
2026-10-27 route: 2.4 mm trunks only for the battery links (+BATT at 2.4 crowded the amp pin rows)
2026-10-27 GND third pass only for parts without a GND exposed pad (vias at the amp row ends congested the amp escapes)
2026-10-27 Battery links: In1 copy of their corridor pours (joined by the holder through-hole contacts); trunks back to 1.6 mm
2026-10-27 rev 0.2 board: routed with srouter, DRC 0 errors / 0 unconnected / 0 parity, digital twin 1-4 PASS; KiCad files, reports, renders
    [audio.kicad_sch, bassberry.kicad_pcb, bassberry.kicad_sch, bassberry_placed.kicad_pcb, battery.kicad_sch, pi.kicad_sch, power.kicad_sch, ui.kicad_sch]
2026-10-27 tools: jlc_fab.ps1 (Gerber, Excellon, placement for JLCPCB)
2026-10-27 jlc_fab: same (absolute) origin for Gerber and drill
2026-10-27 Pi socket: no Pi Zero outline on the silkscreen (pcb_build + one-off pi_silk_fix.py)
2026-10-27 JLC: Gerber/drill zip and placement from the final board (Pi Zero silk outline removed, DRC still 0/0/0), BOM/CPL generator
    [bassberry.kicad_pcb, bassberry_pos_kicad.csv]
2026-10-27 JLC: BOM + CPL (86 lines, 168 placed, LCSC codes checked on jlcpcb.com/lcsc.com), not-assembled list, Gerber check, ordering notes
    [bassberry_bom_full.csv, bassberry_bom_jlc.csv, lcsc_parts.csv, not_assembled.csv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]
2026-10-27 JLC: per-side BOM/CPL (bottom = 158 parts), maker part number in the comment (JLC left 'BT' unmatched), README: choose the PCBA side
    [bassberry_bom_jlc.csv, bassberry_bom_jlc_bottom.csv, bassberry_bom_jlc_top.csv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]
2026-10-27 JLC: jlc_rotfix.py fits JLC's own (EasyEDA) footprints onto the pads for rotation + centre; JLC in-stock substitutes for holders, switches, encoder
    [bassberry_bom_full.csv, bassberry_bom_jlc.csv, bassberry_bom_jlc_top.csv, lcsc_parts.csv]
2026-10-27 jlc_rotfix: retry throttled EasyEDA requests
2026-10-27 jlc_rotfix: debug print
2026-10-27 jlc_rotfix: pin-consensus fit (exposed pads / tabs numbered differently do not drag it), rotation = KiCad pos + JLC-vs-KiCad footprint angle
2026-10-27 jlc_rotfix: verdict = every JLC pad lands on this footprint's copper; number matching when most pins share numbers
2026-10-27 JLC: holders back to Keystone 1042 (the substitute does not fit), encoder substitute noted
    [bassberry_bom_full.csv, bassberry_bom_jlc.csv, bassberry_bom_jlc_top.csv, lcsc_parts.csv]
2026-10-27 jlc_rotfix: pin agreement scales with part size (18650 holder)
2026-10-27 jlc_rotfix: 2-3 pin parts fitted on all pins
2026-10-27 jlc_rotfix: median pin translation for the position
2026-10-27 JLC CPL: rotations and centres fitted from JLC's own footprints (jlc_rotfix.py), report, README
    [rotfix_report.csv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]
2026-10-27 JLC: part numbers confirmed in stock by Zoltan (holders C5249310, TL3342F160QG C2886898, EC11E15244G1 C370970) are the source of truth
    [bassberry_bom_full.csv, bassberry_bom_jlc.csv, bassberry_bom_jlc_top.csv, lcsc_parts.csv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]
2026-10-27 JLC: CPL refitted for the confirmed parts; README
    [rotfix_report.csv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]
2026-10-27 JLC BOM: one line per LCSC code (no 'multiple lines matched to the same part' questions)
    [bassberry_bom_jlc.csv, bassberry_bom_jlc_bottom.csv, bassberry_bom_jlc_top.csv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]
2026-10-27 JLC_FAB.md: the JLC fabrication/assembly method and its pitfalls; JLC tools take --project / -Board (any KiCad project)
2026-10-27 DFM redesign: power tracks become pours (0.5 mm spine), vias never touch SMD pads (via_off_pad.py + placement rules), USB-C shell slots 0.7 mm
    [fatten.py, pcb_build.py, power_pour.py, via_off_pad.py]
2026-10-27 via_off_pad: move only vias that touch a pad; 0.15 mm if room, else 0.05 mm
2026-10-27 BOM: in-stock replacements for the JLC shortfalls (Q101 C264098, Q301-304 BSC059N04LS G, SW506 EC11E15244B2, U502 C84681), L301 FXL1360-220-M
    [bassberry_bom_full.csv, bassberry_bom_jlc.csv, bassberry_bom_jlc_bottom.csv, bassberry_bom_jlc_top.csv, lcsc_parts.csv, not_assembled.csv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]
2026-10-27 BOM: J502 right-angle socket C2897386; U306 stays global sourcing (no XC6216B332 at LCSC)
    [bassberry_bom_full.csv, bassberry_bom_jlc.csv, bassberry_bom_jlc_top.csv, lcsc_parts.csv, not_assembled.csv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]
2026-10-27 JLC CPL refitted: 170 parts, 0 land-pattern mismatches
    [rotfix_report.csv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]
2026-10-27 18650 holders: MYOUNG BH-18650-B1BA002 (C2988620) with own footprint from drawing WD-CP-0088
    Contacts 79.26 mm apart, D2.40 peg hole on the '+' end; pad 1 = '-', pad 2 = '+' as in JLC's EasyEDA model,
    so the CPL fit by pin number keeps the peg in its hole. Same frame as the Keystone 1042 it clones: placement
    rotations unchanged. Project footprint library (fp-lib-table, bassberry.pretty).
    [lcsc_parts.csv]
2026-10-27 JLC docs: BH-18650-B1BA002 holder, footprint-from-drawing rule
2026-10-27 twin layer 5: manufacturability against JLC DFM (via-pad, pad-pad, slot, silk-pad, silk-hole, ring, THT-SMD)
2026-10-27 postroute: twin layer 5 (JLC DFM) after DRC; silk_dfm from srouter feat/jlc-fab (via holes); dfm selftest compares counts
2026-10-27 JLC_FAB.md: DFM section (what DRC misses, how the flow fixes it); twin_dfm runs standalone too
2026-10-27 twin_dfm --fix-silk: silk still too close to a pad/hole on the real outline goes to Fab (postroute step 6a)
2026-10-27 twin_dfm selftest: drop pcbnew refs before deepcopy
2026-10-27 route: GND plane In2 open at a high cost (-top In2.Cu:30) in pass 1b, pass 3 and repair; closed for trunks, heavy and fast passes
2026-10-27 postroute: GND stitching with Z2 Stitch 0.3.0 headless (2.54 mm + 2 refinement levels, +BATT plane 'grid', rescue if islands)
2026-10-27 pcb_build: no GND dog-bone / link vias before routing (only exposed-pad and SoC thermal vias); GND is stitched at the end
2026-10-27 route: via keep-outs over SMD pads only in pass 2, pass 3 and repair (in the power passes they made pass 1b 6x slower and left 4 nets)
2026-10-27 route_metrics.py: per-run routing metrics (pass time, s/iteration, conflict curve, plateau, unrouted, DRC, twins, vias, track length per layer) -> route/metrics.jsonl + route/runs/<stamp>/; full_flow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
2026-10-27 route: srouter feat/early-stop build, -stall 10 on every pass and the repair
    [route.py]
2026-10-28 pcb_build: GND dog-bones before routing only for U201/U202/U302 (dense amp/charger ICs); every other GND via comes from the final Z2 stitching
2026-10-28 pcb_build: amp 2 output inductors L205/L206 next to the U202 output pins (were 40 mm away at J203)
2026-10-28 pcb_build: pre-route the amp bootstrap links (pin to BST cap); route: no via keep-outs over the USB-C pads (pre-routed D+ via)
2026-10-28 postroute: Z2 rescue joins every GND island (pads without a pre-route via); zero-length tracks removed before DRC; holder footprint without Datasheet field (schematic parity)
2026-10-28 route: PI_PWR_EN and BUCK_FB in pass 1b (their U303 pins were walled in by the buck copper: 'no path')
2026-10-28 Revert "route: PI_PWR_EN and BUCK_FB in pass 1b (their U303 pins were walled in by the buck copper: 'no path')"
    This reverts commit a8a6ae16d1703e168db843ce5c1f86f26b5facc2.
    [route.py]
2026-10-28 escape_via.py: stub + via out of a walled-in pin; pcb_build gives U303.5 (PI_PWR_EN, buck EN) one
2026-10-28 pcb_build: escape vias also for U501.2 (PI_IRQ) and U501.4 (MCU_NRST)
2026-10-28 route_metrics: keep the routed board of every run (route/runs/<stamp>/), so the best one can be finished
2026-10-28 pcb_build: U201 rotated 180 deg (outputs to J201, inputs facing U202: the bus gets a clear strip)
2026-10-28 variants by env: BB_U201_ROT (default 0 again), BB_BUS_FIRST (route the I2S/I2C bus before pass 1b)
2026-10-28 route: BB_BUS_FIRST=all lays the I2S/I2C/control bus (pass 2) before the trunks
2026-10-28 cong_plot.py: plot srouter -congmap (demand/capacity per gcell, H/V pools, overflowing cells with their nets)
2026-10-29 router benchmark: common bench input (0.15 mm clearance fix), board-level evaluation (_bench_eval.py), machine index normalisation, results of round 1 (srouter vs freerouting-rs, GPU wavefront parity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
